AREM-Projets/CdR-2024/README.md

# CdR-2024
Repo contenant l'ensemble des documents liés à la Coupe de France de Robotique (ou CdR pour Coupe de Robotique) 2024.

## Organisation du repo

Le dossier [Generalites](./Generalites) contient l'analyse du règlement ainsi que des ressources diverses. 

Le code, les PCBs et les modélisations 3D sont dans les dossiers PAMIs et Robot, selon leur utilisation.

La documentation associée à chaque partie du projet doit se trouver dans le README du dossier associé.

## Ajout de contenu

N'hésitez pas à ajouter vos tests divers sur ce repo.

Si vous pensez avoir cassé quelque chose, contactez le respo informatique.

## Dates de la CDR : 7 au 11 mai 2024

Merci à tous !!!
