AREM-Projets/CdR-2024/Robot/README.md

# Robot 

## Actionneur

### Informations utiles pour le pôle actionneur

* Hauteur de la bordure de l'aire de jeu: 70 mm

Plantes:
* Hauteur : 100 mm (env)
* Largeur à la base : 40 mm
* Largeur en haut du pot : 50 mm
* Hauteur du pot : 43 mm 

Pot:
* Largeur à la base: 43 mm
* Largeur en haut: 70 mm
* Hauteur: 65 mm
