AREM-Projets/CdR-2024/Generalites/README.md

# Documents et ressources liés à la Coupe de France de Robotique

## Code de l'AREM des anciennes éditions

### [2023](https://github.com/AREM-Projets/robot-CdR-2023)

### [2019-2022](https://gitlab.emse.fr/groups/arem/-/archived)

Vous aurez besoin des droits d'accès au gitlab de l'association pour consulter le code 2019-2022. Demander au respo informatique si besoin.

## Ressources extérieures

### [Maxi-liste de ressources par la team VRAC](https://github.com/VRAC-team/la-maxi-liste-ressources-eurobot)

### [Liste non exhaustive des capteurs présents au local](https://github.com/AREM-Projets/documentation-capteurs)

### [Formations faites en début d'année](https://github.com/AREM-Projets/formations-CdR-2024)

## Logiciels utiles

### Electronique

- [KiCAD](https://www.kicad.org/download/): logiciel de design de PCB, le lien vous amène directement sur la page de téléchargement

### Modélisation 3D

- [Autodesk Inventor](https://www.autodesk.com/education/edu-software/overview?sorting=featured&page=1) : logiciel pour faire de la modélisation 3D (Windows only)
- [FreeCAD](https://www.freecad.org/downloads.php) : logiciel gratuit pour faire de la modélisation 3D
- [Prusaslicer](https://www.prusa3d.com/page/prusaslicer_424/): site pour télécharger le software PrusaSlicer, vous importez un fichier 3D  et vous le transformez en .gcode pour l'imprimer

### Programmation

- [VSCode](https://code.visualstudio.com/Download) : bon éditeur de texte
- [PlatformIO](https://platformio.org/) : extension VSCode permettant d'envoyer du code sur des $\mu$contrôleurs

## Sites web utiles

### Electronique

- [SnapEda](https://www.snapeda.com/) : pour chercher des symboles, empreintes, modèle 3D et modèle de simulation. Marche tout aussi bien avec Proteus que KiCAD 

### Modélisation 3D

- [GrabCAD](https://grabcad.com/library) : pour chercher uniquement des modèles 3D de type .STEP, à utiliser si vous cherchez des modèles 3D de PCB (buck, NUCLEO...)

### Programmation

When in doubt, RTFM.

- [ducumentation PlatformIO](https://docs.platformio.org/en/latest/)
- [documentation STM32duino](https://github.com/stm32duino/Arduino_Core_STM32/wiki)
