AREM-Projets/CdR-2024/Robot/Code/README.md

# Code du robot CdR 2024

Ne pas créer de projet PlatformIO/CubeIDE directement dans ce dossier.

Créer un dossier contenant le projet à la place. Cela permettra d'avoir plusieurs projets pour les tests de différentes cartes/parties du robot.

Inclure dans ce README une description rapide de chaque projet(1-2 lignes), ainsi que la listes des personnes qui l'ont fait.

## RASPI4

Dossier contenant le code python tournant sur la raspi du robot.

## STM32_capteurs_actionneurs

Dossier contenant le projet STM32CubeIDE pour la carte gérant les capteurs et actionneurs.
