AREM-Projets/CdR-2024/Robot/PCBs/README.md

# PCBs - Robot principal

Chaque PCB doit être dans un dossier séparé. Il doit être présent à la fois sous la forme d'un schéma modifiable et au formt `.pdf` pour facilité de lecture.

Dans ce README, une description rapide (1-2 lignes) de son utilité doit être présente, ainsi que le nom des personnes qui l'ont designé.

# Liste des PCBs

### PCB n°1: ALIM 5V

Le PCB prend en entrée une tension 24V DC et la convertie en une tension 5V DC. On a 3A par buck et 4 ports de sortie JST-XH, soit 6A max au total pour 8 ports de sortie. La tension de sortie des bucks est réglable grâce au potentiomètre. Ce PCB peut donc être utilisé pour d'autres tension d'entrées et de sorties. De même, on peut récupérer directement le 24V pour les moteurs grâce à un port XT-60.  

Desiger : Cyril, Eliott

### PCB n°2: carte de mise en série

Permet de mettre en série deux batteries 12V.

Designer : Eliott
