AREM-Projets/CdR-2024/PAMIs/PCBs/README.md

# PCBs - PAMIs

Chaque PCB doit être dans un dossier séparé. Il doit être présent à la fois sous la forme d'un schéma modifiable et au formt `.pdf` pour facilité de lecture.

Dans ce README, une description rapide (1-2 lignes) de son utilité doit être présente, ainsi que le nom des personnes qui l'ont designé.

# Liste des PCBs

### Nom du PCB

Ca sert à quoi ???

Desiger : Quelqu'un, quelqu'un d'autre...

### Nom du PCB n°2

Et lui il sert à quoi ???

Designer : Lui
