AREM-Projets/CdR-2024/Robot/Modelisations-3D/Embase-2023/README.md

# Embase CdR 2023

Une embase faite pour le robot CdR 2023. 

Le robot était muni de 4 roues mécanum contrôlées par des moteurs pas à pas.

## Améliorations possibles 

- Ajouter un trou pour les fils des moteurs
- Ajouter un espace pour des capteurs effet Hall derrière les moteurs
- Changer les ressorts pour les adapter à un robot de 2-3kg
