AREM-Projets/CdR-2024/Generalites/Poster_cdr/explication_lidar.pdf

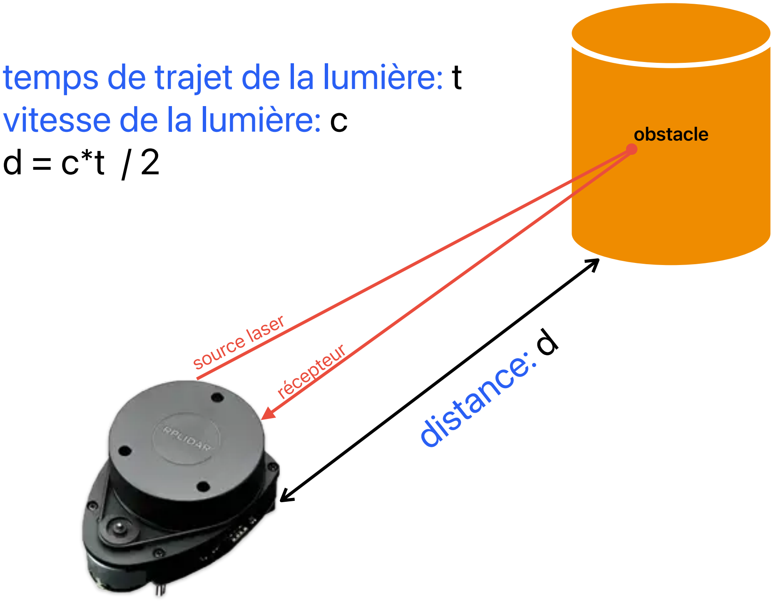
[picture p2: figure]
obstacle; distance: d; temps de trajet de la lumière: t vitesse de la lumière: c d = c*t / 2; source laser récepteur
