AREM-Projets/CdR-2024/Generalites/Poster_cdr/explications_carte_alim.pdf

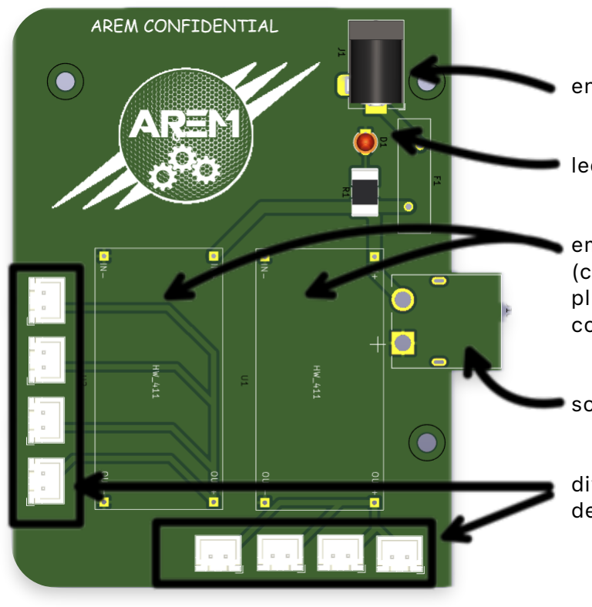
[picture p3: figure]

entrée d'alimentation 24V

led témoin d'alimentation

emplacements BUCs
(conversion 24V en tension plus basse) (tensions
continues)

sortie 24V vers les moteurs

diverses sorties d'alimentation des parties du robot
