AREM-Projets/CdR-2024/Generalites/Poster_cdr/explications_robot_eclate.pdf

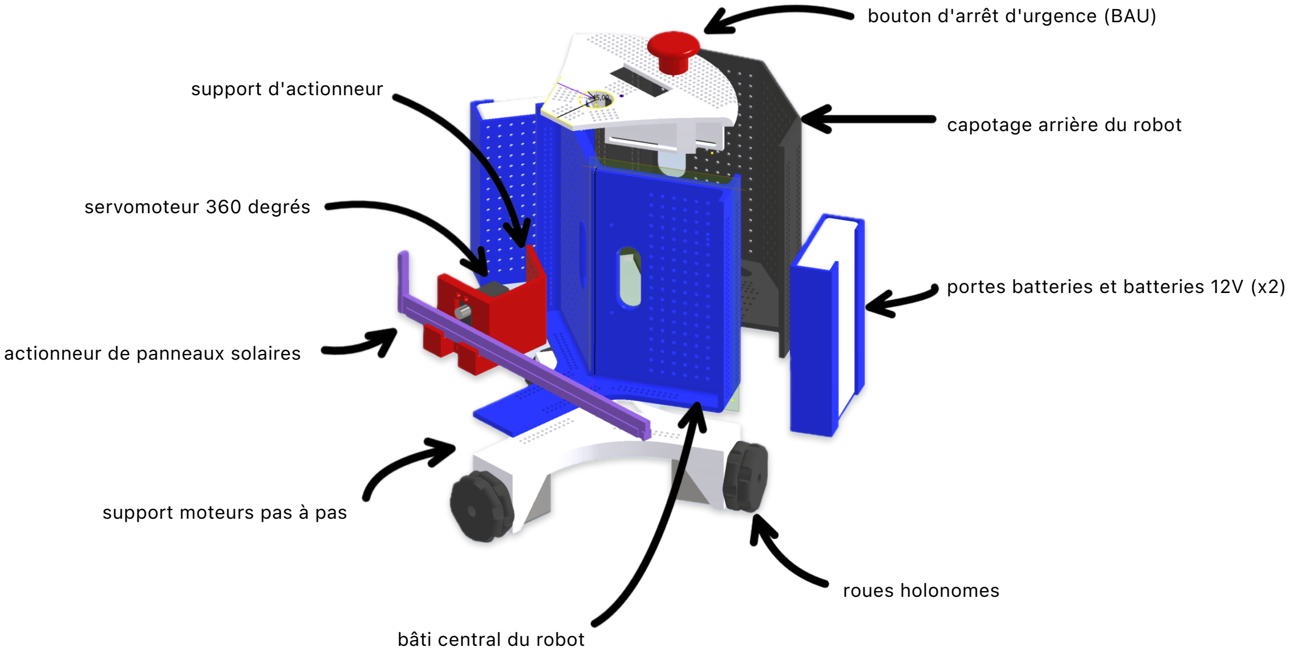
[picture p4: page 1]

bouton d'arrêt d'urgence (BAU)

portes batteries et batteries 12V (x2)

roues holonomes

actionneur de panneaux solaires

support moteurs pas à pas

support d'actionneur

servomoteur 360 degrés

capotage arrière du robot

bâti central du robot
