AREM-Projets/CdR-2024/PAMIs/Conception/Contraintes PAMIs.pdf

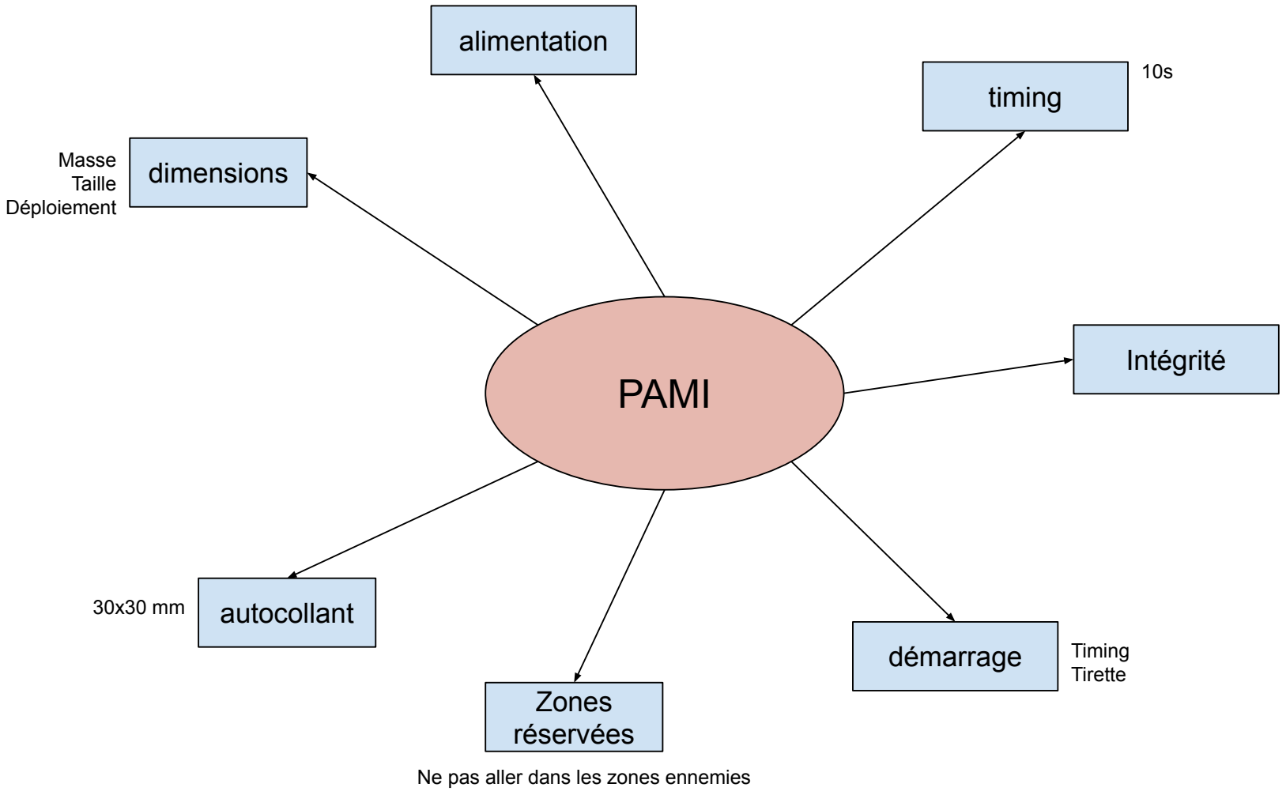
[picture p5: figure]
PAMI; dimensions; alimentation; démarrage; Timing; Tirette; Masse Taille Déploiement; autocollant ³⁰x30 mm; Zones réservées; Ne pas aller dans les zones ennemies; Intégrité; timing
