AREM-Projets/CdR-2024/Robot/Conception/Contraintes robot.pdf

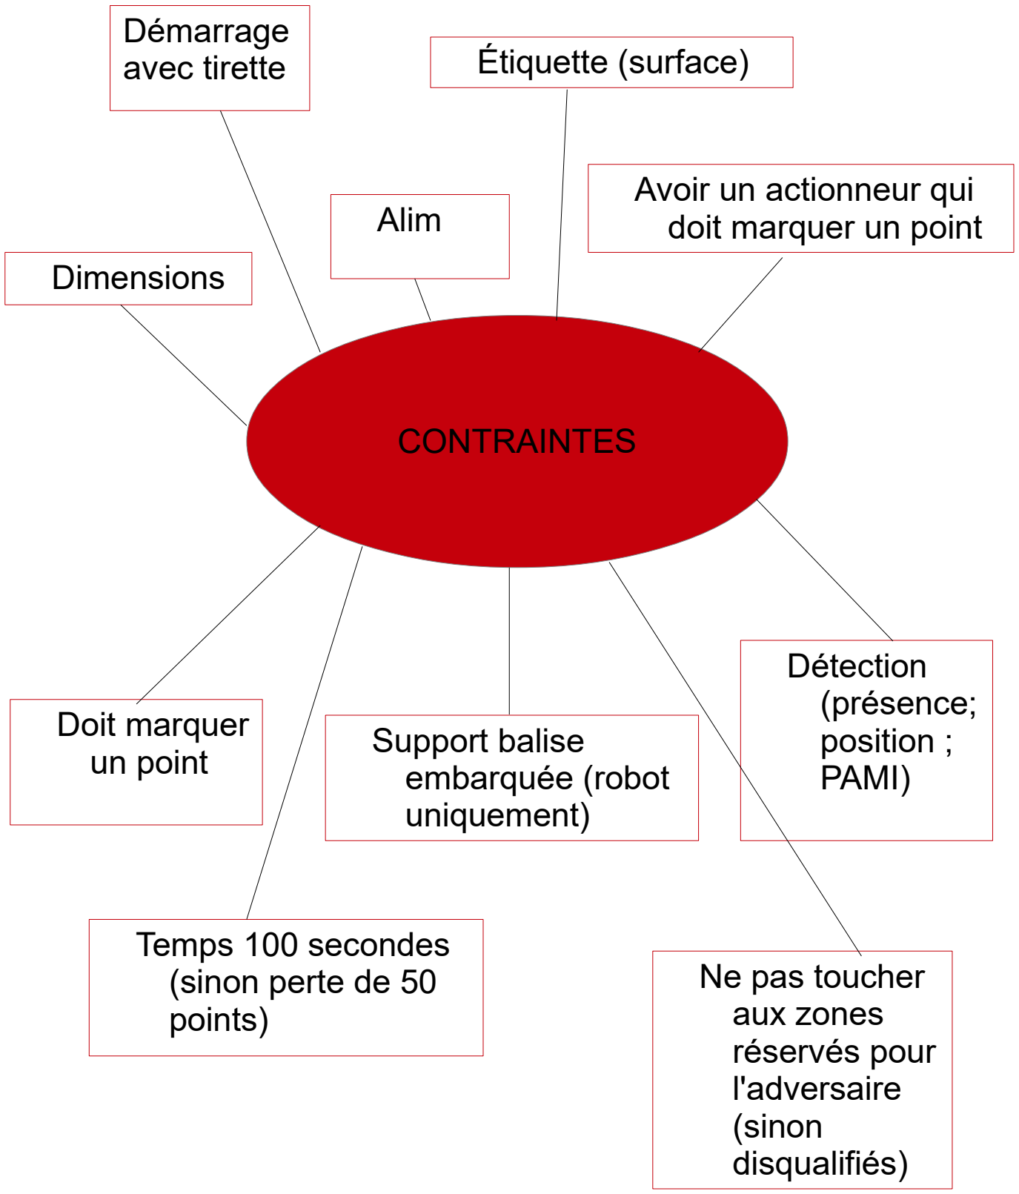
[picture p6: figure]
CONTRAINTES; Dimensions; Alim; Avoir un actionneur qui doit marquer un point; Doit marquer un point; Détection (présence; position ; PAMI); Étiquette (surface); Support balise embarquée (robot uniquement); Démarrage avec tirette; Ne pas toucher aux zones réservés pour l'adversaire (sinon disqualifiés); Temps 100 secondes (sinon perte de 50 points)
