AREM-Projets/CdR-2024/Robot/Code/stm32_to_ros/doc/MotorProfiling.pdf

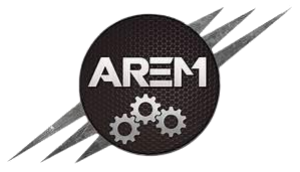
[picture p7: figure]

# [Component Test] Stepper Motor

Date : 08/01/22

Author : Adrien Komaroff-Kourloff

Purpose of the task:

- Principle: Operate the stepper motor that will be used on both robots. Write a brief report on its operation (including the written functions). Find the optimal operating parameters for the motor.
- Objectives: Familiarize yourself with the operation of stepper motors, prepare for their integration into the code.

## Ressources :

To understand the principle of a stepper motor: Stepper Motor Principle (http://ressources.univ-lemans.fr/AccesLibre/UM/Pedago/physique/02/electri/pasapas.html)

For information on micro-stepping: Microstepping Basics (https://www.linearmotiontips.com/microstepping-basics/)

The hardware connections to be made are detailed in the motor shield component test.

## Parameter Optimization

To achieve the best performance with the motors, it is necessary to have a good understanding of the parameters in the BlocMoteurs.h file :

Modify that struct : init for each motor

De L6470_init_t initShield[L6470DAISYCHAINSIZE]

For this purpose, I have adapted the content of this technical document, which is recommended reading: STMicroelectronics Voltage Mode Control Operation and Parameter Optimization. (https://www.st.com/resource/en/application_note/an4144-voltage-mode-control-operation-and-parameter-optimization-stmicroelectronics.pdf)

Please be aware that the library already performs some calculations after filling in L6470_init_t, and the units and quantities in this technical note may not be exactly the same as what needs to be filled in. You should adapt them based on a study of this library and its various functions.

To find the motor parameters, you need to have various parameters available in the motor datasheet and obtain them through measurement.

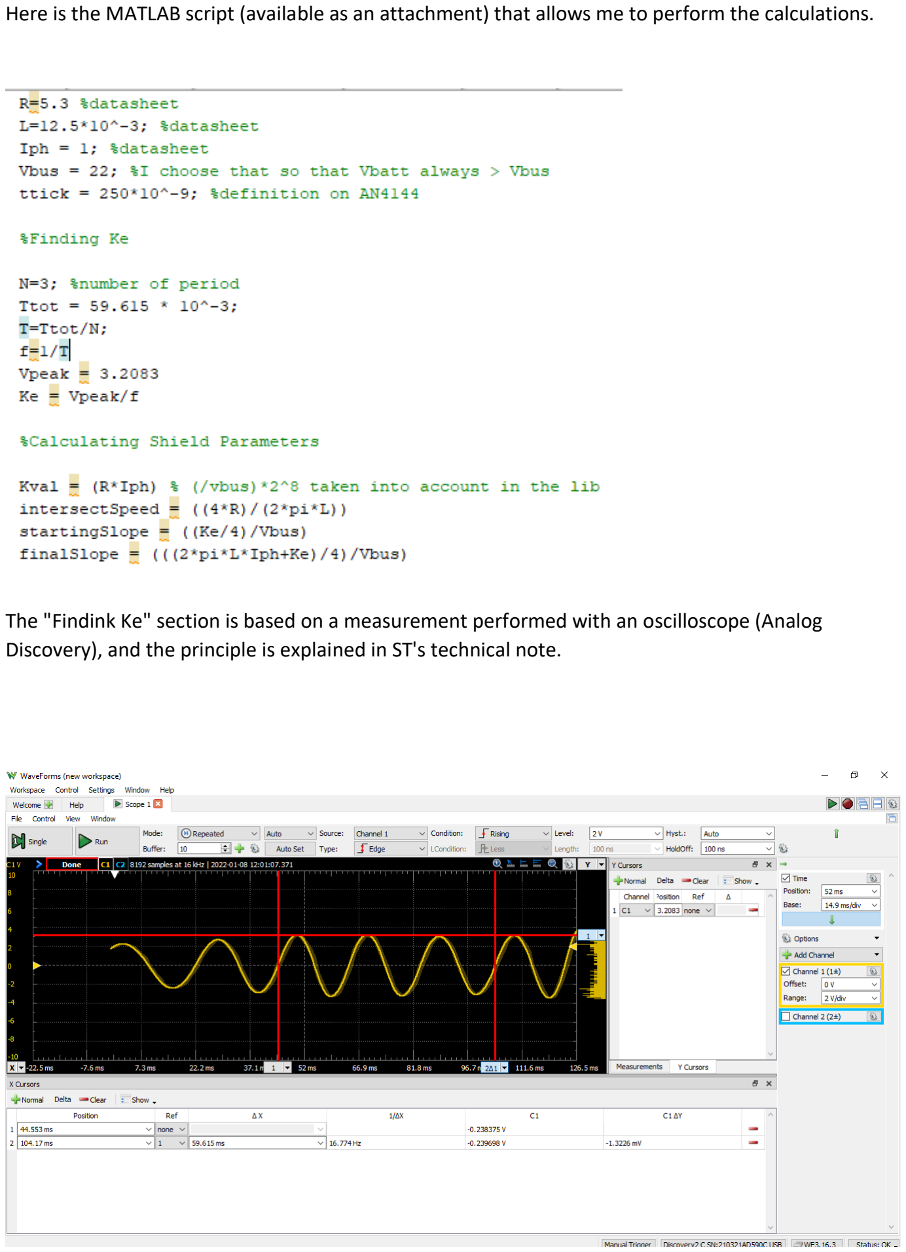
[picture p8: page 2]

Here is the MATLAB script (available as an attachment) that allows me to perform the calculations.

The "Findink Ke" section is based on a measurement performed with an oscilloscope (Analog Discovery), and the principle is explained in ST's technical note.
