AREM-Projets/CdR-2024/PAMIs/Conception/composants.csv

Composant | Taille (en mm) | Contrainte
Batterie | 140 x 67 x 14
Moteurs (x2) | 42 x 42 x 20 | Roues
Nucleo L432KC | 50 x 18 x ?
Drivers A4988 (x2) | 15 x 20 x ?
BAU | 40 x 37 x 73 | Visible du dessus du robot
Roues | ? | Sur le côté, contact au sol
Buck boost | ?
