AREM-Projets/CdR-2024/Robot/Conception/README.md

# Analyse du règlement - Robot pricipal

## Contenu du dossier

- [liste des contraintes](./Contraintes%20robot.pdf)
- [liste des points possibles](./Points%20robot.pdf) ([version éditable](https://docs.google.com/drawings/d/1gmhsv4koyAbkvBtSPPOWJWfmH320co0LOdO_VuSkVMw/edit?usp=sharing))
- [schema elec](https://docs.google.com/drawings/d/1Jy_s9hPUk9P9QnIU7u4mGAbhMcR-9HYQO15R_nWwgCQ/edit?usp=sharing)
