AREM-Projets/CdR-2024/Robot/Modelisations-3D/README.md

# Modèles 3D - Robot CdR 2024

Chaque modèle 3D doit être mis dans un dossier séparé. Les fichiers modifiables ainsi que le `.stl` doivent y être.

Pour chaque modèle, ajouter dans ce README une description(1-2 lignes), ainsi que la listes des personnes qui l'ont fait.

# Liste des modèles 3D

### [Embase-2023](./Embase-2023/)

Embase du robot CdR 2023. Les améliorations possibles sont dans [le README associé](./Embase-2023/README.md).

Créateur : Gauthier Pineda

### [Embase-3-roues-Gauthier](./Embase-3-roues-Gauthier/)

Embase 3 roues créée par Gauthier pour tester les roues Holonum. Vient avec un magnifique [rapport sur la résistance des matériaux](./Embase-3-roues-Gauthier/rapport_rdm.pdf).

Créateur : Gauthier Pineda

### [Support-batterie](./Support-batterie)

Support pour une batterie, qui est fixé par des vis. Agrémenté de son exceptionnel [README](./Support-batterie/README)

Créatrice : Pauline Béranger
