AREM-Projets/CdR-2024/Generalites/Analyse-reglement/README.md

# Analyse du règlement

Le règlement de la CdR 2024 peut se trouver :
- [sur le site officiel](https://www.coupederobotique.fr/edition-2024/le-concours/reglement-2024/)
- [dans ce dossier](./Eurobot2024_Rules_CUP_FR_FINAL.pdf)

L'objectif de ce dossier est d'avoir des ressources qui résument ou schématisent le règlement pour faciliter la conception des robots.

Les ressources spécifiques au robot ou aux PAMIs se trouvent dans leur dossier respectif.

## Liste des ressources

- analyse fonctionnelle du robot à construire
- schéma des contraintes et objectifs pour le robot (voir [Robot](../../Robot/Conception/README.md))
- schéma des contraintes et objectifs pour les PAMIs (voir [PAMIs](../../PAMIs/Conception/README.md))
- [calculatrice de score](https://cdr-score.netlify.app/#/2024), par l'équipe ARIG
- [cahier des charges](https://docs.google.com/spreadsheets/d/1i9yqzbxxjoHJ5d2Z0rLyOdNfti14u90X9DAD5YJj5Ws/edit#gid=0) (éditable, si vous voyez une erreur corrigez la)
