AREM-Projets/CdR-2024/PAMIs/Modelisations-3D/README.md

# Modèles 3D - PAMIs CdR 2024

Chaque modèle 3D doit être mis dans un dossier séparé. Les fichiers modifiables ainsi que le `.stl` doivent y être.

Pour chaque modèle, ajouter dans ce README une description(1-2 lignes), ainsi que la listes des personnes qui l'ont fait.

# Liste des modèles 3D

### Exemple

Coffre-fort de l'escape game de l'intégration.  
**Supprimer quand on a autre chose pour le remplacer.**

Créateur : Eliott Perret

### Nom du modèle

Description...

Créateur : Quelqu'un
