AREM-Projets/CdR-2024/Robot/Modelisations-3D/Support-batterie/README.txt

Support batterie

Support réalisé pour la CdR 2024.

Dans le but de maintenir verticalement une batterie grâce à des vis.
