AREM-Projets/CdR-2024/Docs-et-ressources/Analyse-reglement/PAMIs/README.md

# Analyse du règlement - PAMIs

## Contenu du dossier

- [liste des contraintes](./Contraintes%20PAMIs.pdf) ([version éditable](https://docs.google.com/drawings/d/1aNA5bNJc2DdUMf7WPIdK8QOshezXf-j2Hv97i4UfBy4/edit?usp=sharing))
- liste des points possibles (pas fini)
- [spreadsheet des idées](https://docs.google.com/spreadsheets/d/1GuigQY19NkE2jPr05z4DLiZ8AFi4P-pAyoT_fMEKkbg/edit?usp=sharing)

**Merci de rajouter toute idée liée aux PAMIs sur le spreadsheet associé**.

Vous pouvez aussi envoyer vos idées sur [le salon PAMI du discord](https://discord.gg/RnYkBRJE7z).
