AREM-Projets/CdR-2024/Generalites/Poster_cdr/explications_embase.pdf

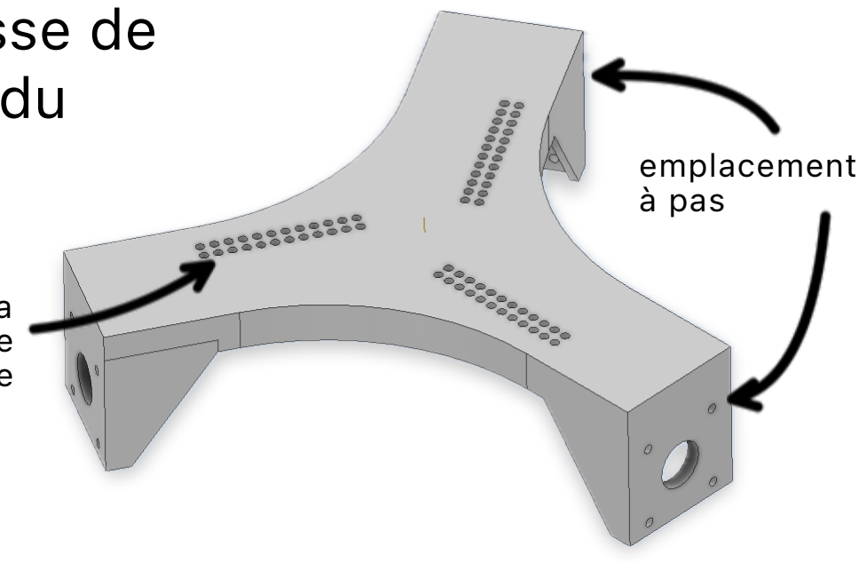
[picture p14: figure]
à pas

emplacements moteurs pas

fixations de la
partie supérieure
de l'embase

# Partie basse de l'embase du robot
