AREM-Projets/CdR-2024/Robot/Conception/Points robot.pdf

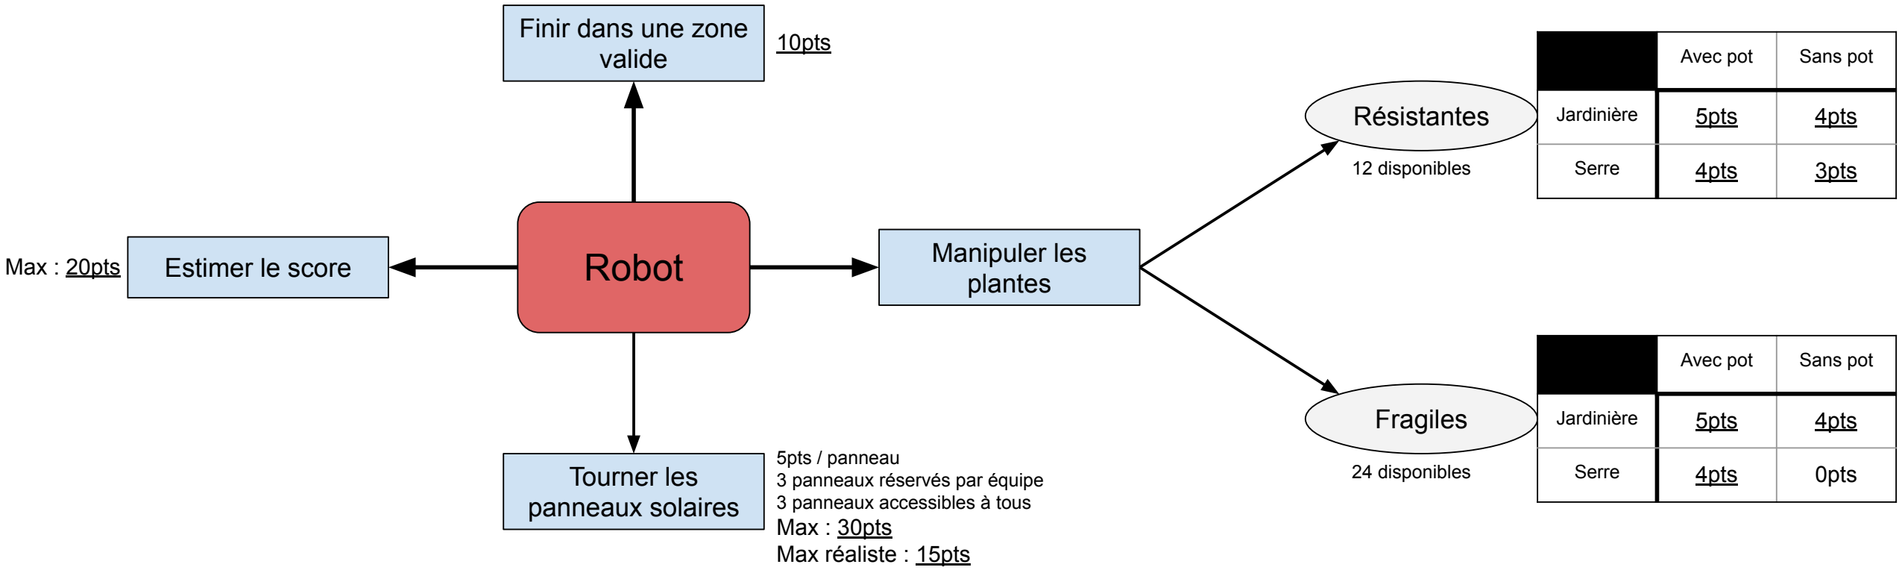
[picture p15: figure]
Estimer le score; Robot; Finir dans une zone valide; Tourner les panneaux solaires; Manipuler les plantes; Fragiles; Résistantes; 10pts; Max : 20pts; 5pts / panneau 3 panneaux réservés par équipe 3 panneaux accessibles à tous Max : 30pts Max réaliste : 15pts; Avec pot; Sans pot; Jardinière; 5pts; 4pts; Serre; 3pts; 24 disponibles; 0pts; 12 disponibles
