AREM-Projets/CdR-2024/Generalites/Poster_cdr/cdr_poster_vue_eclatee_robot2.png

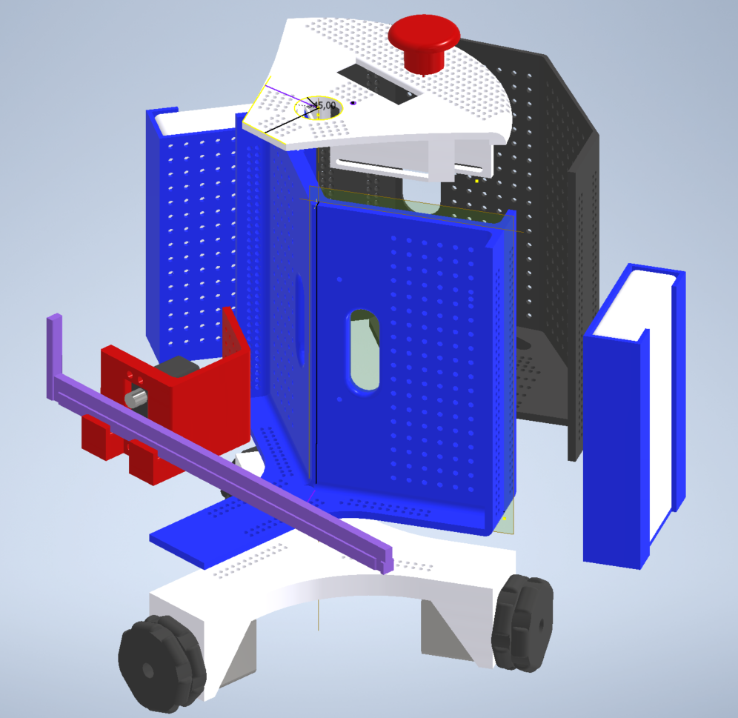
Generalites/Poster_cdr/cdr_poster_vue_eclatee_robot2.png
