AREM-Projets/CdR-2024/Generalites/Poster_cdr/cdr_poster_vue_eclatee_robot.png

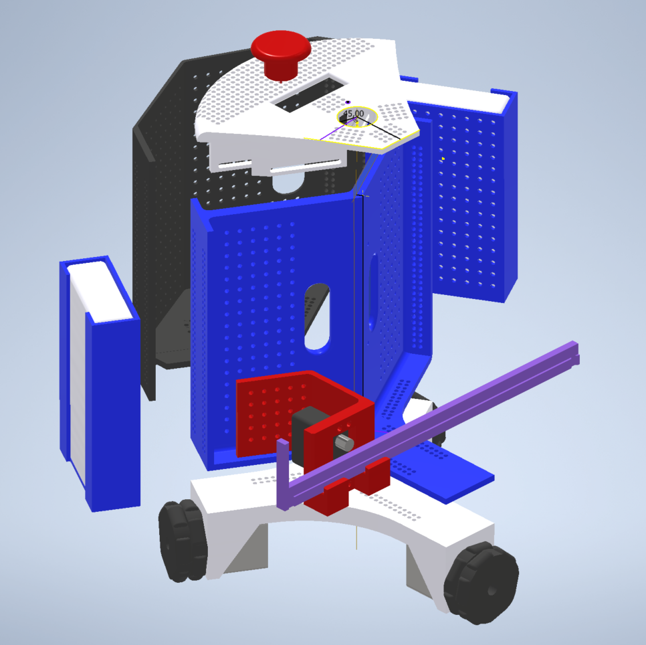
Generalites/Poster_cdr/cdr_poster_vue_eclatee_robot.png
