AREM-Projets/CdR-2024/Generalites/Poster_cdr/explications_carte_alim.png

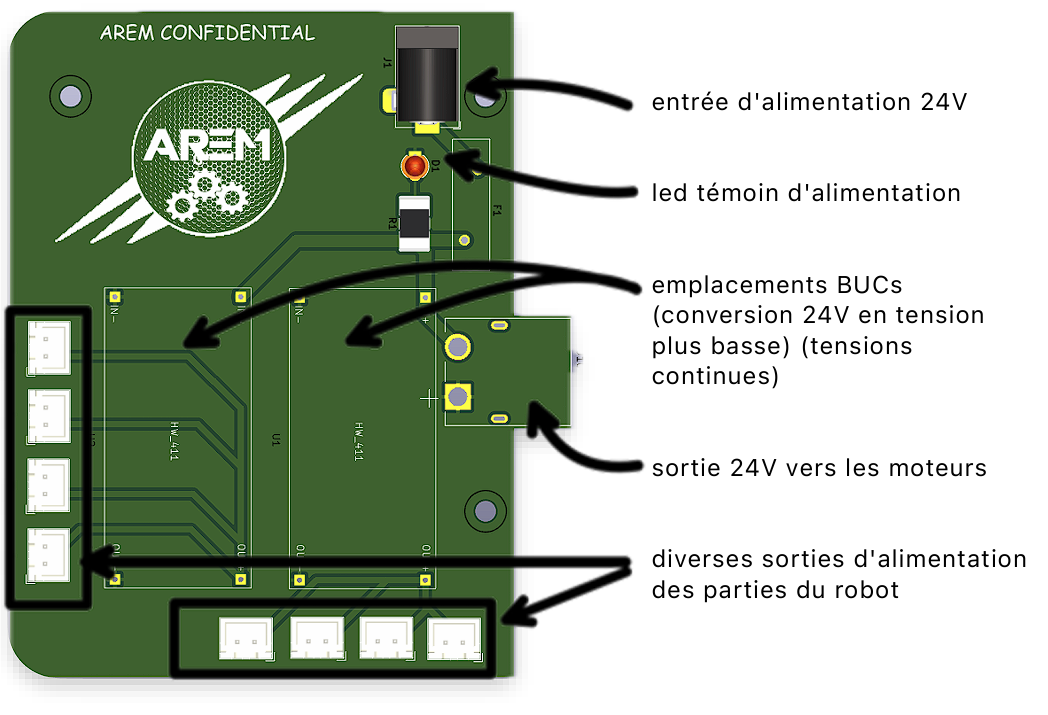
Generalites/Poster_cdr/explications_carte_alim.png
