AREM-Projets/CdR-2024/Generalites/Poster_cdr/explications_embase.png

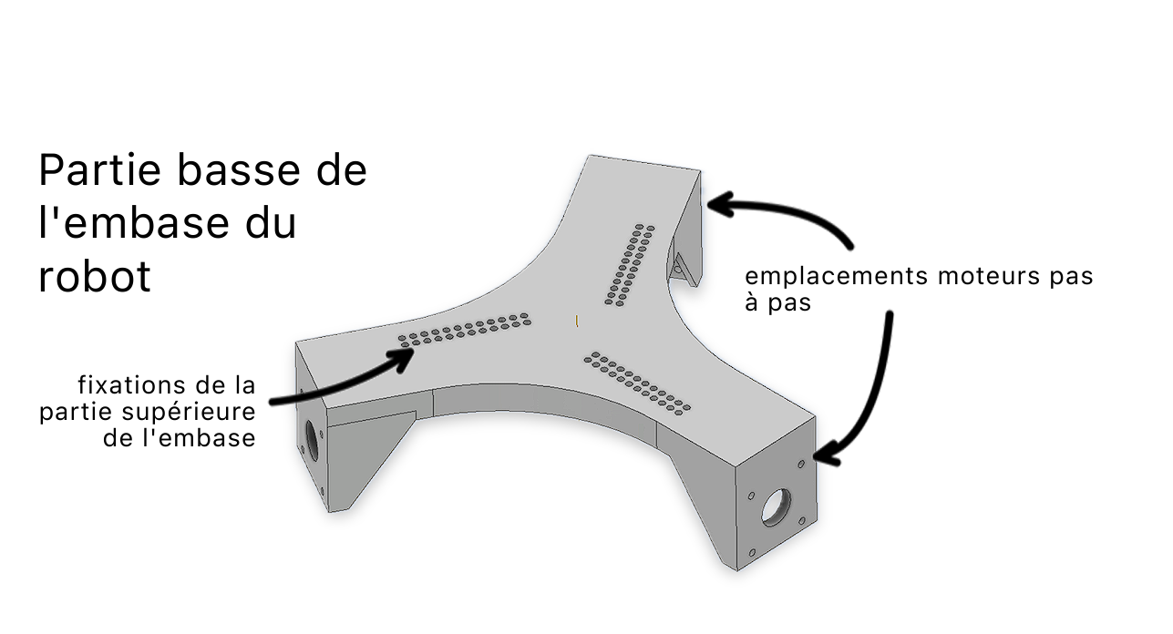
Generalites/Poster_cdr/explications_embase.png
