AREM-Projets/CdR-2024/Generalites/Poster_cdr/explications_lidar.png

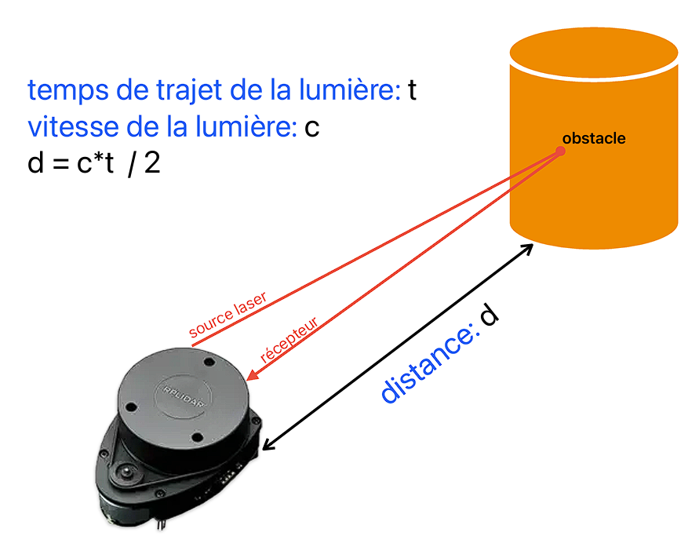
Generalites/Poster_cdr/explications_lidar.png
