AREM-Projets/CdR-2024/Generalites/Poster_cdr/explications_robot_eclate.png

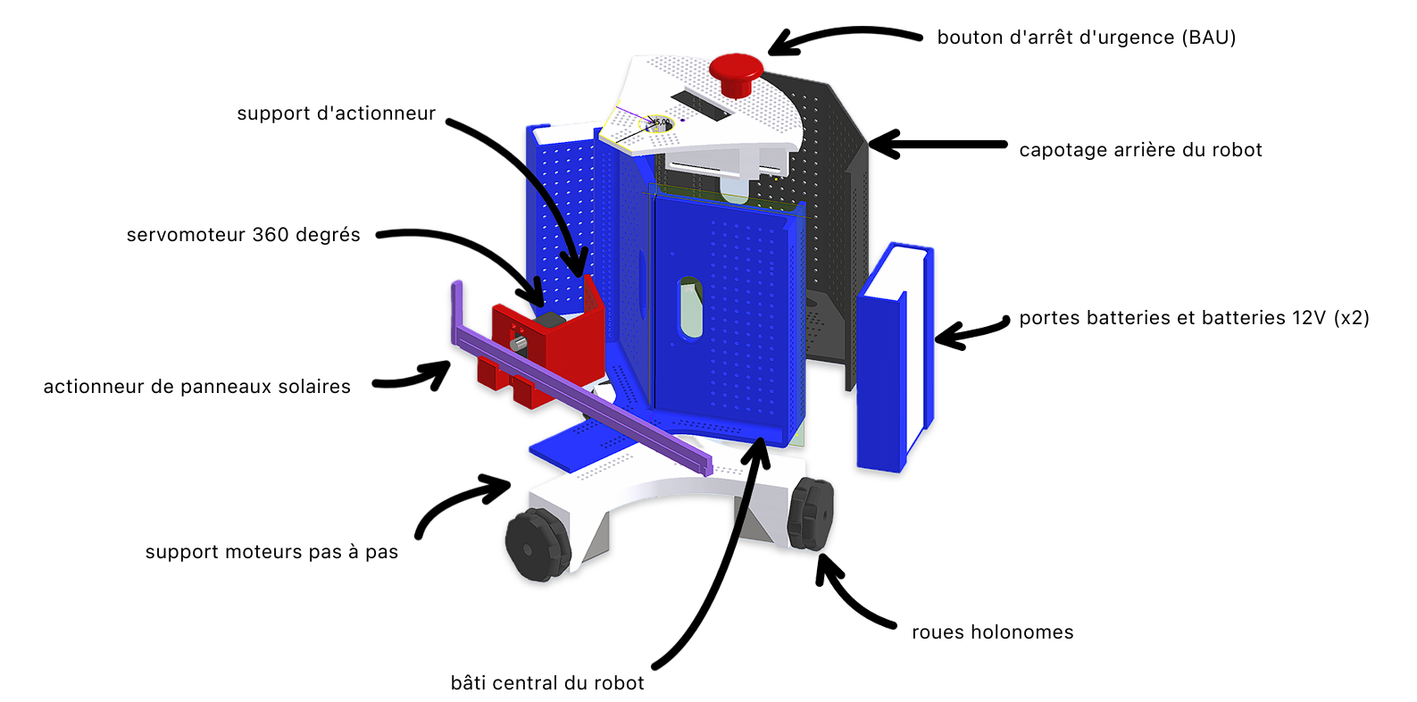
Generalites/Poster_cdr/explications_robot_eclate.png
