AREM-Projets/CdR-2024/Generalites/Poster_cdr/robot.png

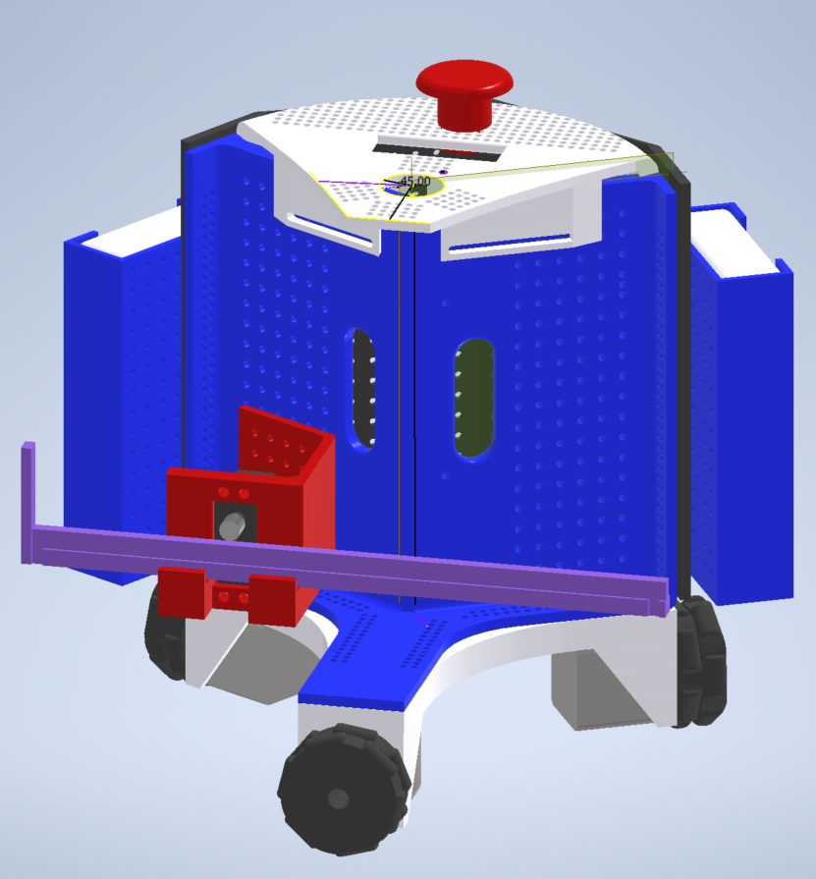
Generalites/Poster_cdr/robot.png
