AREM-Projets/CdR-2024/Generalites/Poster_cdr/robot_eclate_detoure.png

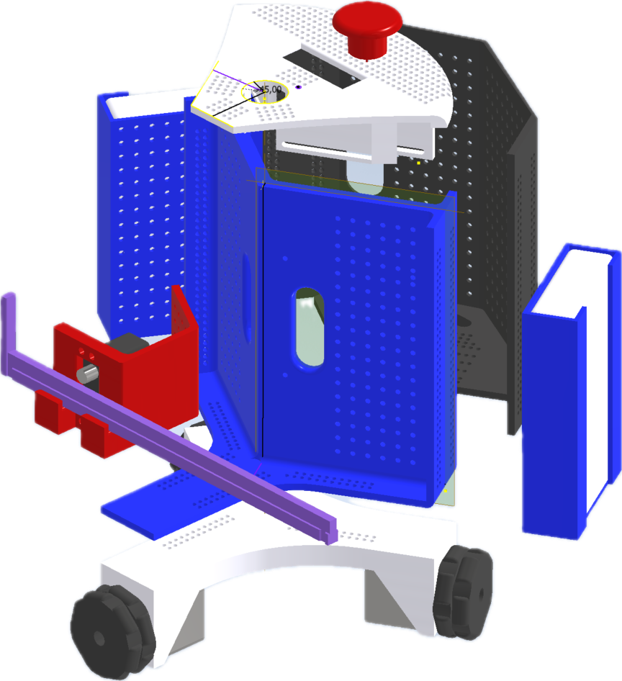
Generalites/Poster_cdr/robot_eclate_detoure.png
