AREM-Projets/CdR-2024/Generalites/Poster_cdr/vue eclatee robot/vue globale robot (sans toit).png

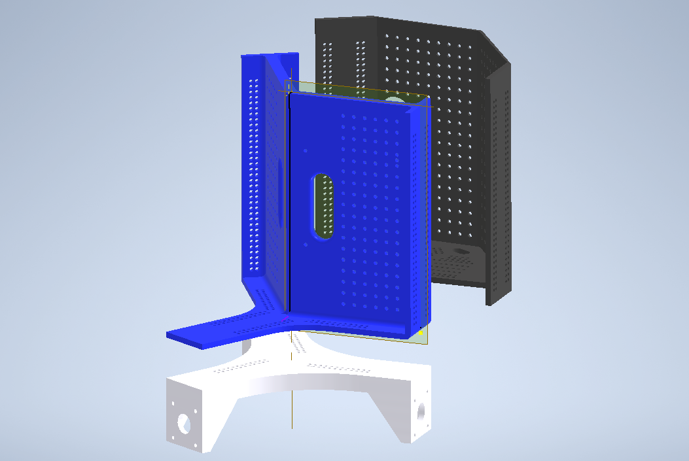
Generalites/Poster_cdr/vue eclatee robot/vue globale robot (sans toit).png
