AREM-Projets/CdR-2024/PAMIs/Modelisations-3D/2_Roues/Roue_pami_V4.stl

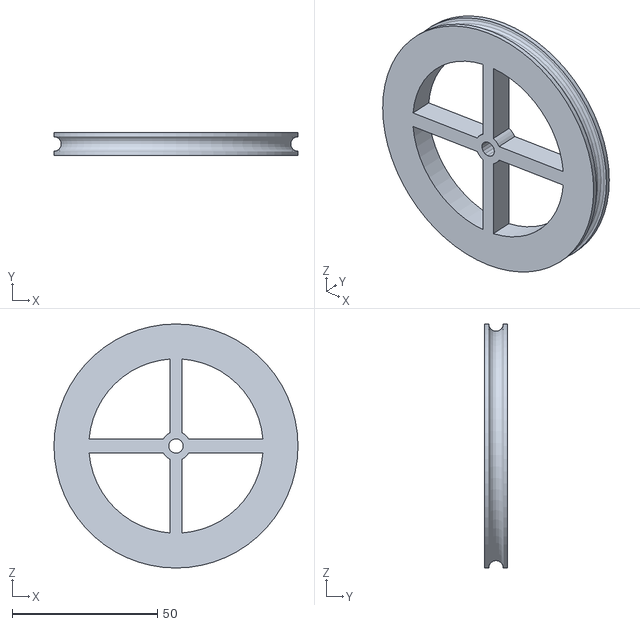
[picture p26: CAD file, 2024-02-10]
PAMIs/Modelisations-3D/2_Roues/Roue_pami_V4.stl
84.0 x 8.00 x 84.0
