AREM-Projets/CdR-2024/PAMIs/Modelisations-3D/3_Exemple/Exemple.stl

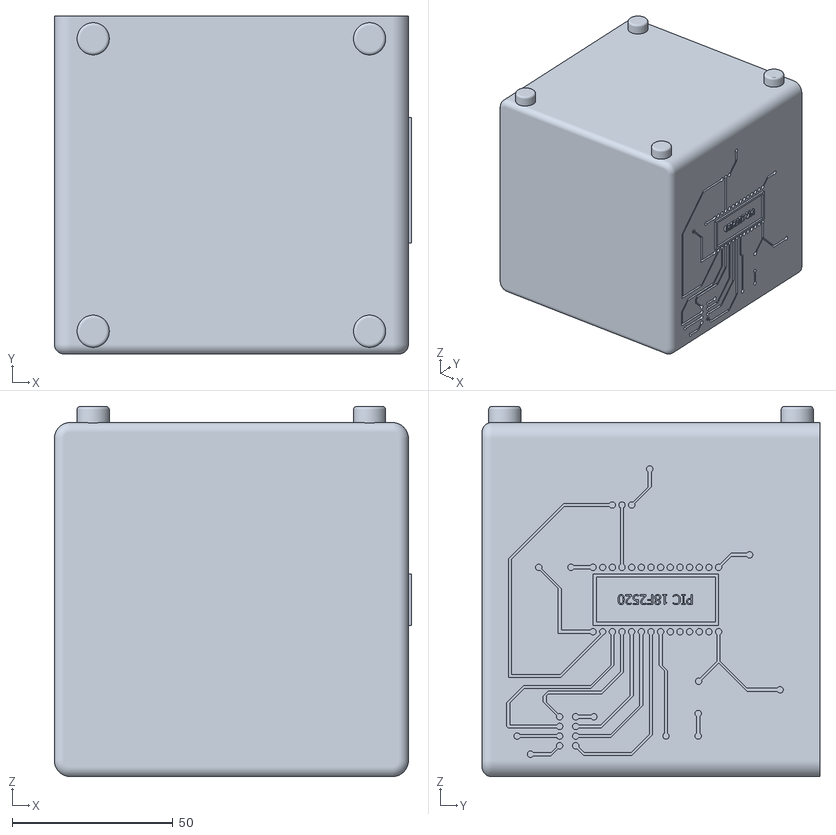
[picture p27: CAD file, 2023-11-17]
PAMIs/Modelisations-3D/3_Exemple/Exemple.stl
111.0 x 105.0 x 115.0
