AREM-Projets/CdR-2024/Robot/Modelisations-3D/Modèles3D_Actionneur_robot_cdr/Pince_motorisee/pince/brazo_2.stl

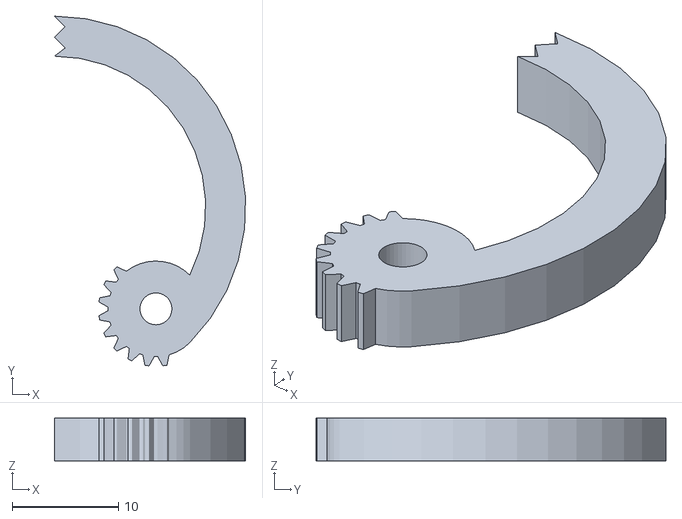
[picture p28: CAD file, 2024-04-22]
Robot/Modelisations-3D/Modèles3D_Actionneur_robot_cdr/Pince_motorisee/pince/brazo_2.stl
18.0 x 32.9 x 4.00
