AREM-Projets/CdR-2024/Robot/Modelisations-3D/Modèles3D_Actionneur_robot_cdr/Pince_motorisee/tete.stl

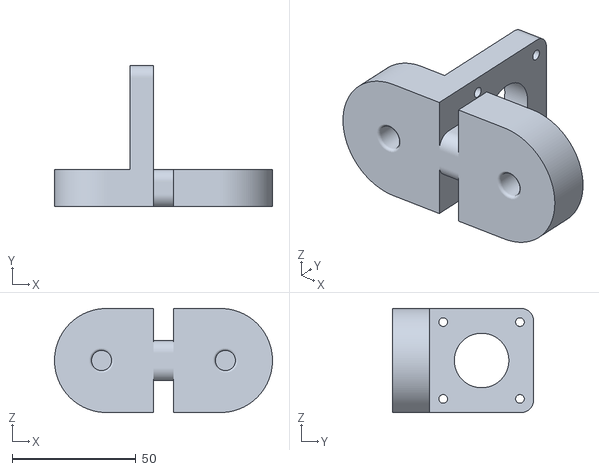
[picture p29: CAD file, 2024-04-22]
Robot/Modelisations-3D/Modèles3D_Actionneur_robot_cdr/Pince_motorisee/tete.stl
88.0 x 57.0 x 42.0
