AREM-Projets/CdR-2024/Robot/Modelisations-3D/Modèles3D_Actionneur_robot_cdr/Tourneur_de_panneaux_solaires/Support2.stl

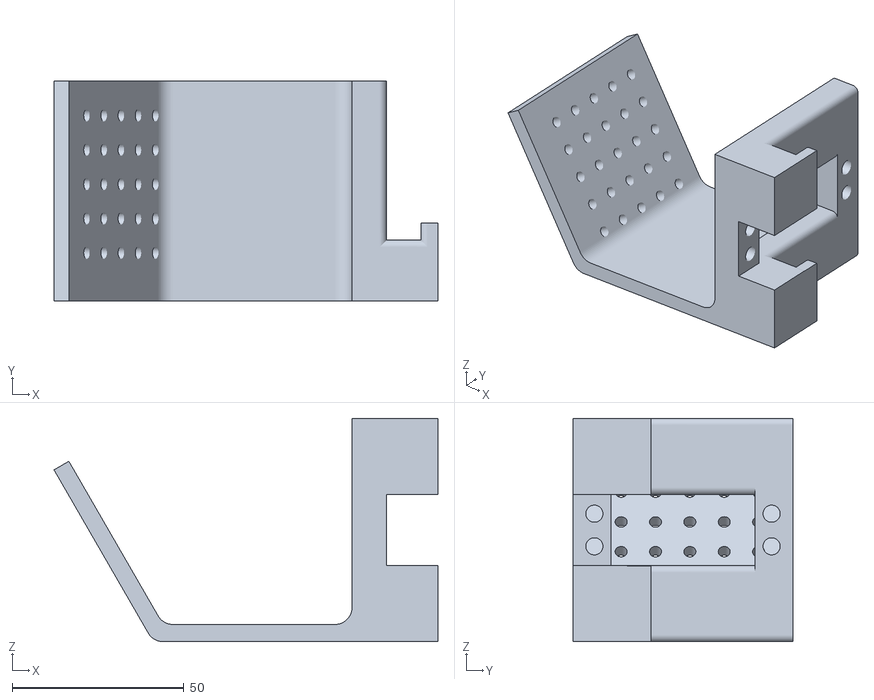
[picture p30: CAD file, 2024-04-22]
Robot/Modelisations-3D/Modèles3D_Actionneur_robot_cdr/Tourneur_de_panneaux_solaires/Support2.stl
111.8 x 64.0 x 65.0
