AREM-Projets/CdR-2024/Robot/Modelisations-3D/Support TOF/support_tof_actionneur_panneaux_solaires.stl

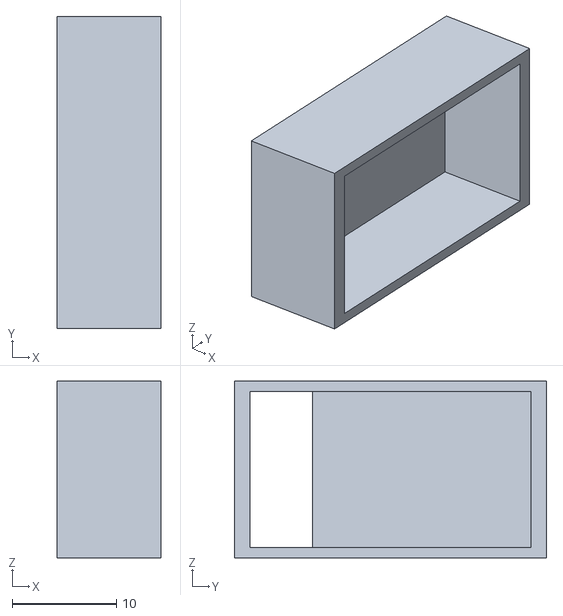
[picture p31: CAD file, 2024-04-22]
Robot/Modelisations-3D/Support TOF/support_tof_actionneur_panneaux_solaires.stl
10.0 x 30.0 x 17.0
