AREM-Projets/CdR-2024/Robot/Modelisations-3D/Tirette/Pièce1.stl

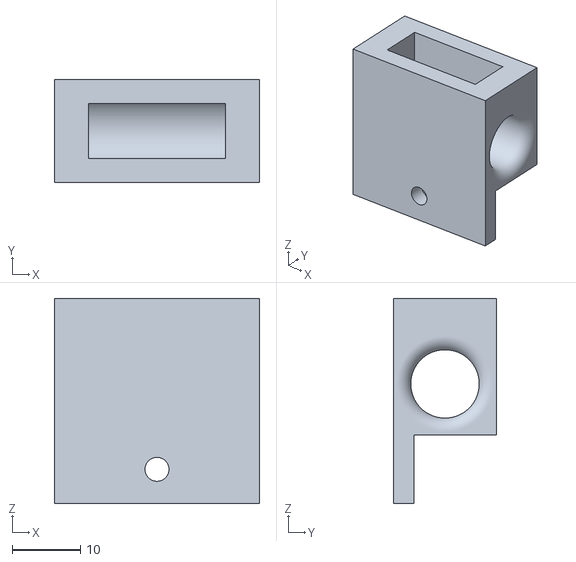
[picture p32: CAD file, 2024-05-06]
Robot/Modelisations-3D/Tirette/Pièce1.stl
30.0 x 15.0 x 30.0
