AREM-Projets/CdR-2024/Robot/Modelisations-3D/Modèles3D_Actionneur_robot_cdr/Pince_motorisee/pince/servo_girado.stl

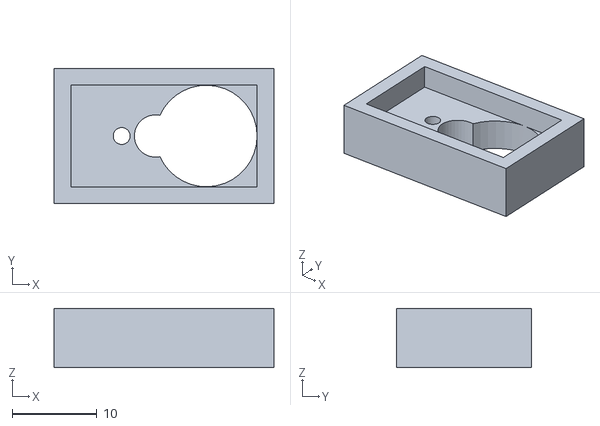
[picture p33: CAD file, 2024-04-22]
Robot/Modelisations-3D/Modèles3D_Actionneur_robot_cdr/Pince_motorisee/pince/servo_girado.stl
26.0 x 16.0 x 7.00
