AREM-Projets/CdR-2024/Robot/Modelisations-3D/Modèles3D_Actionneur_robot_cdr/Tourneur_de_panneaux_solaires/Part11.stl

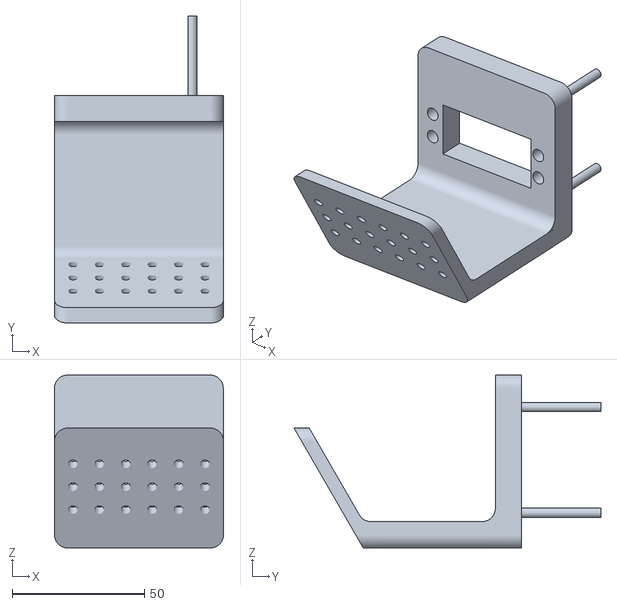
[picture p34: CAD file, 2024-04-22]
Robot/Modelisations-3D/Modèles3D_Actionneur_robot_cdr/Tourneur_de_panneaux_solaires/Part11.stl
64.0 x 116.2 x 65.5
