AREM-Projets/CdR-2024/Robot/Modelisations-3D/Modèles3D_Actionneur_robot_cdr/Pince_motorisee/pince/brazo_1.stl

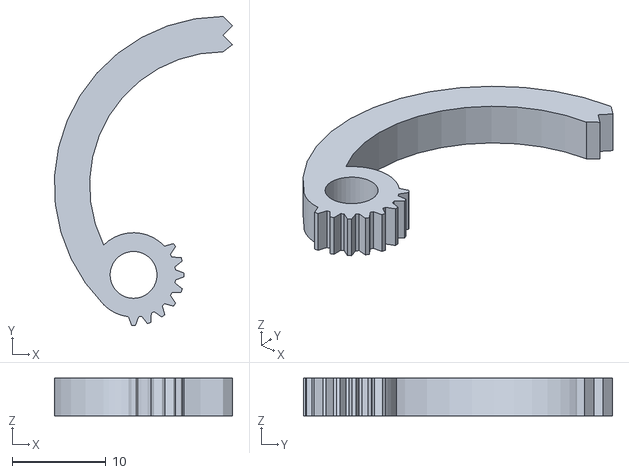
[picture p35: CAD file, 2024-04-22]
Robot/Modelisations-3D/Modèles3D_Actionneur_robot_cdr/Pince_motorisee/pince/brazo_1.stl
19.0 x 32.9 x 4.00
