AREM-Projets/CdR-2024/Robot/Modelisations-3D/Modèles3D_Actionneur_robot_cdr/Tourneur_de_panneaux_solaires/roue.stl

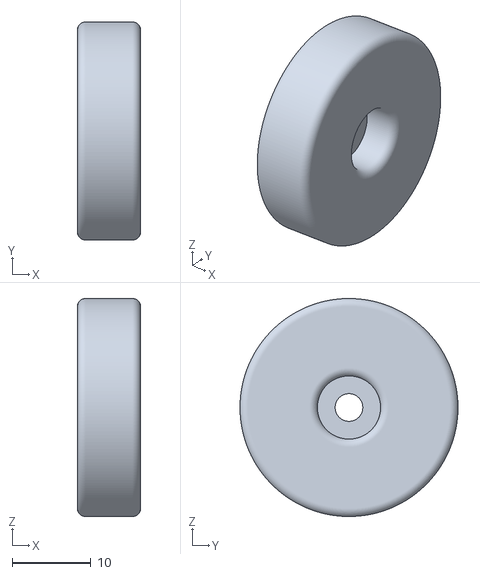
[picture p36: CAD file, 2024-04-22]
Robot/Modelisations-3D/Modèles3D_Actionneur_robot_cdr/Tourneur_de_panneaux_solaires/roue.stl
8.00 x 27.6 x 27.6
