AREM-Projets/CdR-2024/(list of files, cad)

Other CAD files:
Generalites/Poster_cdr/vue eclatee robot/BAU.ipt
Generalites/Poster_cdr/vue eclatee robot/Ensemble1.iam
Generalites/Poster_cdr/vue eclatee robot/OldVersions/Ensemble1.0012.iam
Generalites/Poster_cdr/vue eclatee robot/OldVersions/servomoteur.0001.ipt
Generalites/Poster_cdr/vue eclatee robot/actionneur_Support2.ipt
Generalites/Poster_cdr/vue eclatee robot/actionneur_doigt.ipt
Generalites/Poster_cdr/vue eclatee robot/arbre_d_attache (1).ipt
Generalites/Poster_cdr/vue eclatee robot/batt.ipt
Generalites/Poster_cdr/vue eclatee robot/couvercle_3roues2.ipt
Generalites/Poster_cdr/vue eclatee robot/embase_tricorps_1.0.ipt
Generalites/Poster_cdr/vue eclatee robot/moteur_pasApas.ipt
Generalites/Poster_cdr/vue eclatee robot/mur_extension_2.ipt
Generalites/Poster_cdr/vue eclatee robot/roue.ipt
Generalites/Poster_cdr/vue eclatee robot/roue_actionneur.ipt
Generalites/Poster_cdr/vue eclatee robot/servomoteur.ipt
Generalites/Poster_cdr/vue eclatee robot/support batterie.ipt
PAMIs/Modelisations-3D/1_Base/POUPLY_P1_moteur.ipt
PAMIs/Modelisations-3D/1_Base/POUPLY_P2_base_V2.ipt
PAMIs/Modelisations-3D/1_Base/POUPLY_P3_batterie_support_V2.ipt
PAMIs/Modelisations-3D/1_Base/POUPLY_P4_V3.ipt
PAMIs/Modelisations-3D/1_Base/POUPLY_P5_V2.ipt
PAMIs/Modelisations-3D/1_Base/POUPLY_P6.ipt
PAMIs/Modelisations-3D/1_Base/POUPLY_ROUE.ipt
PAMIs/Modelisations-3D/2_Roues/Roue_pami_V4.ipt
PAMIs/Modelisations-3D/3_Exemple/Exemple.ipt
Robot/Modelisations-3D/Embase-2023/Attache_moteur_3.0_renforcee.ipt
Robot/Modelisations-3D/Embase-2023/Bielette.ipt
Robot/Modelisations-3D/Embase-2023/cache-suspensions.ipt
Robot/Modelisations-3D/Embase-2023/embase_monobloc_renforcee_allegee_e10_1.2.ipt
Robot/Modelisations-3D/Embase-3-roues-Gauthier/embase_tricorps_1.0.ipt
Robot/Modelisations-3D/Modèles3D_Actionneur_robot_cdr/Pince_motorisee/Ensemble1.iam
Robot/Modelisations-3D/Modèles3D_Actionneur_robot_cdr/Pince_motorisee/OldVersions/Ensemble1.0001.iam
Robot/Modelisations-3D/Modèles3D_Actionneur_robot_cdr/Pince_motorisee/OldVersions/bas.0001.ipt
Robot/Modelisations-3D/Modèles3D_Actionneur_robot_cdr/Pince_motorisee/OldVersions/tete.0003.ipt
Robot/Modelisations-3D/Modèles3D_Actionneur_robot_cdr/Pince_motorisee/OldVersions/tete_v2.0001.ipt
Robot/Modelisations-3D/Modèles3D_Actionneur_robot_cdr/Pince_motorisee/Pièce2.ipt
Robot/Modelisations-3D/Modèles3D_Actionneur_robot_cdr/Pince_motorisee/Tige_rail.ipt
Robot/Modelisations-3D/Modèles3D_Actionneur_robot_cdr/Pince_motorisee/bas.ipt
Robot/Modelisations-3D/Modèles3D_Actionneur_robot_cdr/Pince_motorisee/bras_pince_gauche.ipt
Robot/Modelisations-3D/Modèles3D_Actionneur_robot_cdr/Pince_motorisee/servomoteur.ipt
Robot/Modelisations-3D/Modèles3D_Actionneur_robot_cdr/Pince_motorisee/tete.ipt
Robot/Modelisations-3D/Modèles3D_Actionneur_robot_cdr/Pince_motorisee/tete_v2.ipt
Robot/Modelisations-3D/Modèles3D_Actionneur_robot_cdr/Tourneur_de_panneaux_solaires/OldVersions/Part11.0008.ipt
Robot/Modelisations-3D/Modèles3D_Actionneur_robot_cdr/Tourneur_de_panneaux_solaires/OldVersions/Support2.0001.ipt
Robot/Modelisations-3D/Modèles3D_Actionneur_robot_cdr/Tourneur_de_panneaux_solaires/OldVersions/doigt.0010.ipt
Robot/Modelisations-3D/Modèles3D_Actionneur_robot_cdr/Tourneur_de_panneaux_solaires/OldVersions/roue.0007.ipt
Robot/Modelisations-3D/Modèles3D_Actionneur_robot_cdr/Tourneur_de_panneaux_solaires/Part11.ipt
Robot/Modelisations-3D/Modèles3D_Actionneur_robot_cdr/Tourneur_de_panneaux_solaires/Support2.ipt
Robot/Modelisations-3D/Modèles3D_Actionneur_robot_cdr/Tourneur_de_panneaux_solaires/doigt.ipt
Robot/Modelisations-3D/Modèles3D_Actionneur_robot_cdr/Tourneur_de_panneaux_solaires/roue.ipt
Robot/Modelisations-3D/Support TOF/support_tof_actionneur_panneaux_solaires.ipt
Robot/Modelisations-3D/Support-batterie/support batterie.ipt
Robot/Modelisations-3D/Tirette/OldVersions/Pièce1.0002.ipt
Robot/Modelisations-3D/Tirette/Pièce1.ipt
