AREM-Projets/CdR-2024/TODO_CDR2025.md

# TODO list des modifications à apporter au robot et aux PAMIs de la Cdr 2024

## Robot

* Système d'odométrie (codeurs sur les moteur pas à pas de l'embase (+ système de triangulation par balise (à faire) avec le LIDAR))
* Carte d'alim à refaire:
    - une partie coupée par le BAU et une autre non
    - fusionner mise en série et carte d'alim
    - mettre ports pour BAU directement dessus
    - ports d'alim en usb
* Support LIDAR et mat de balise à refaire en noir
* Toît à refaire sur le robot
* Bouton sélecteur équipe
* Code de l'embase propre

- racheter un chargeur de batt et deux autres batt
- encodeurs pour moteurs pas à pas

## PAMIs

* Revoir l'ordre de conception
    * définir strat
    * conceptualiser le pami
    * acheter les composants

* moteurs cc
* capteurs TOF (cf code actionneur robot cdr2024)
