AREM-Projets/CdR-2024/Robot/Modelisations-3D/Embase-3-roues-Gauthier/rapport_rdm.pdf

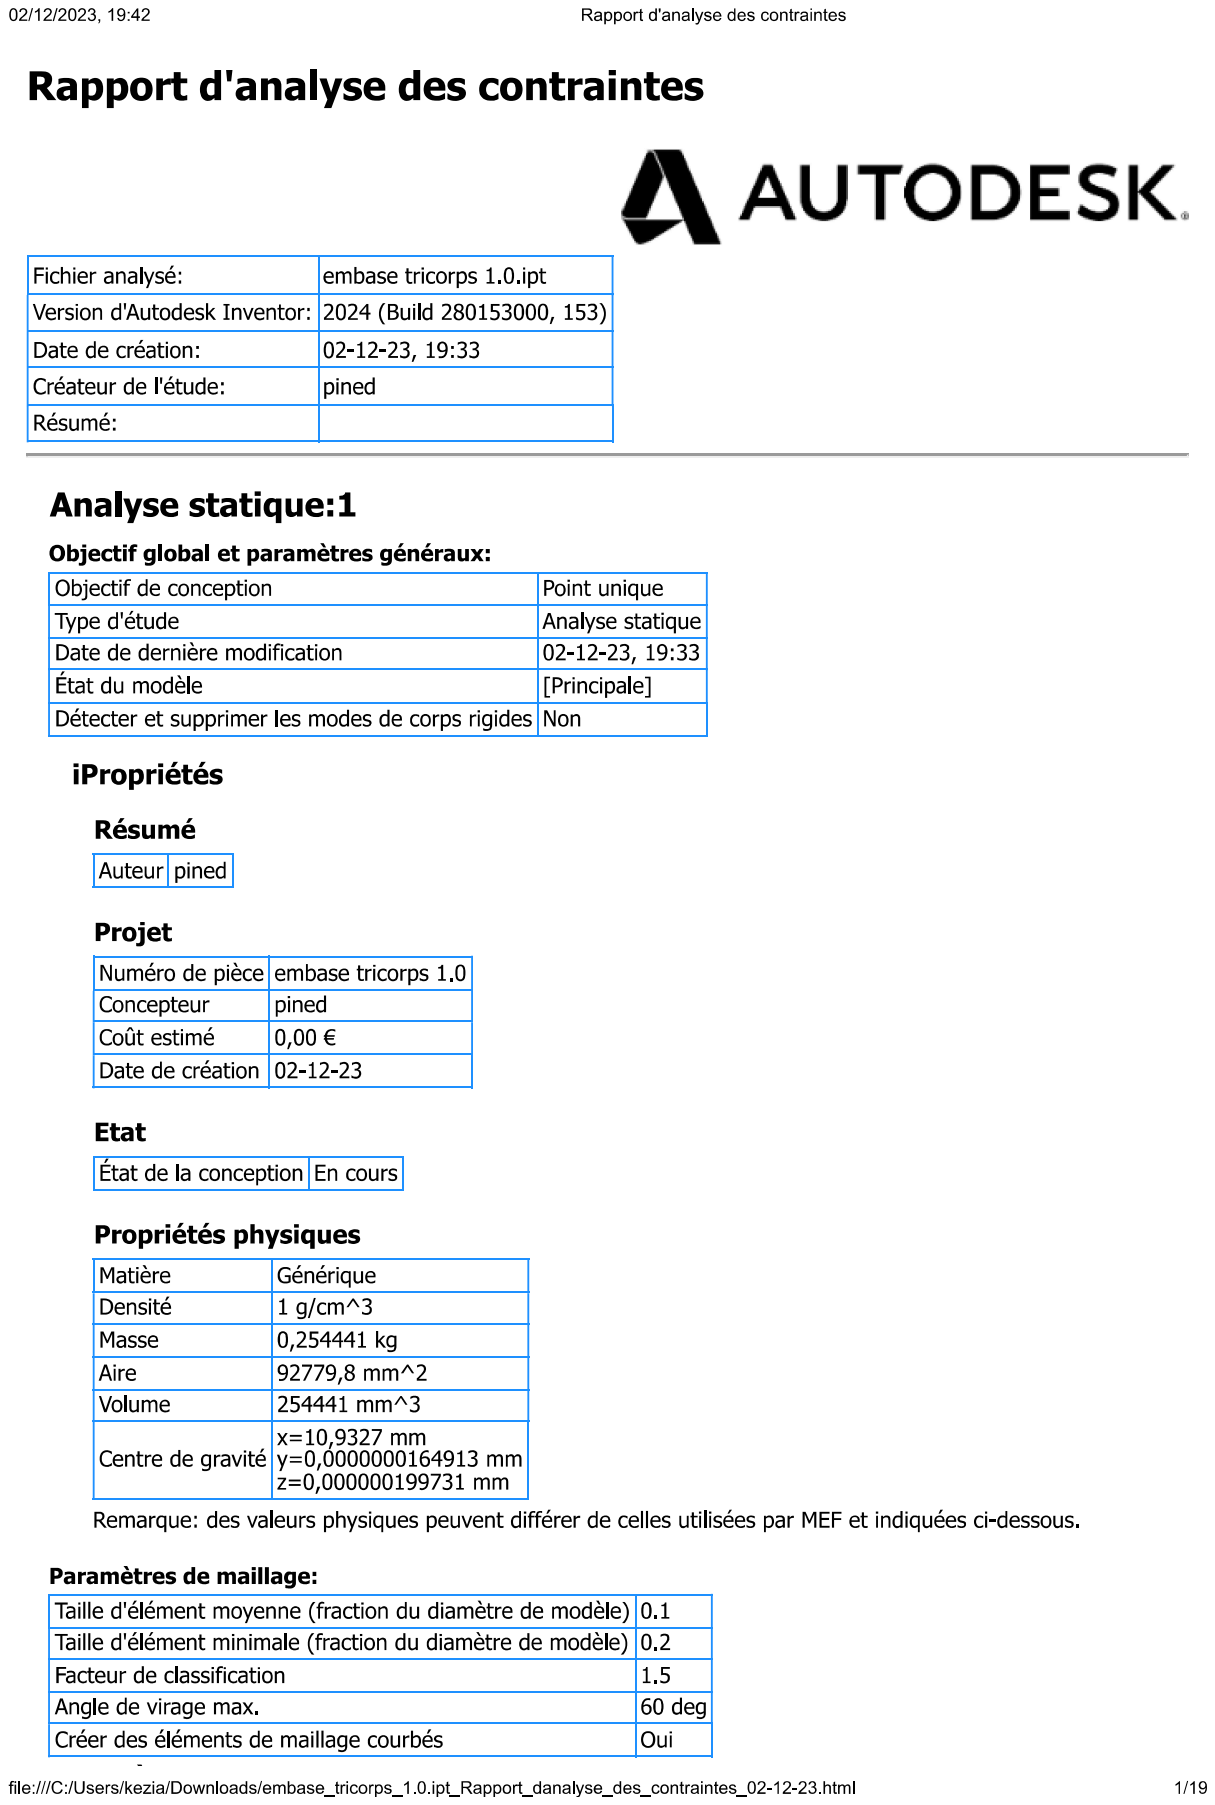
[picture p37: page 1]

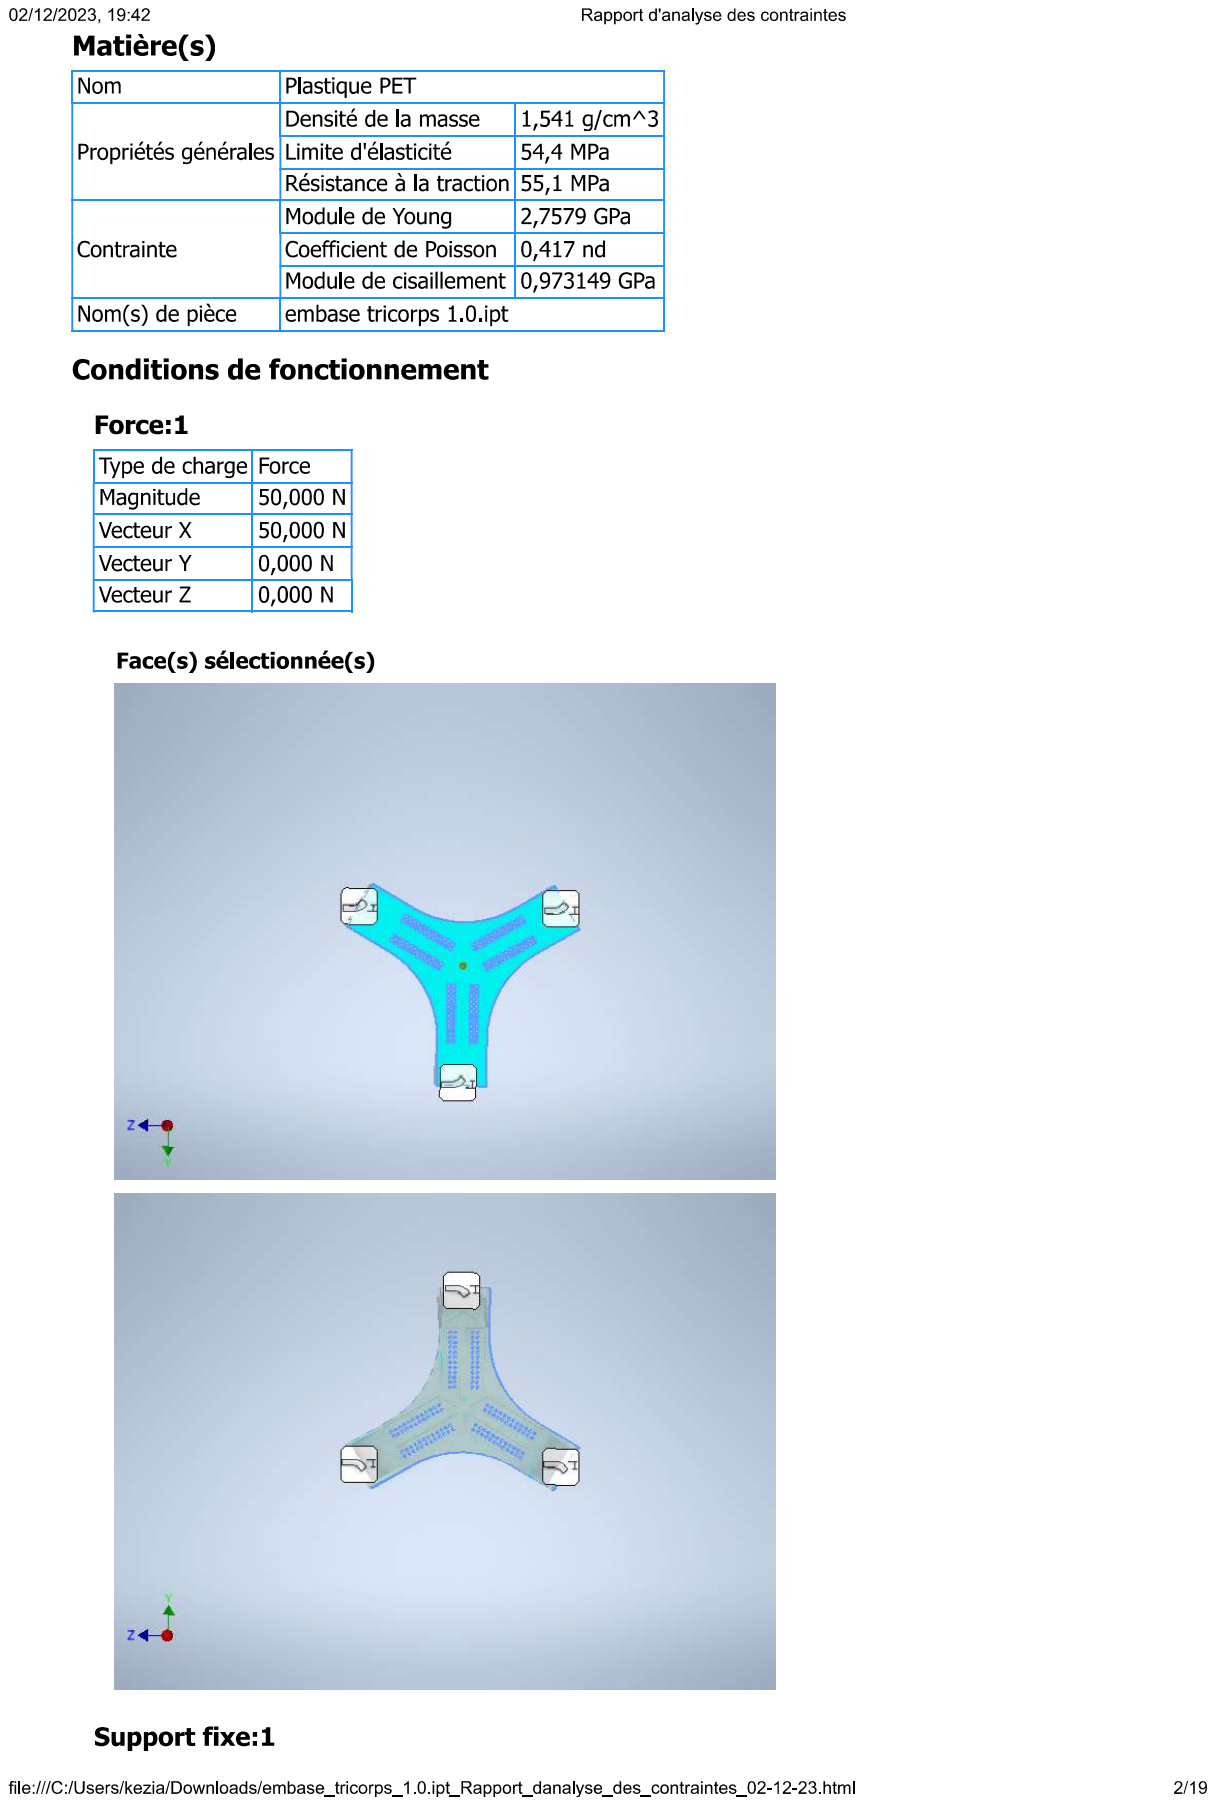
[picture p38: page 2]

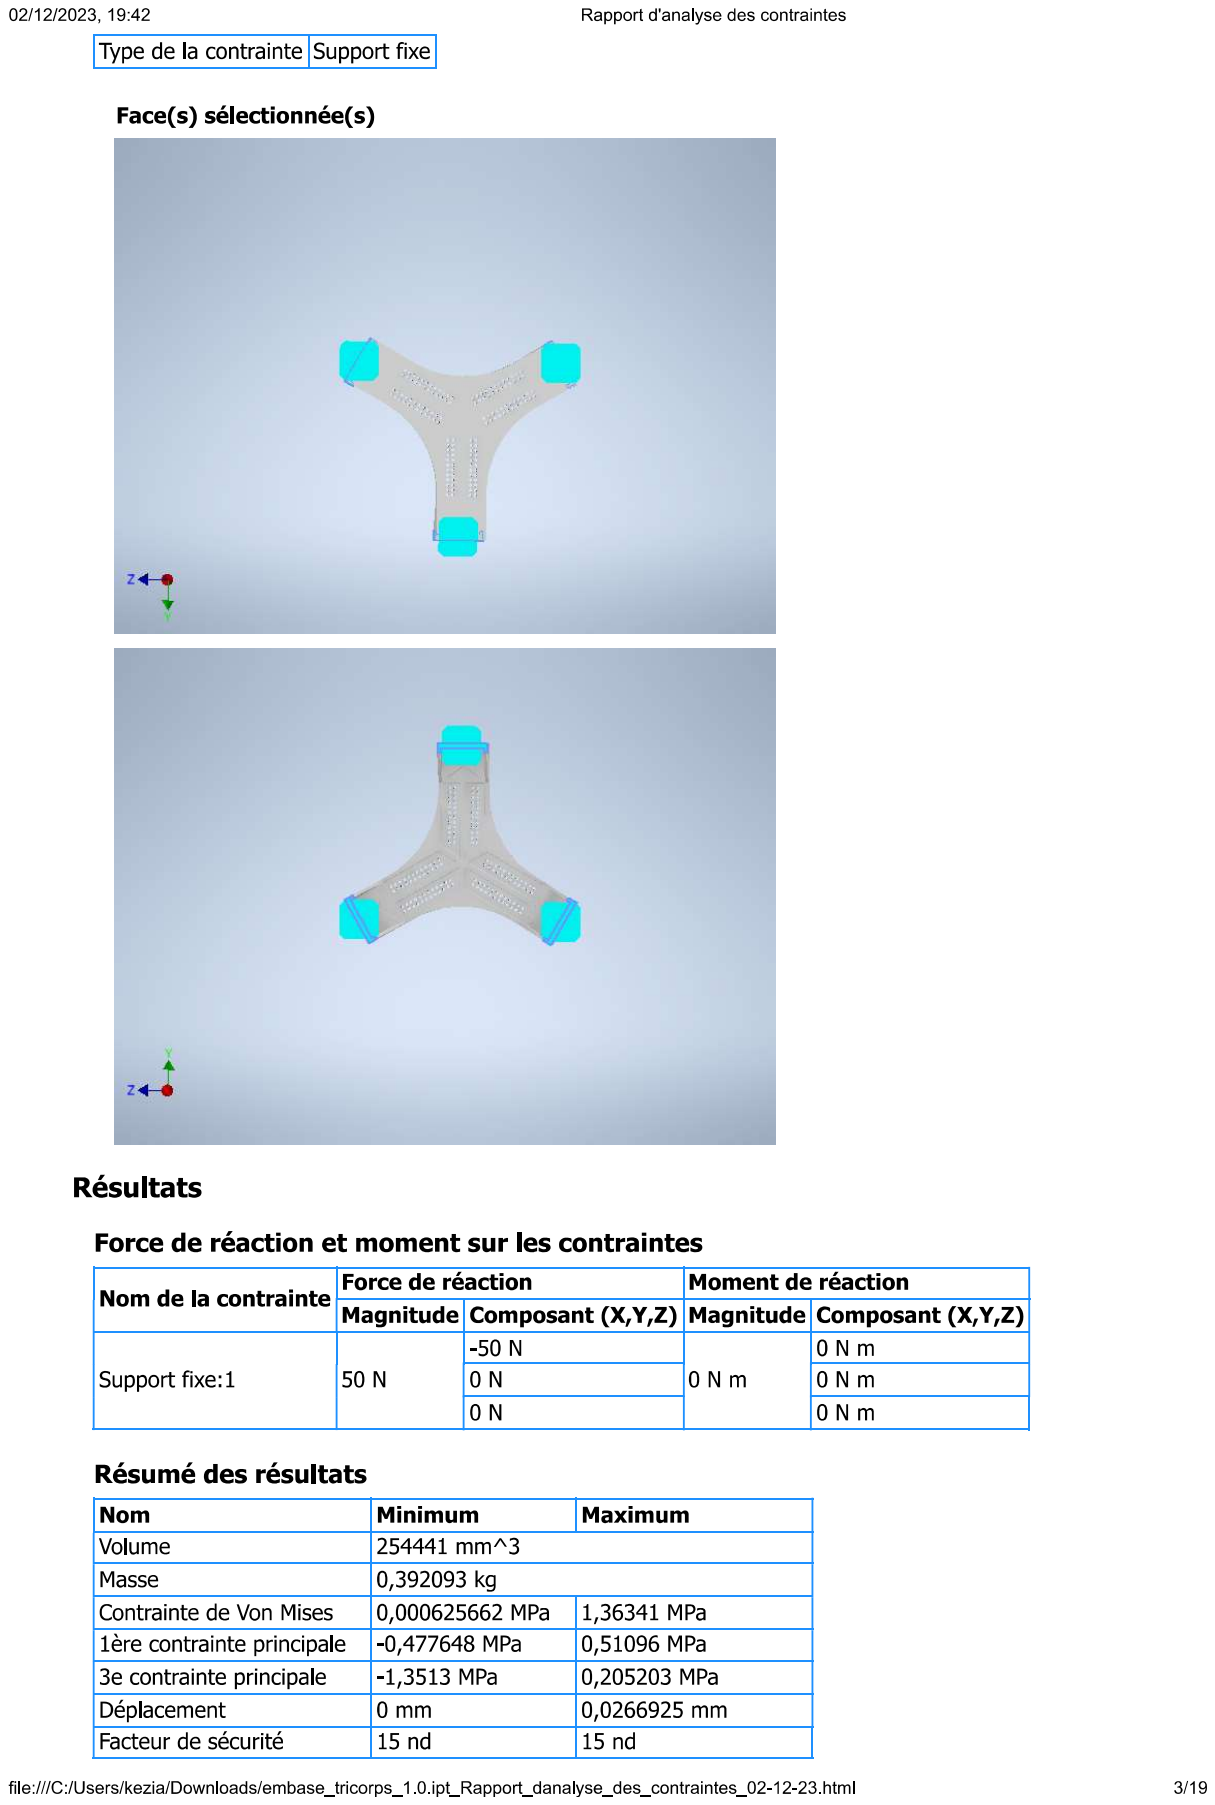
[picture p39: page 3]

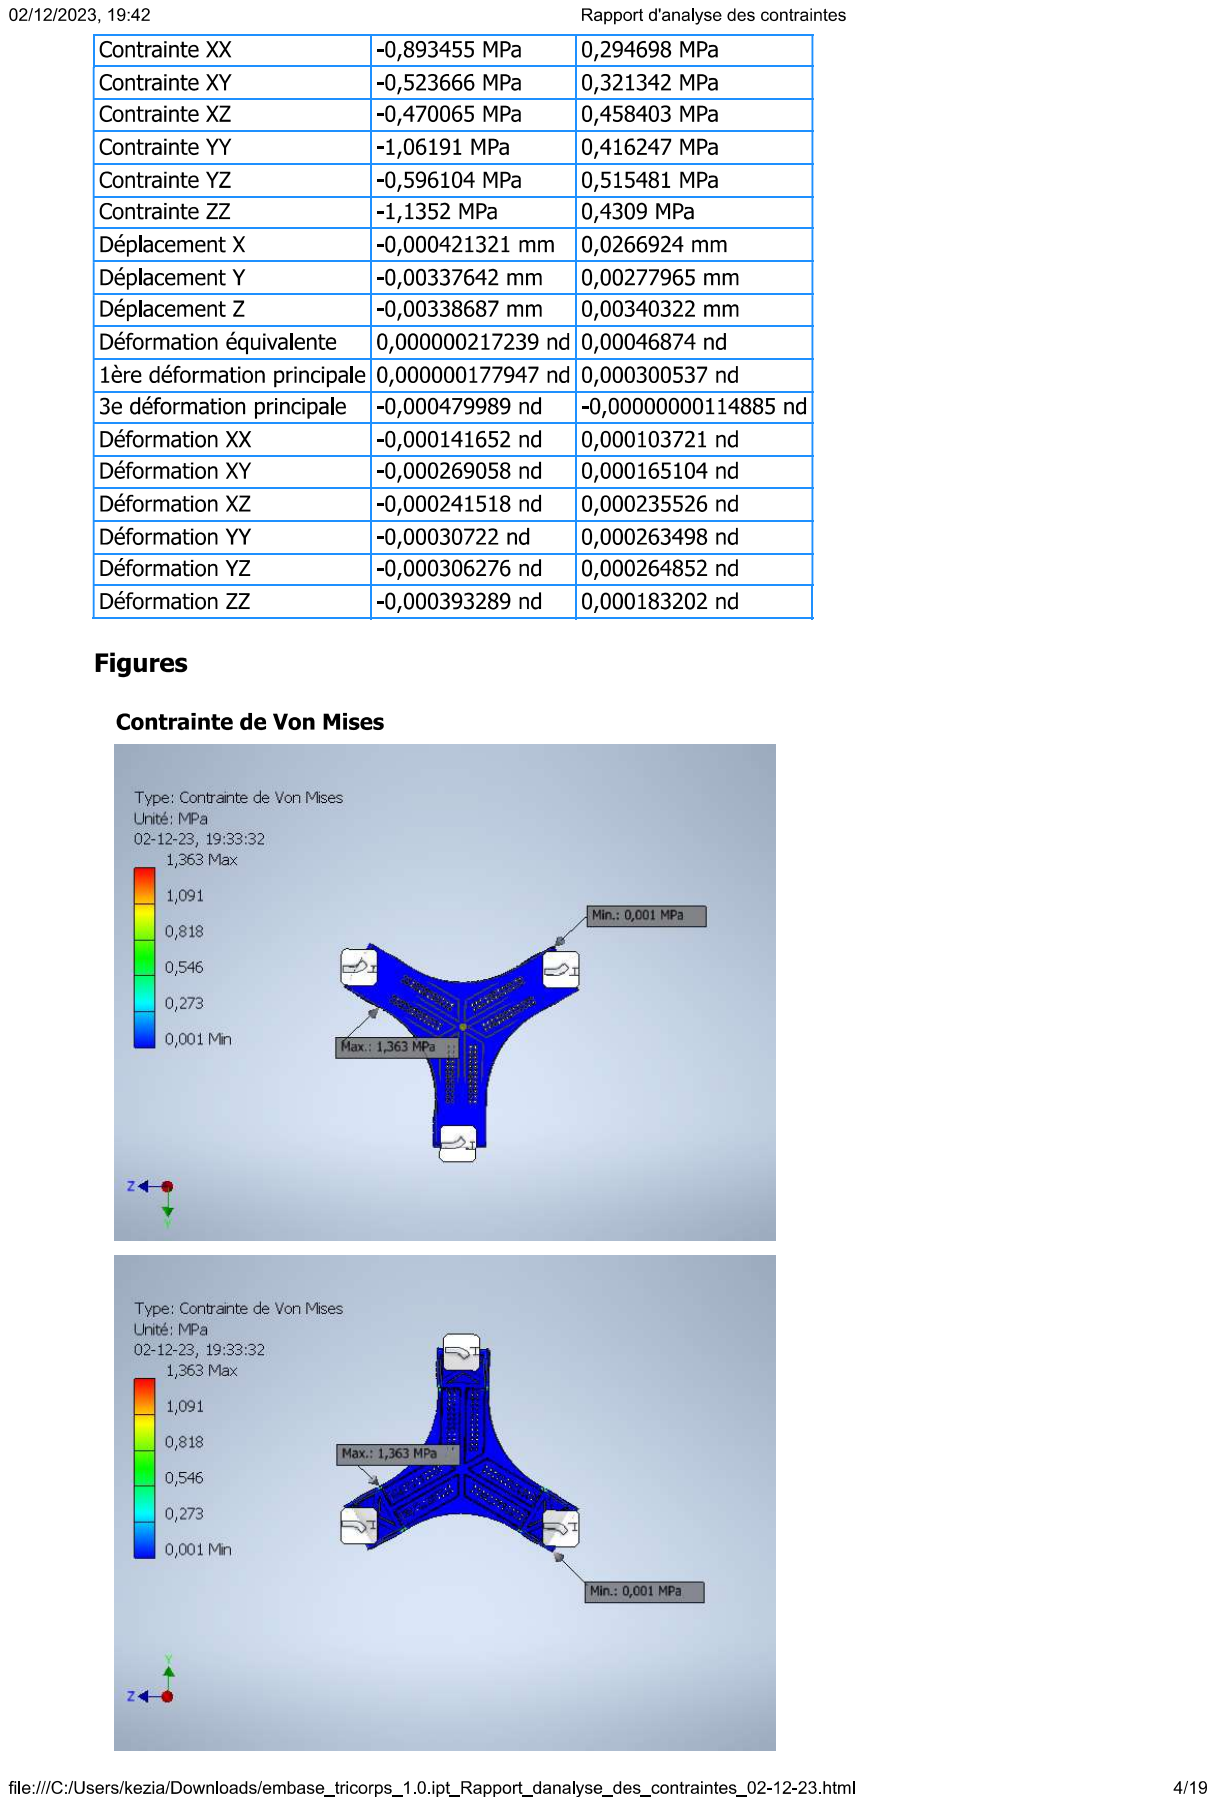
[picture p40: page 4]

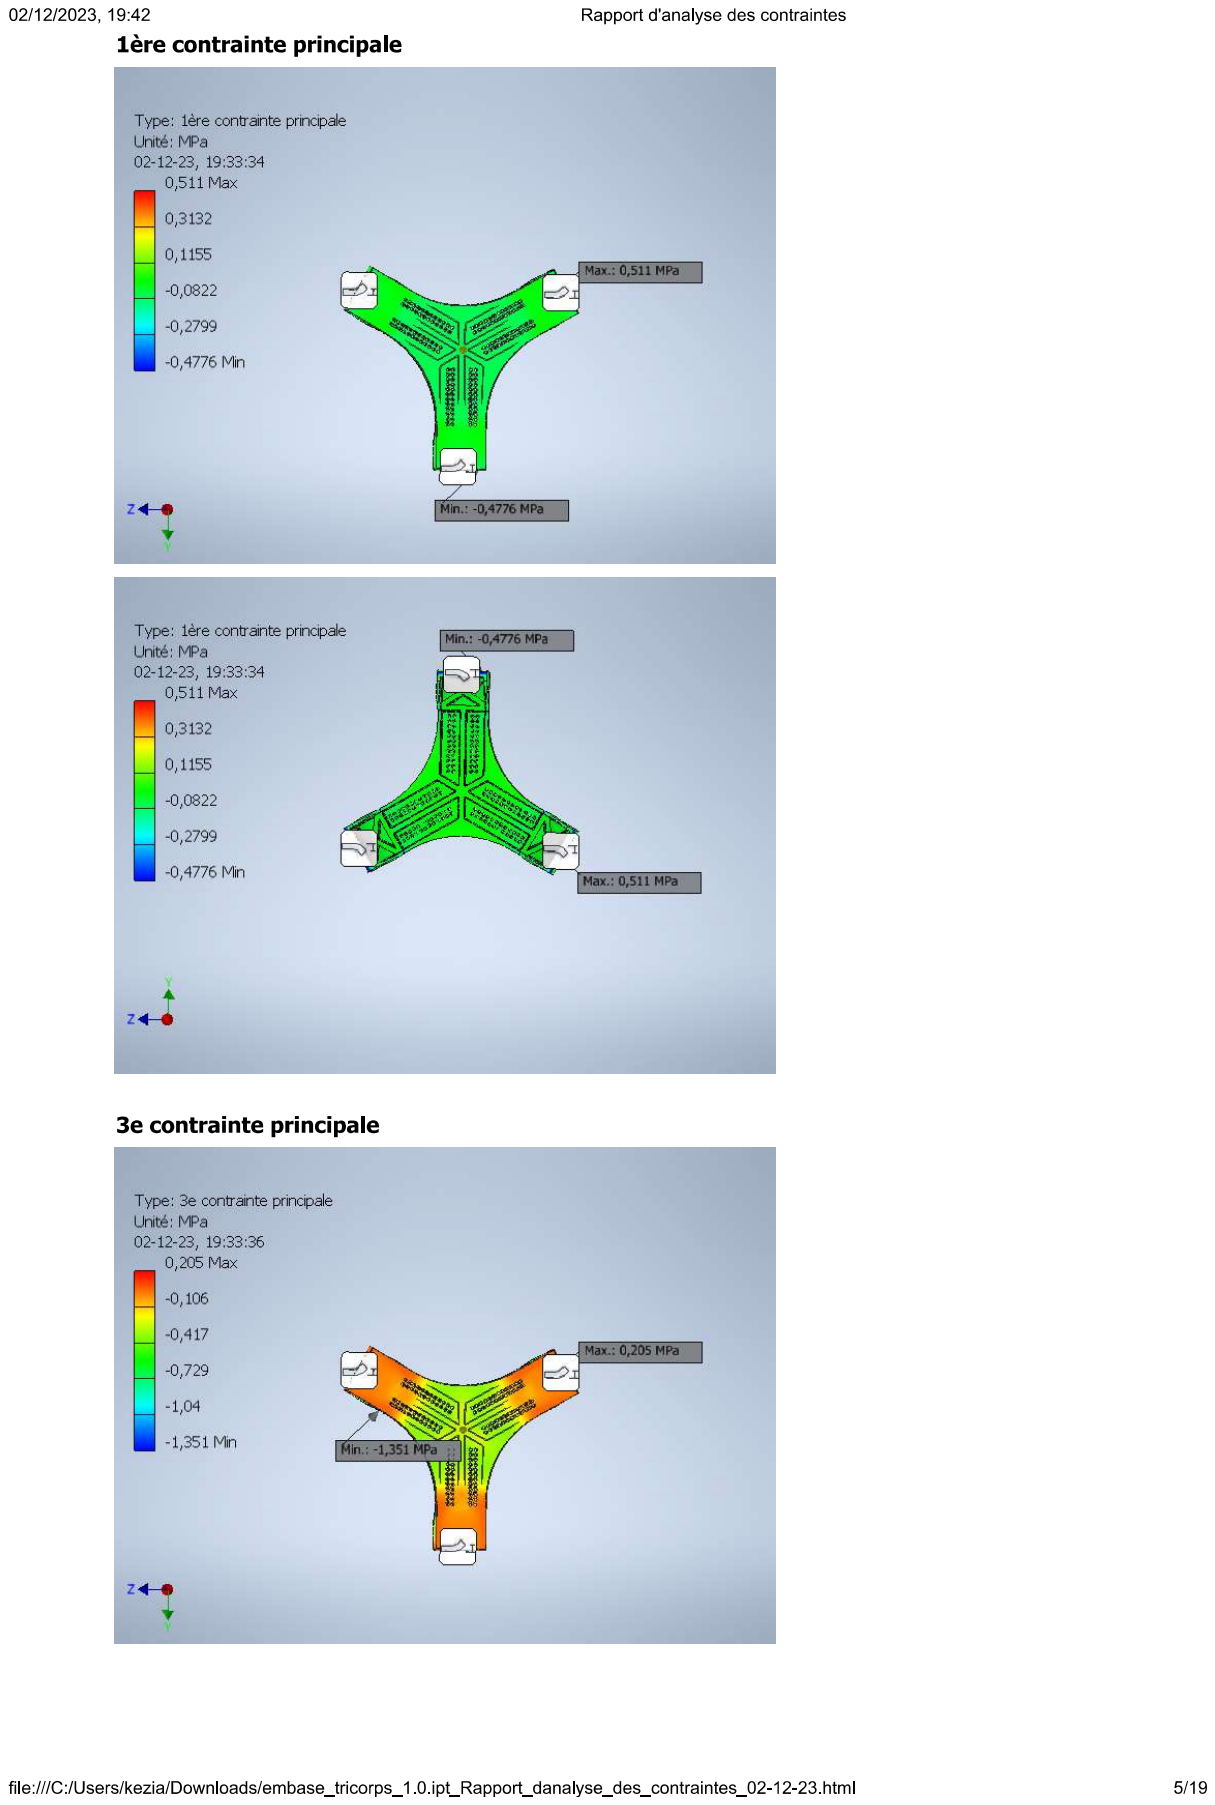
[picture p41: page 5]

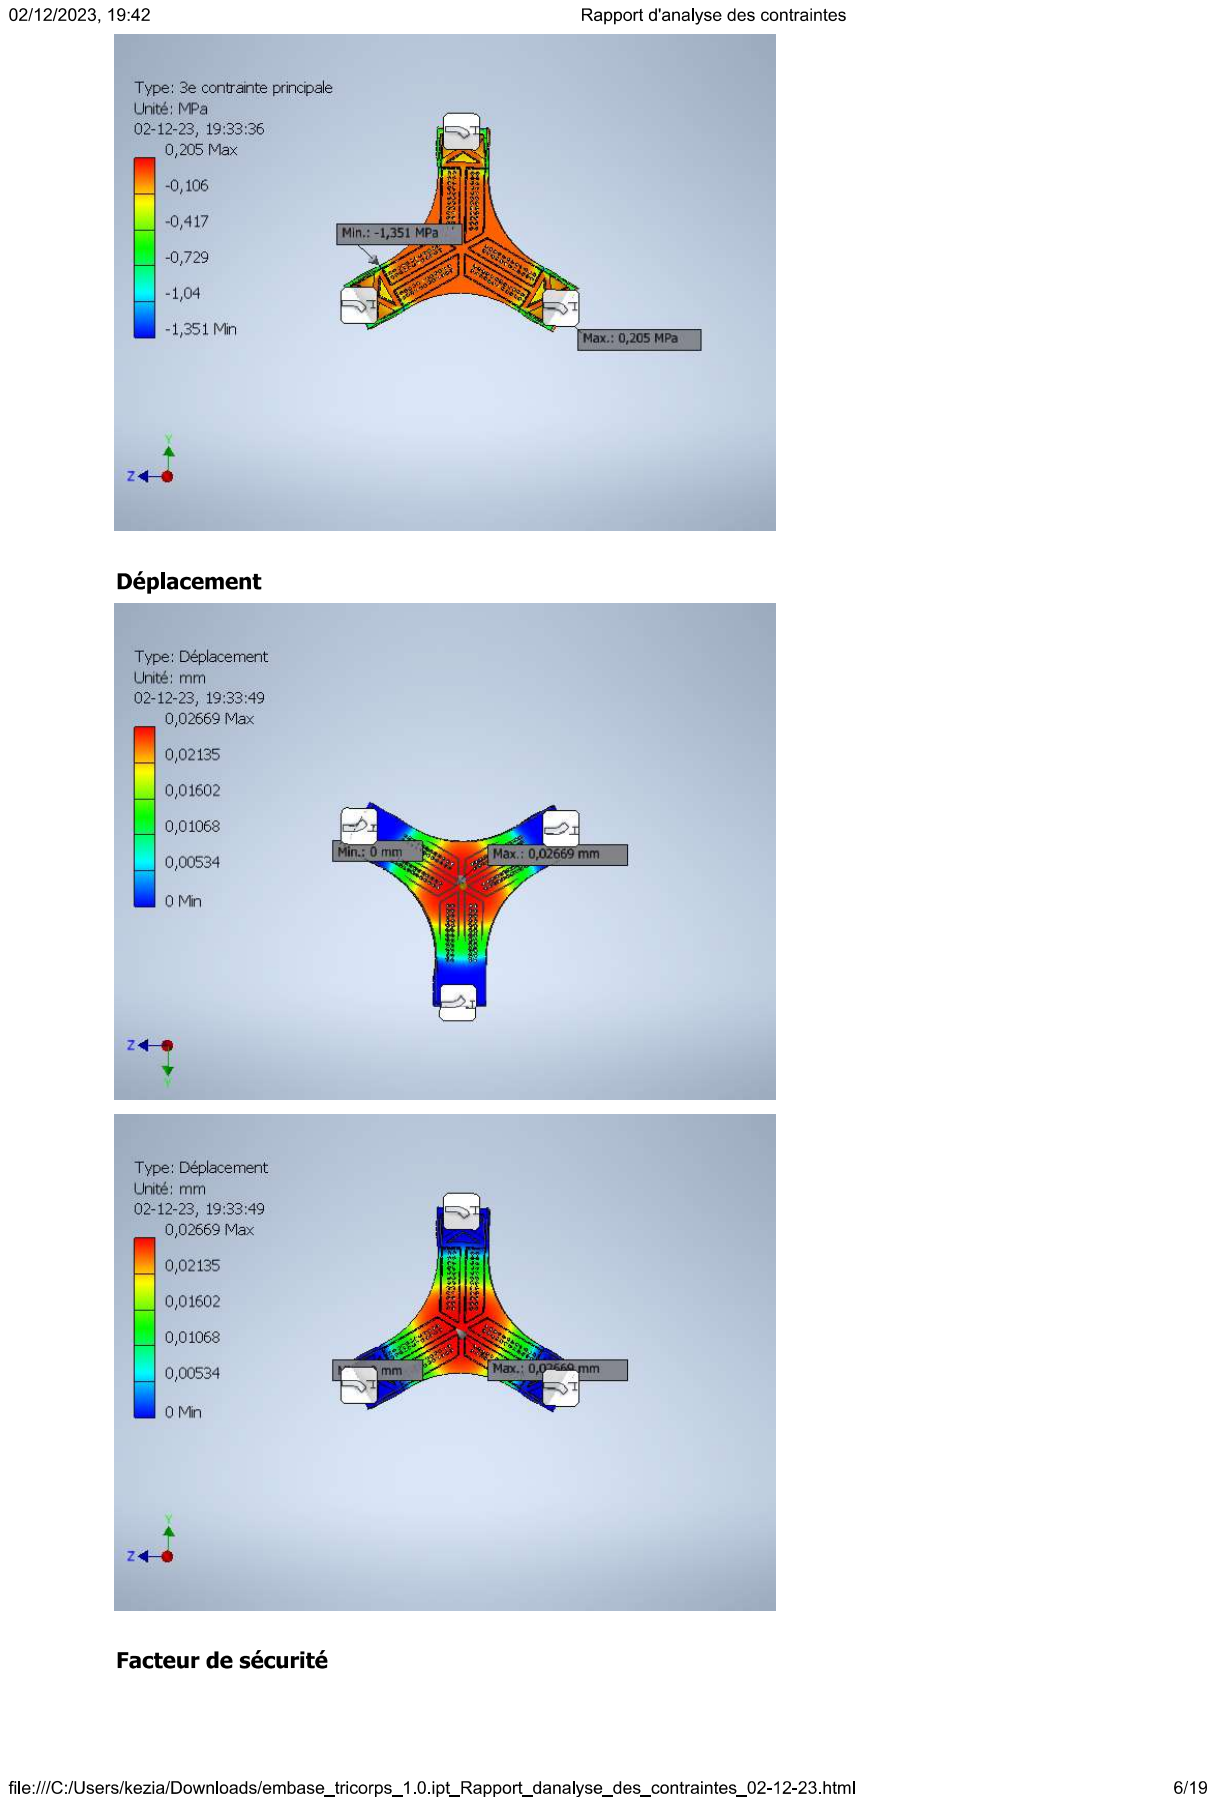
[picture p42: page 6]

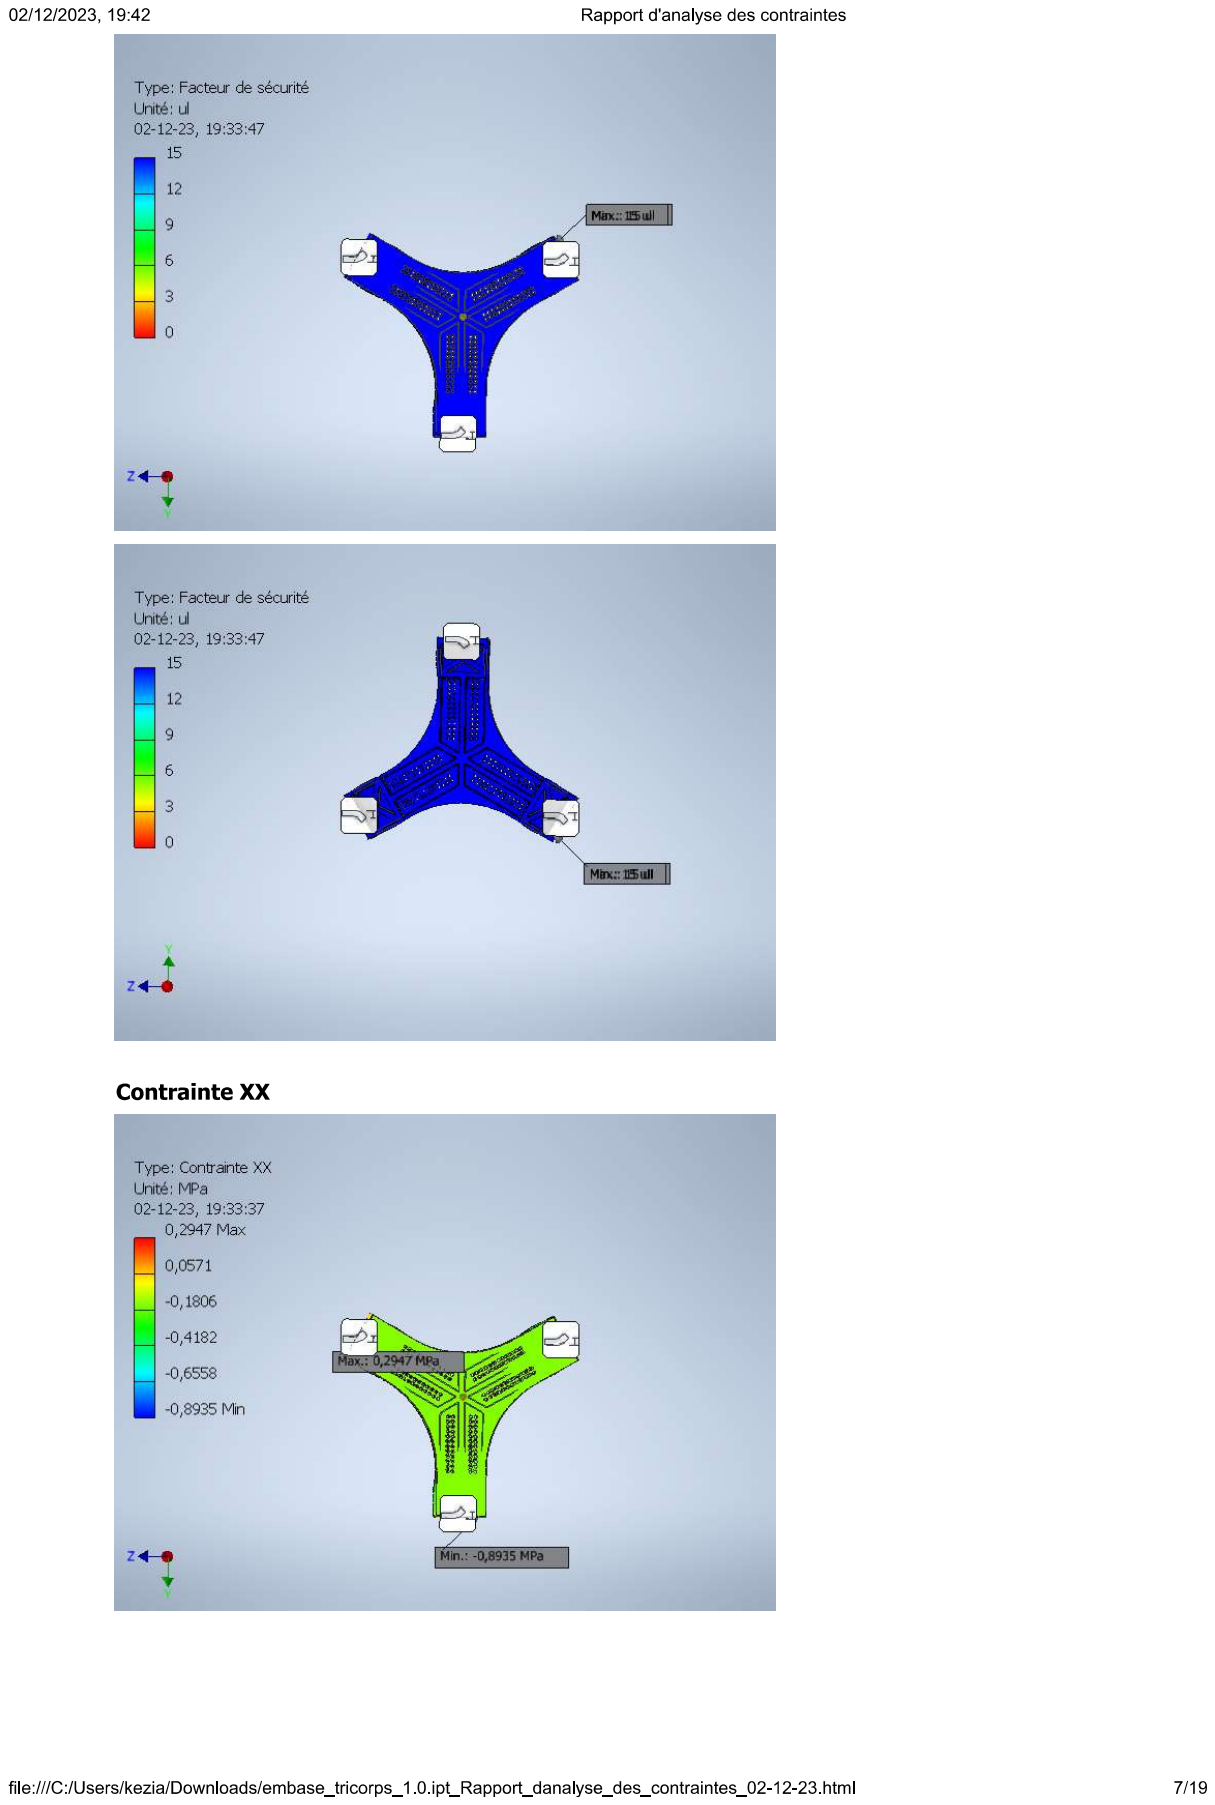
[picture p43: page 7]

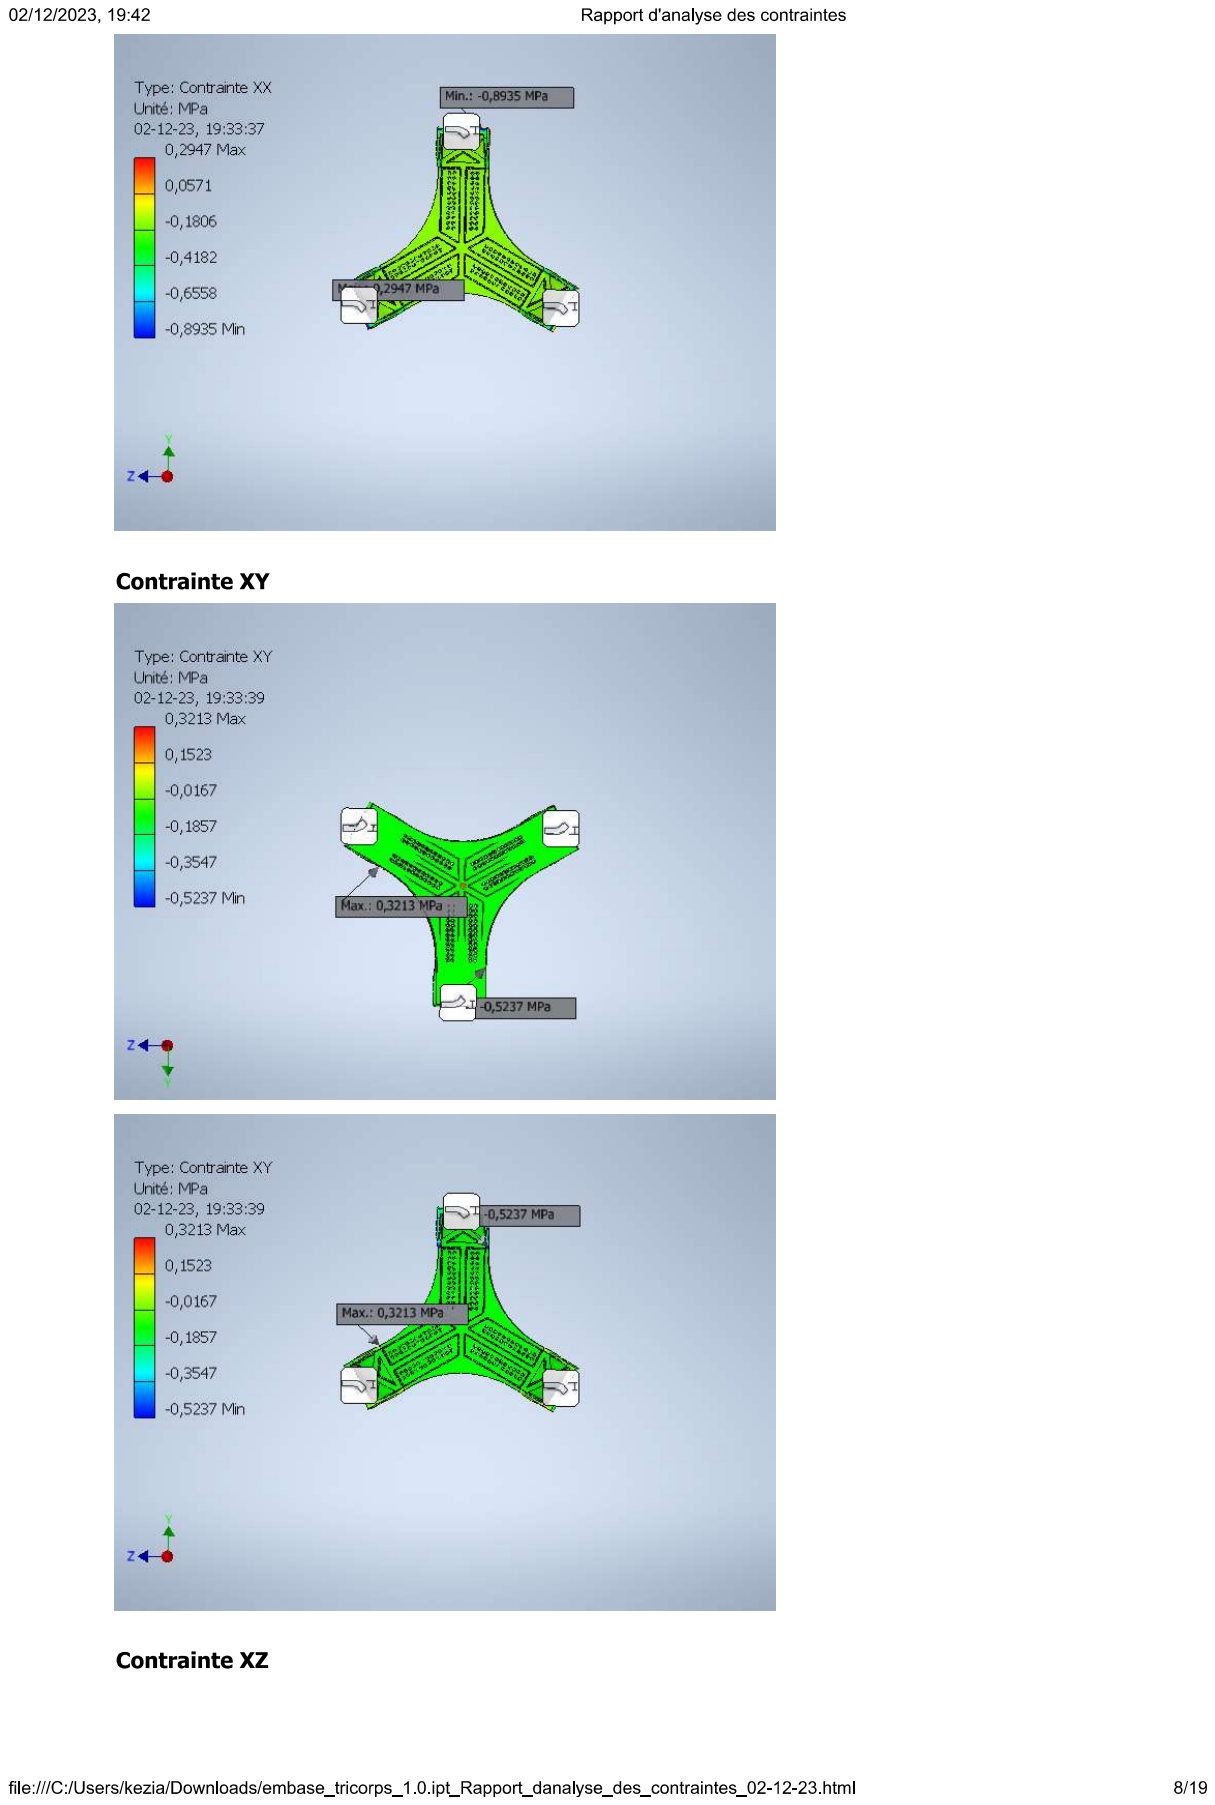
[picture p44: page 8]

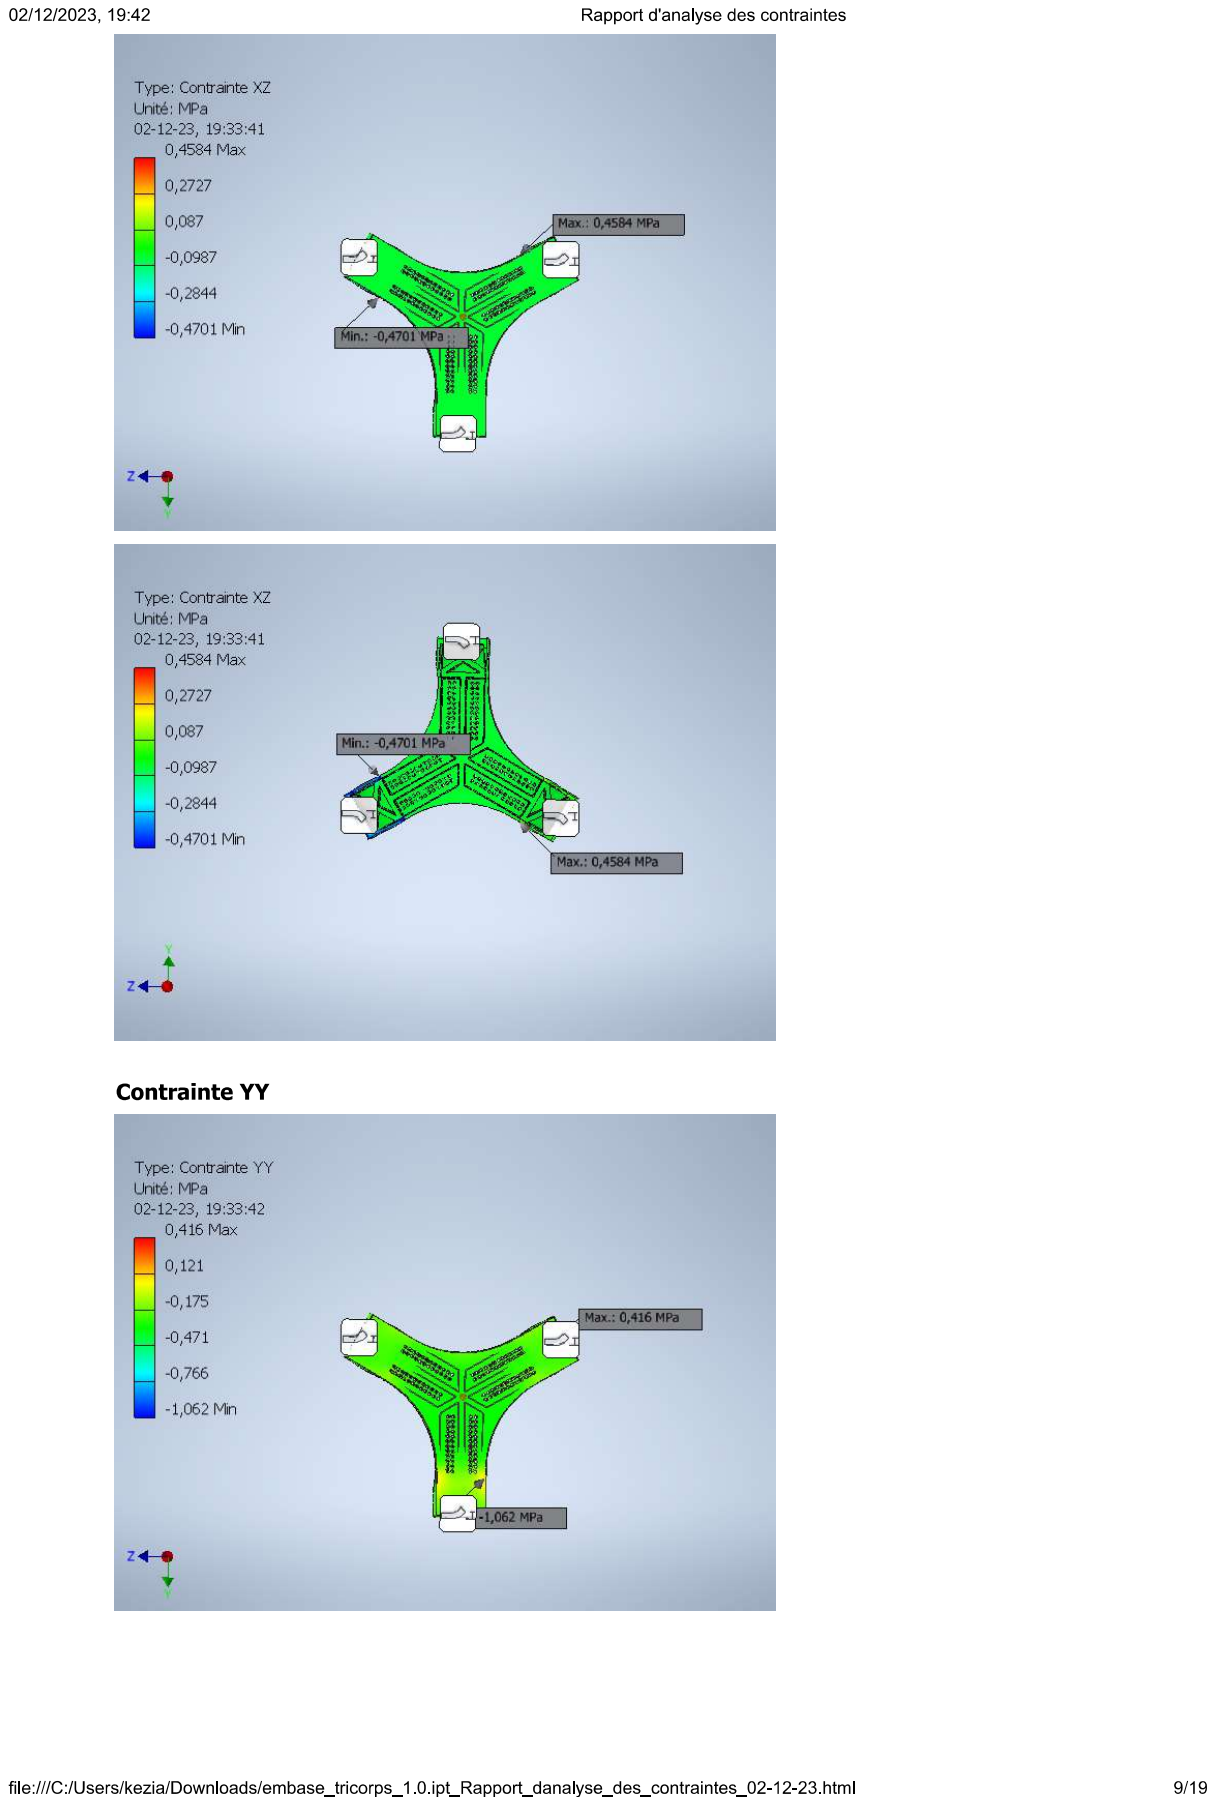
[picture p45: page 9]

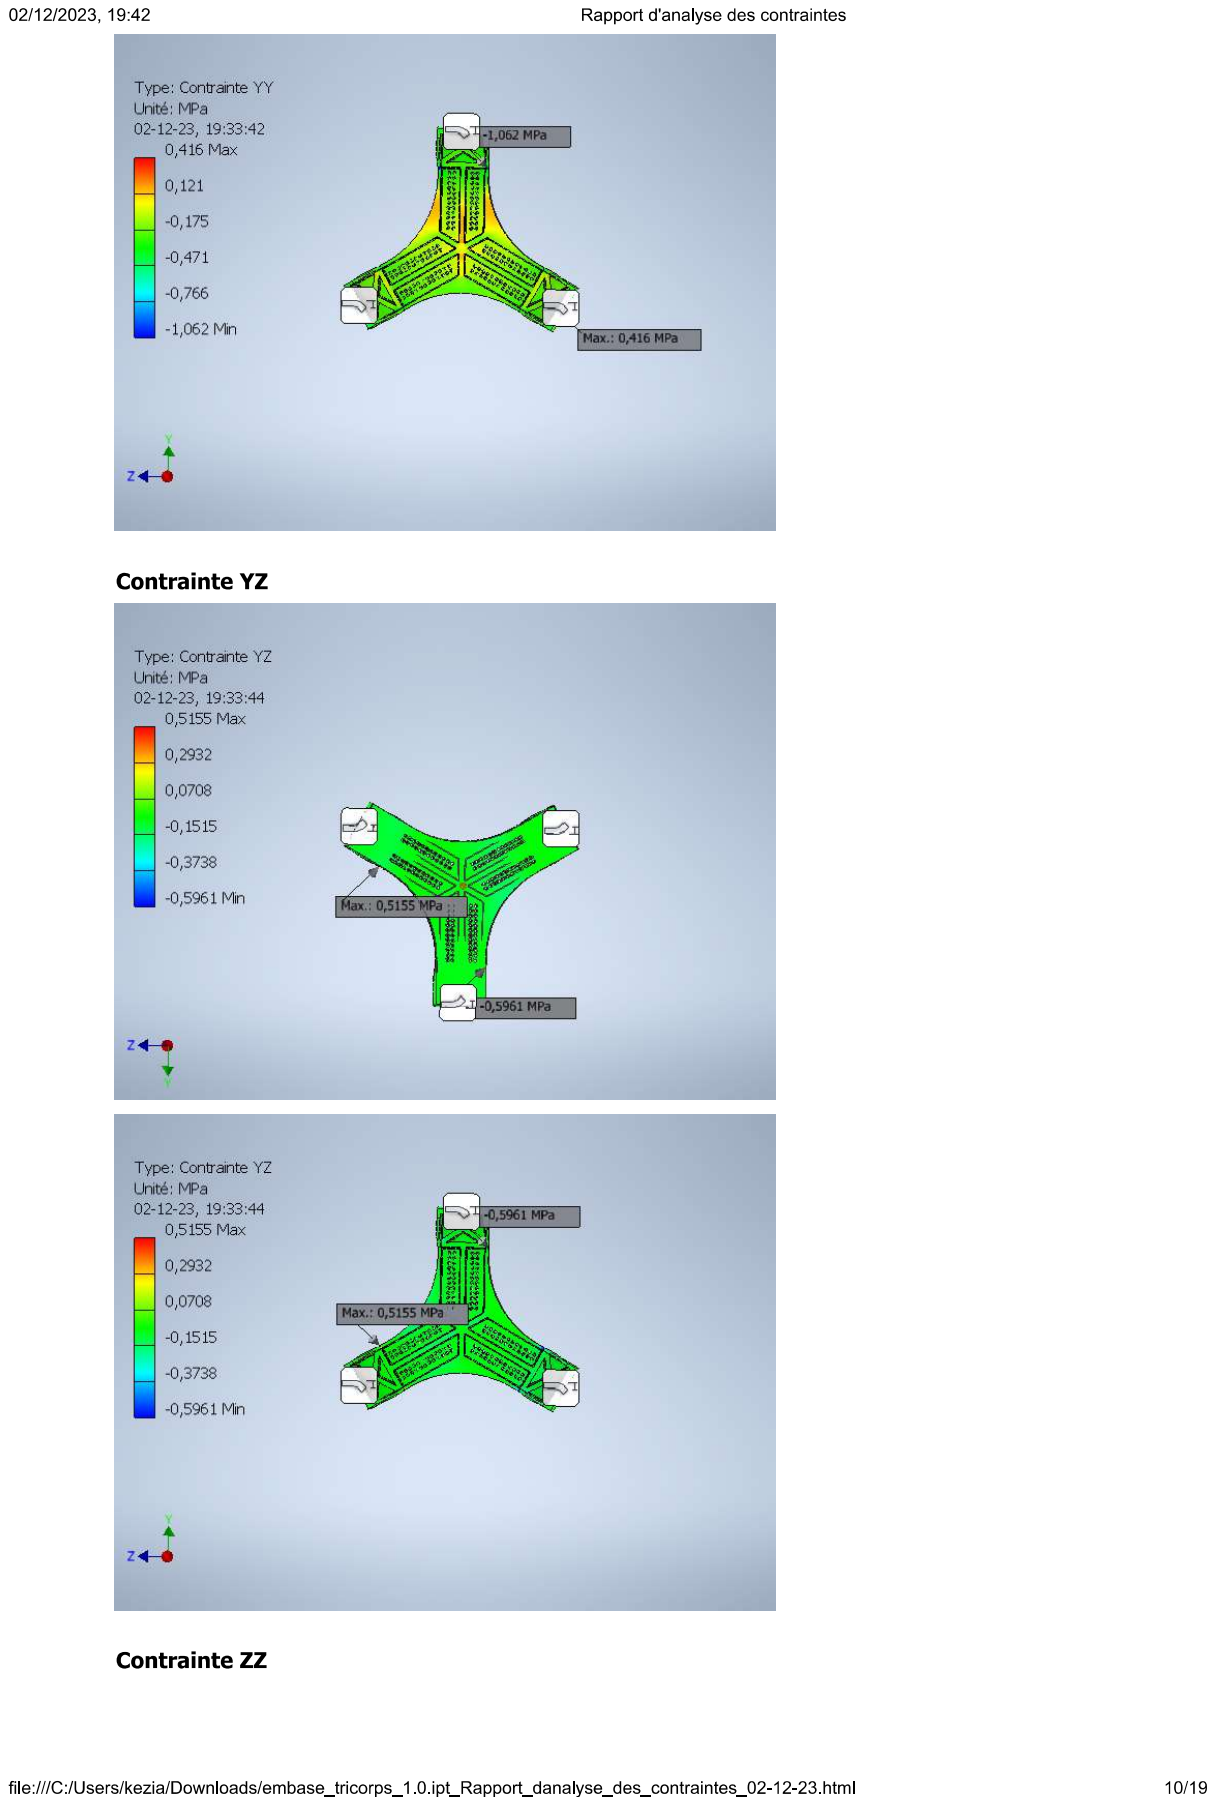
[picture p46: page 10]

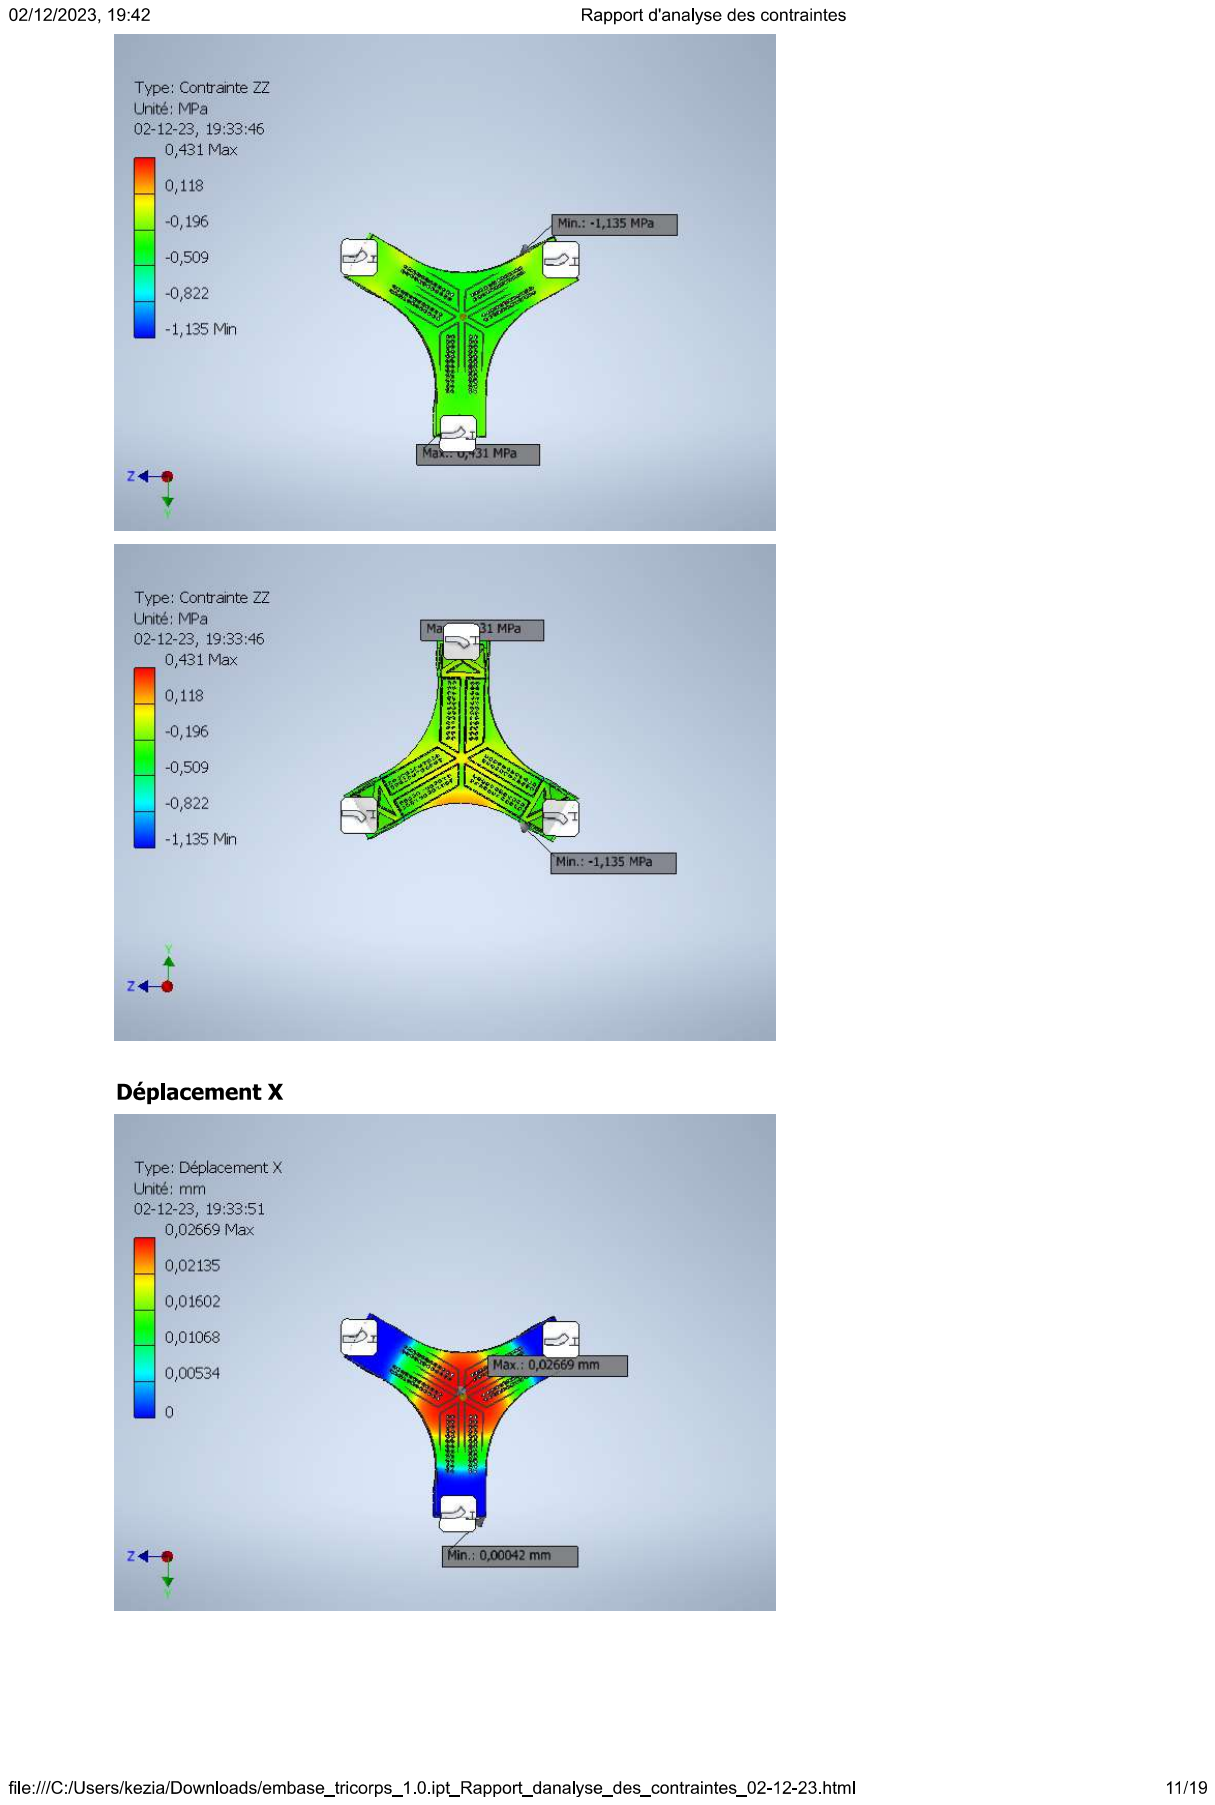
[picture p47: page 11]

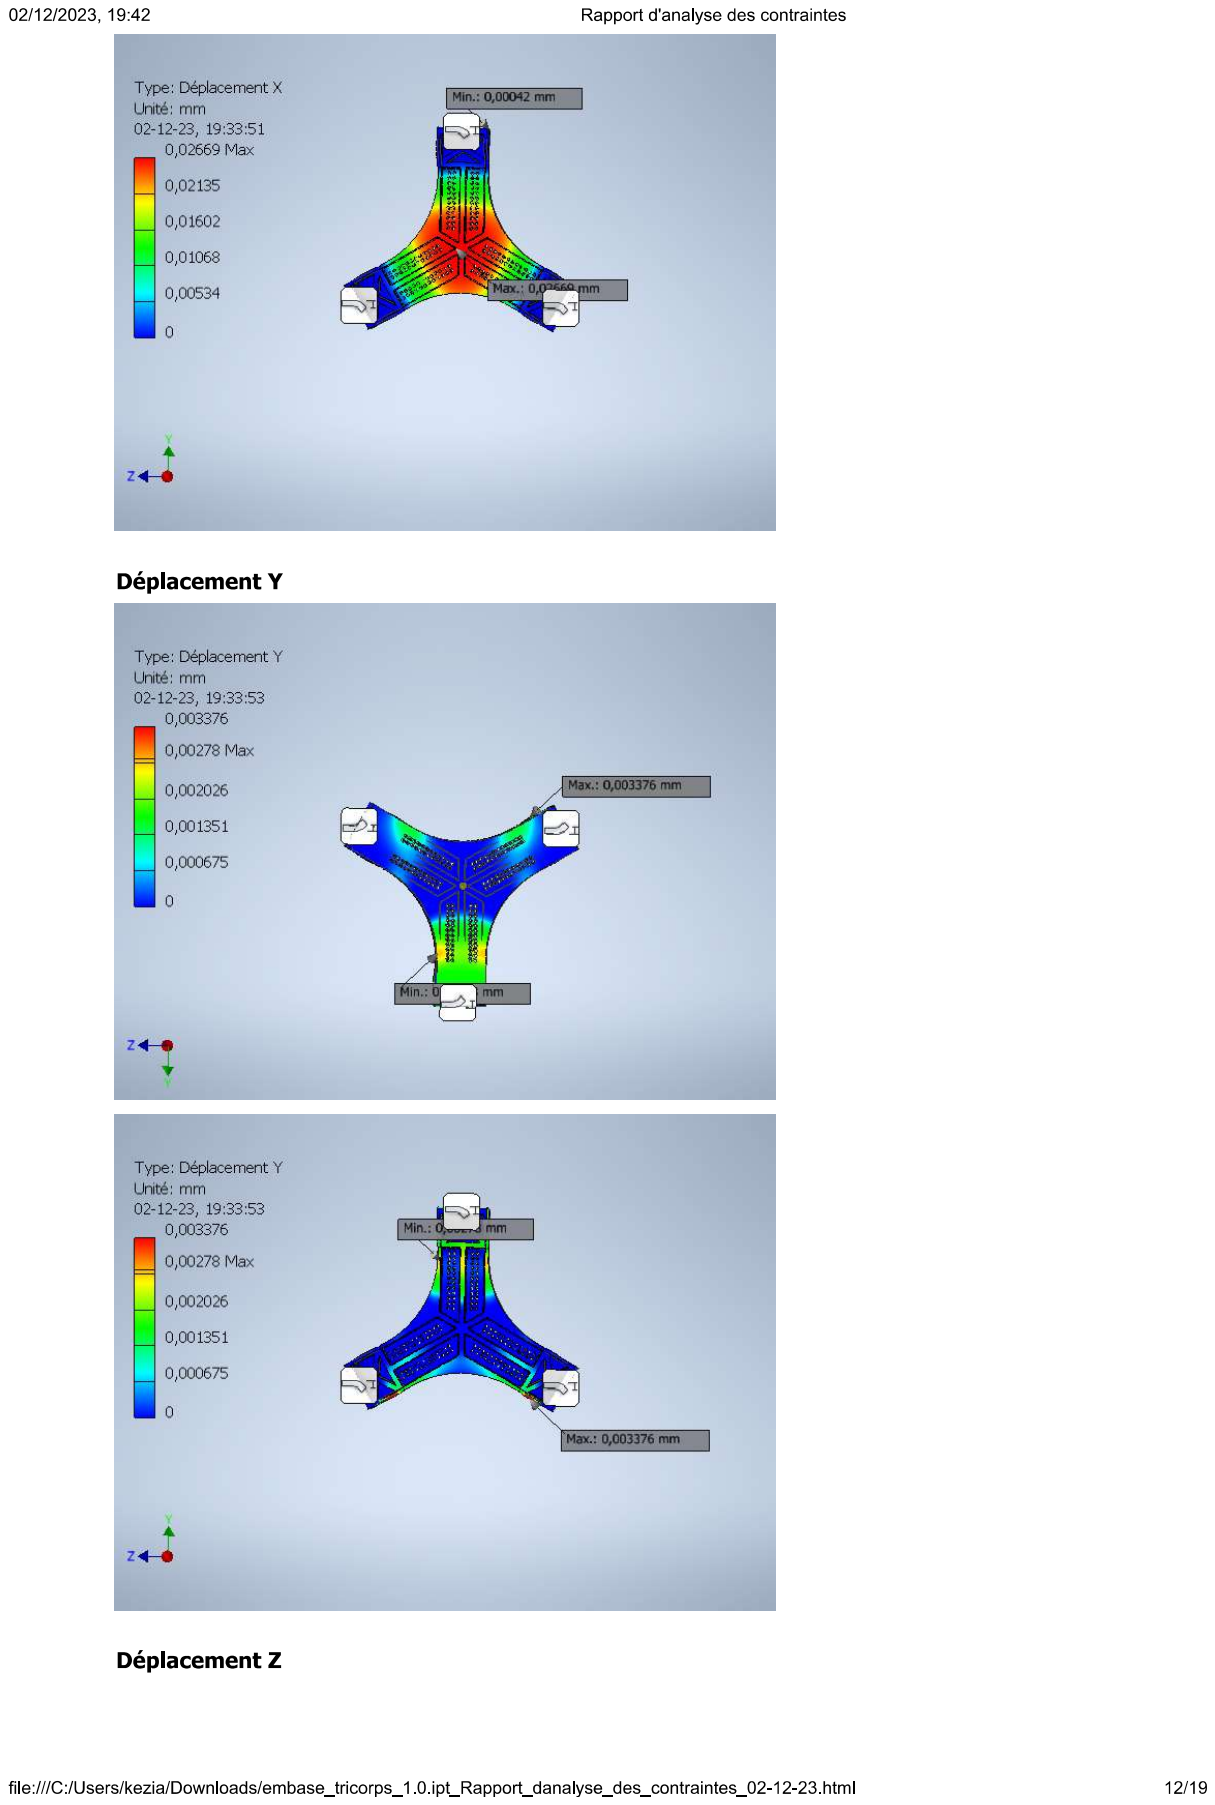
[picture p48: page 12]

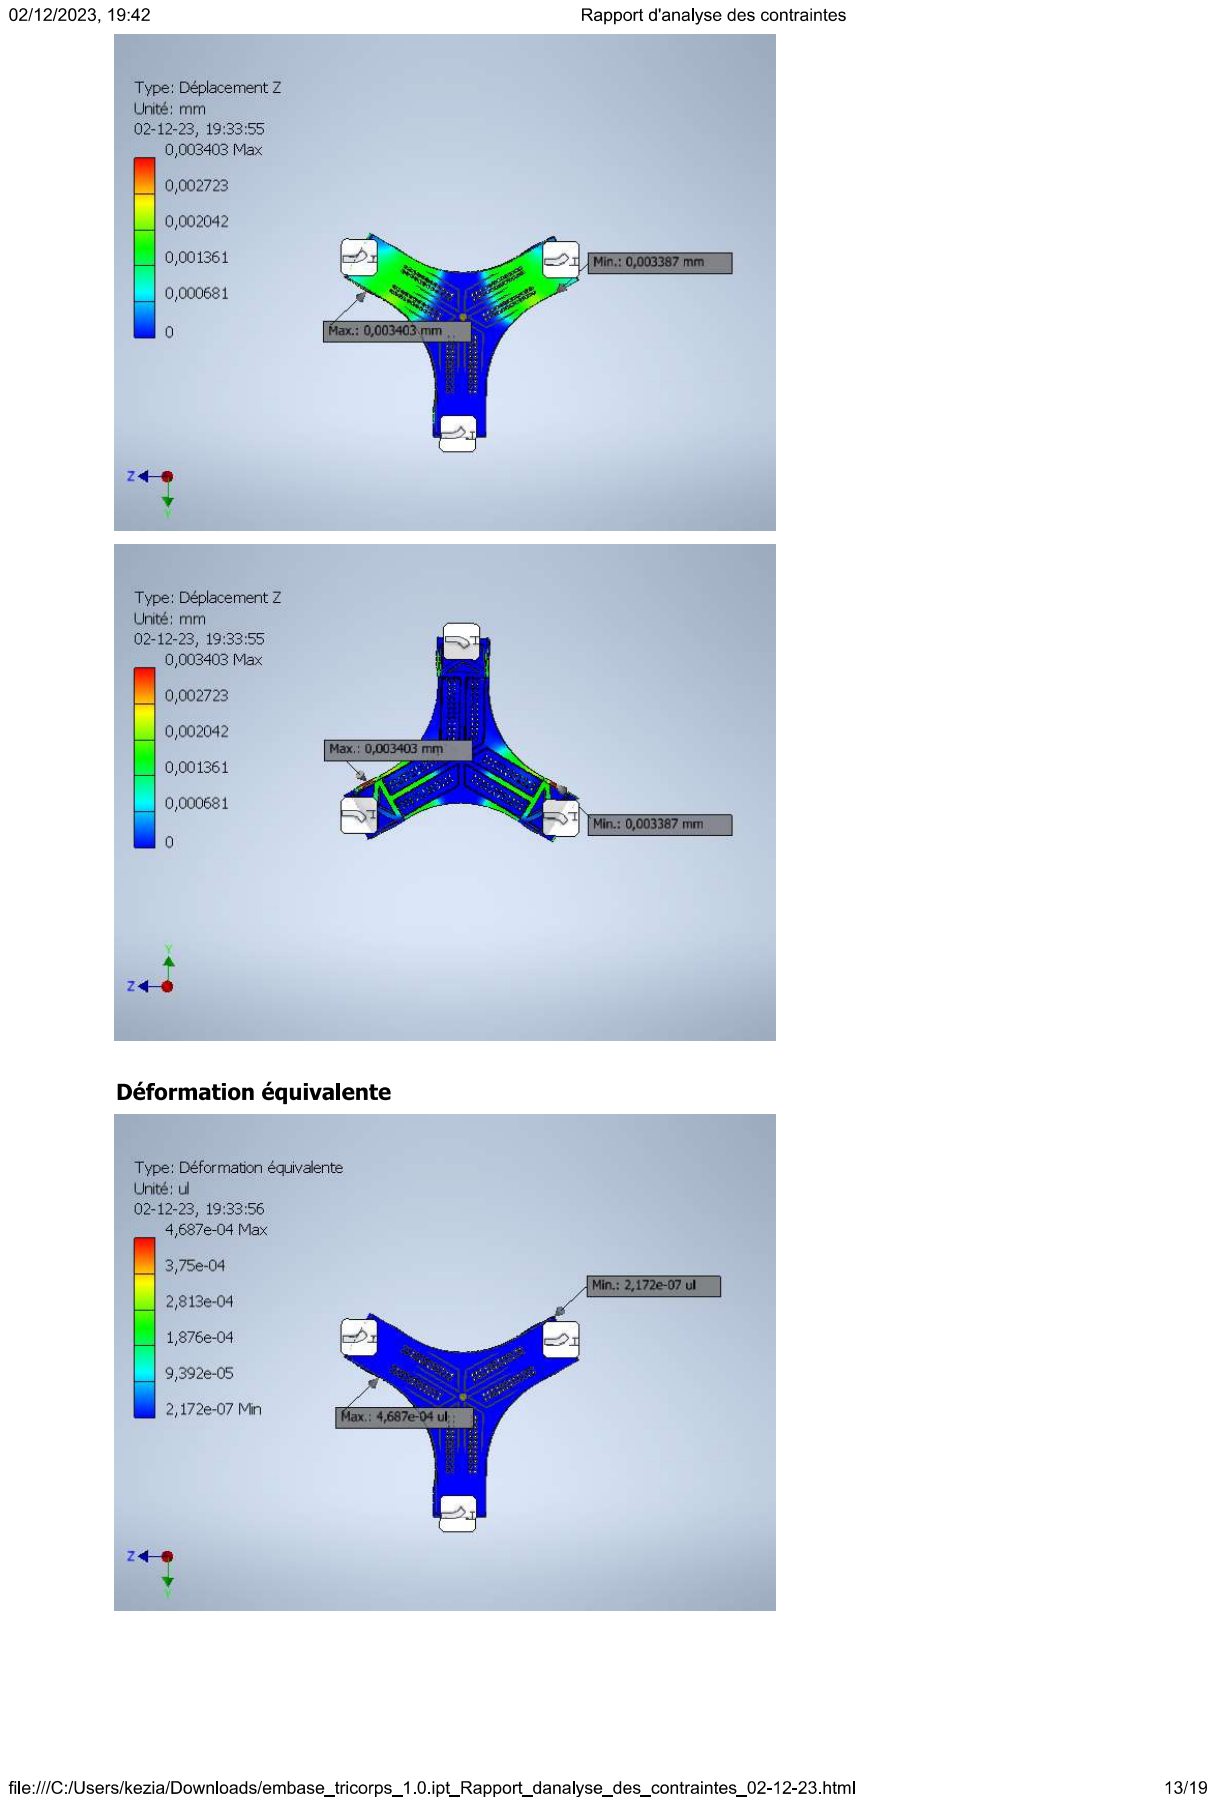
[picture p49: page 13]

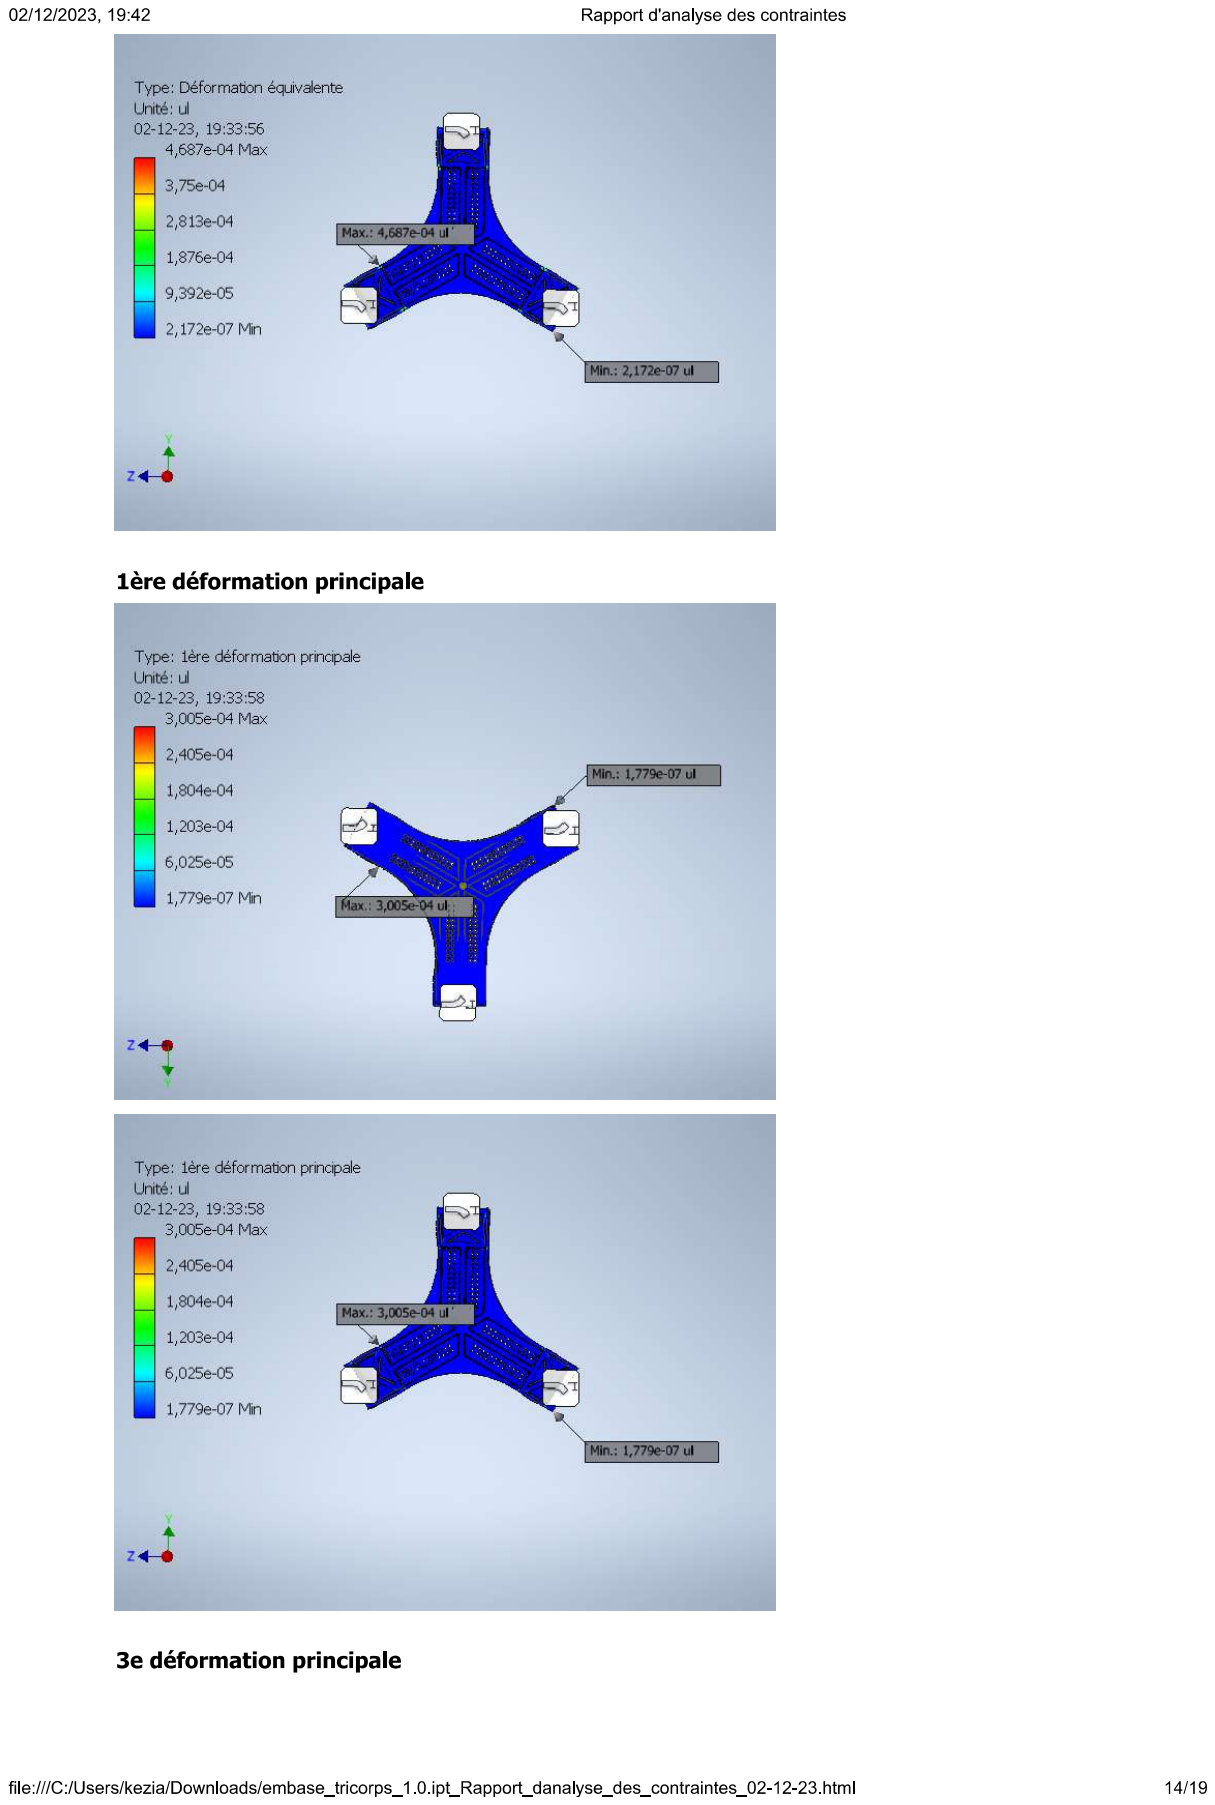
[picture p50: page 14]

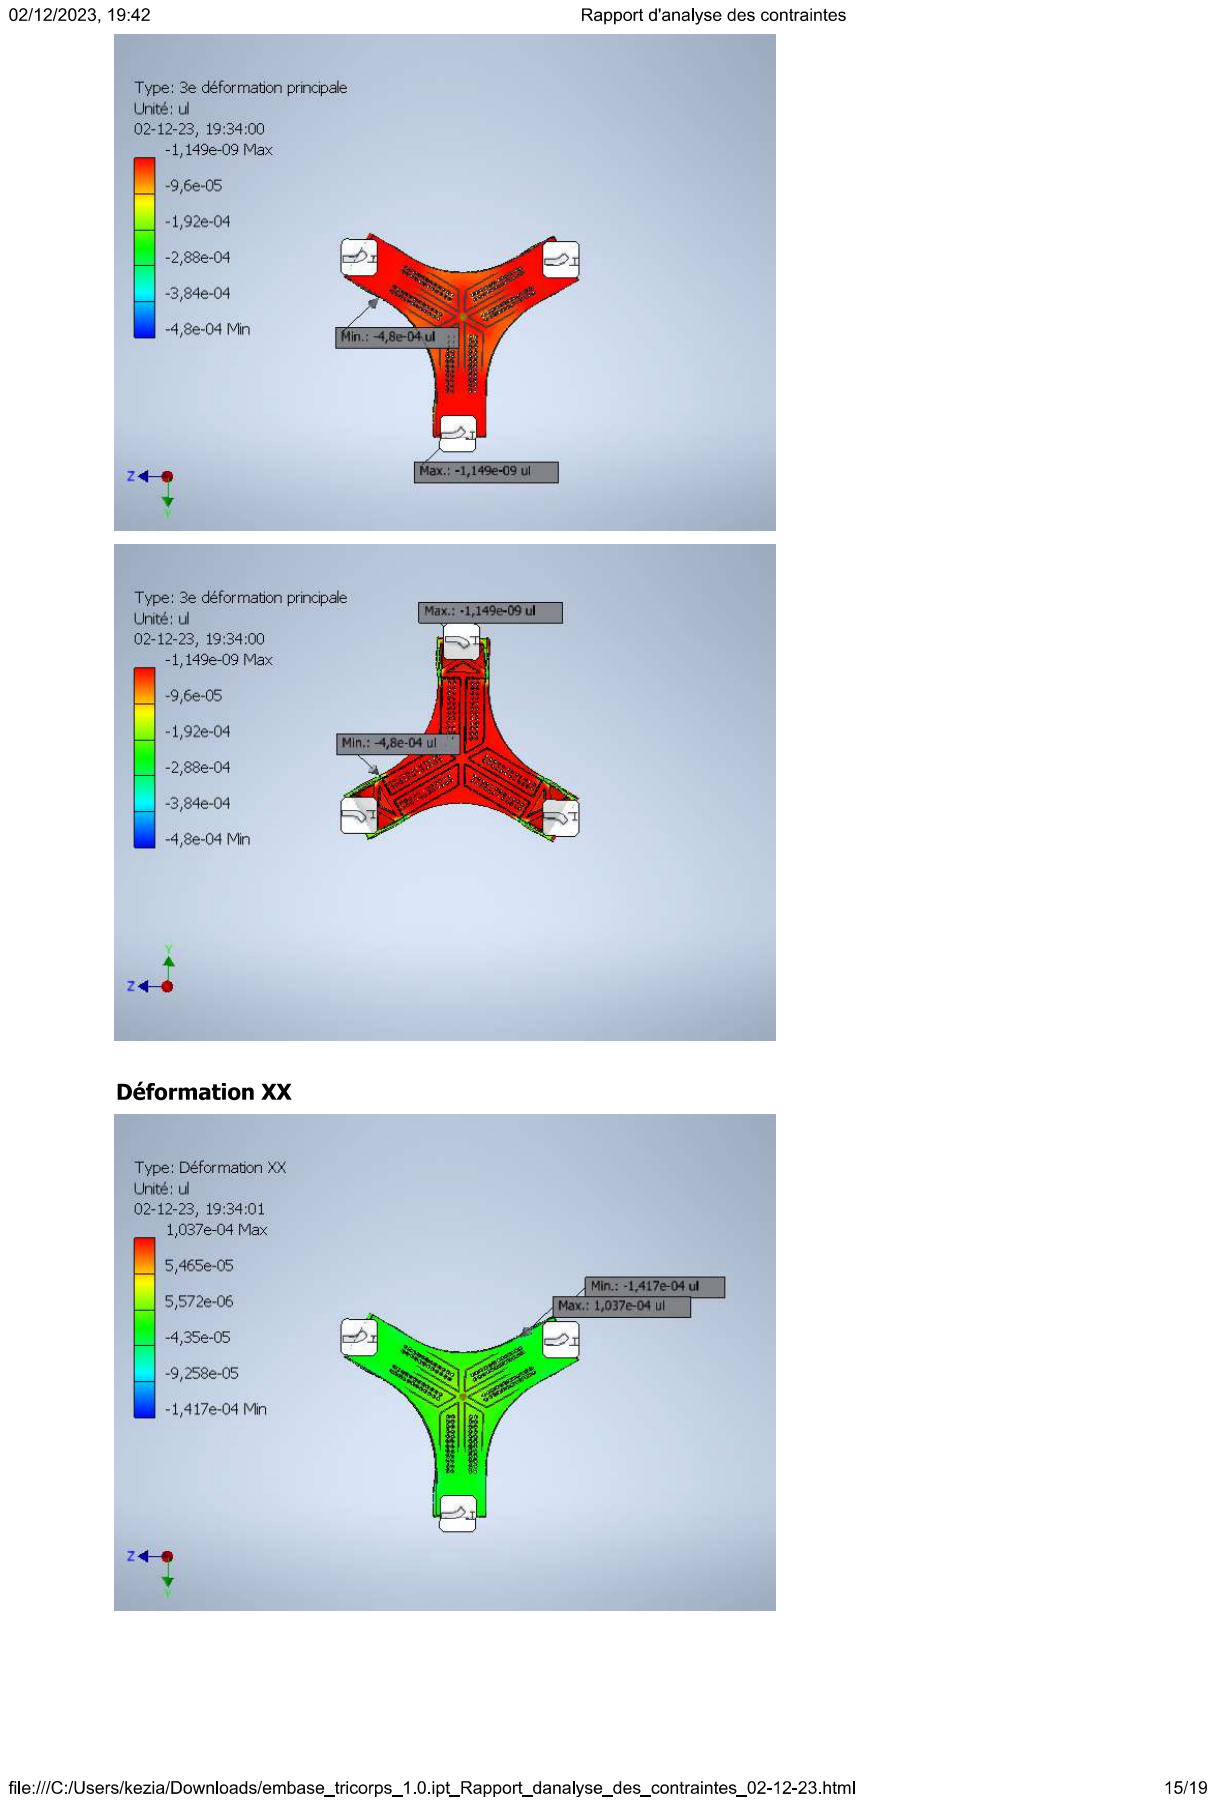
[picture p51: page 15]

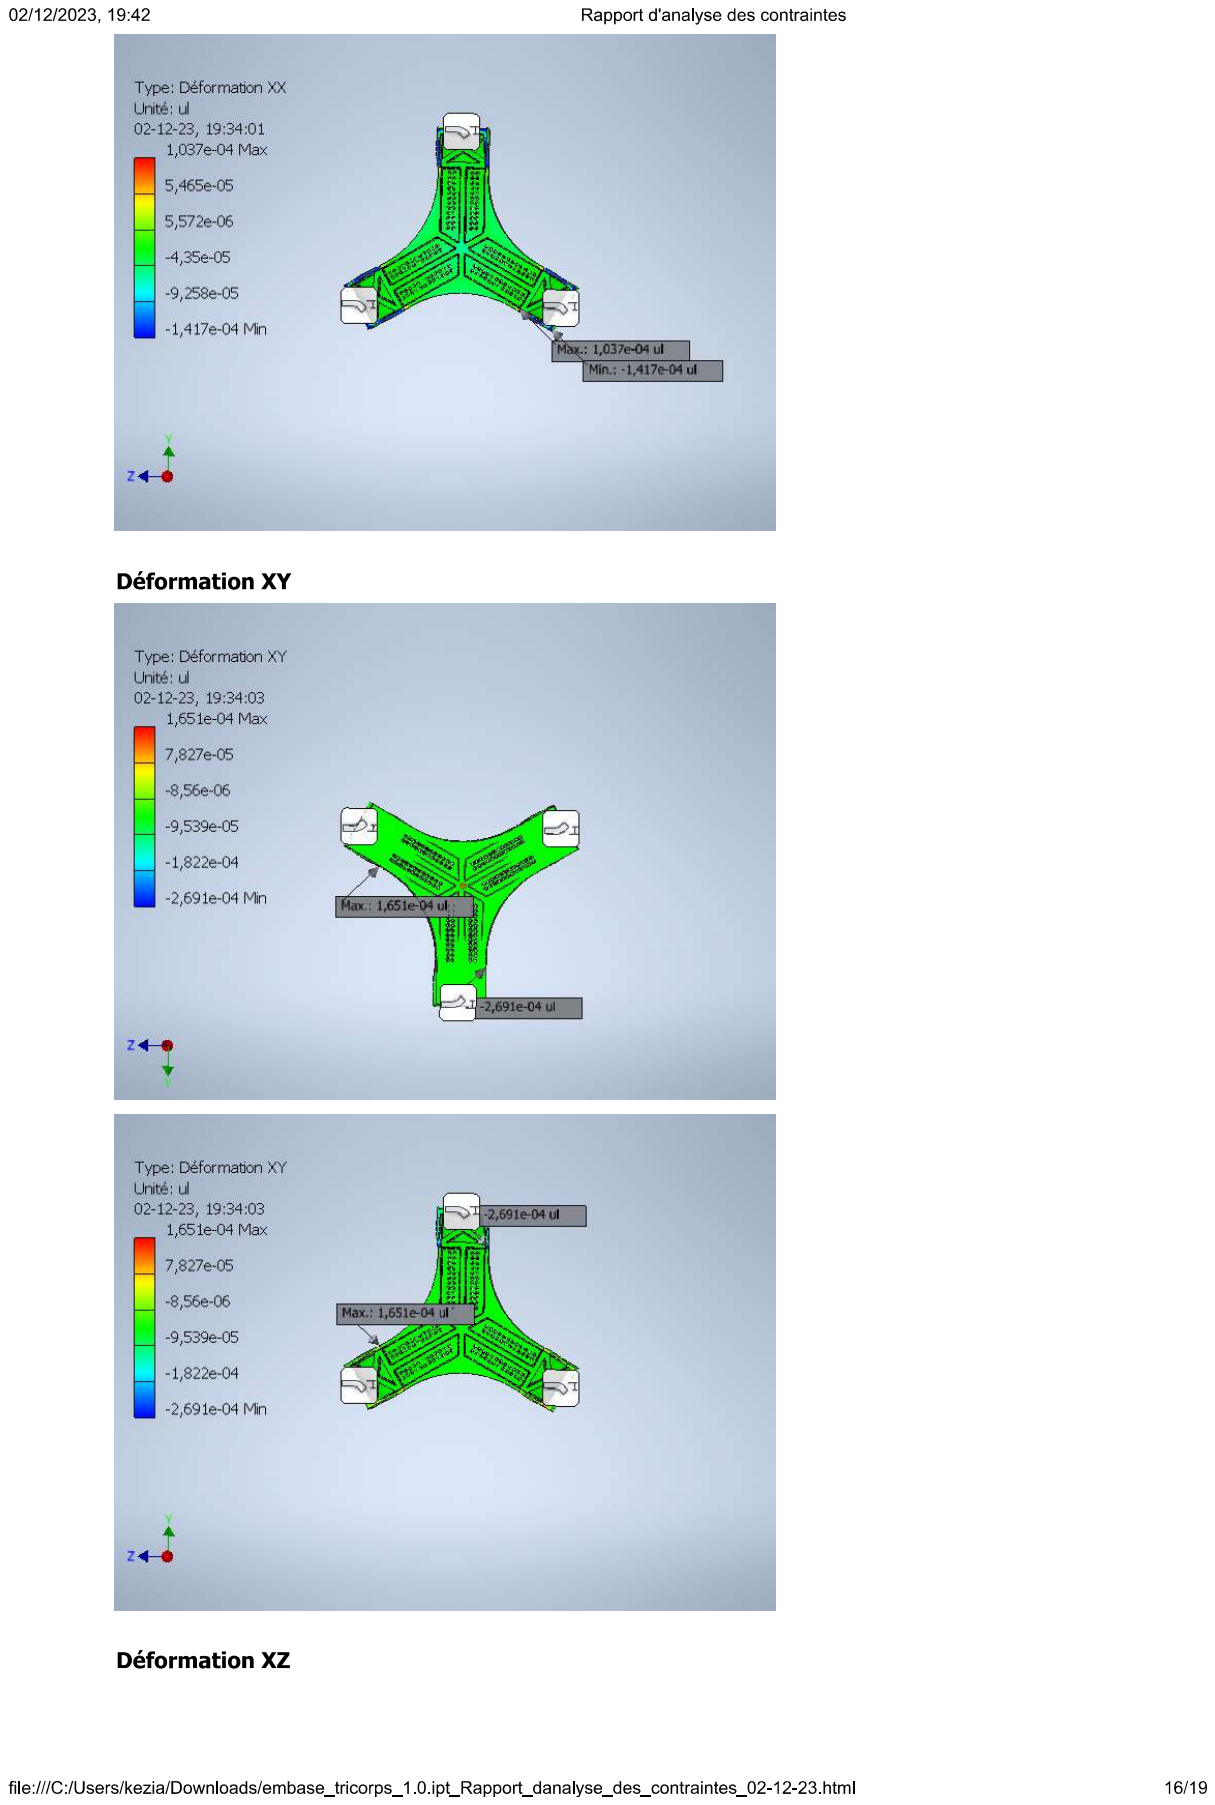
[picture p52: page 16]

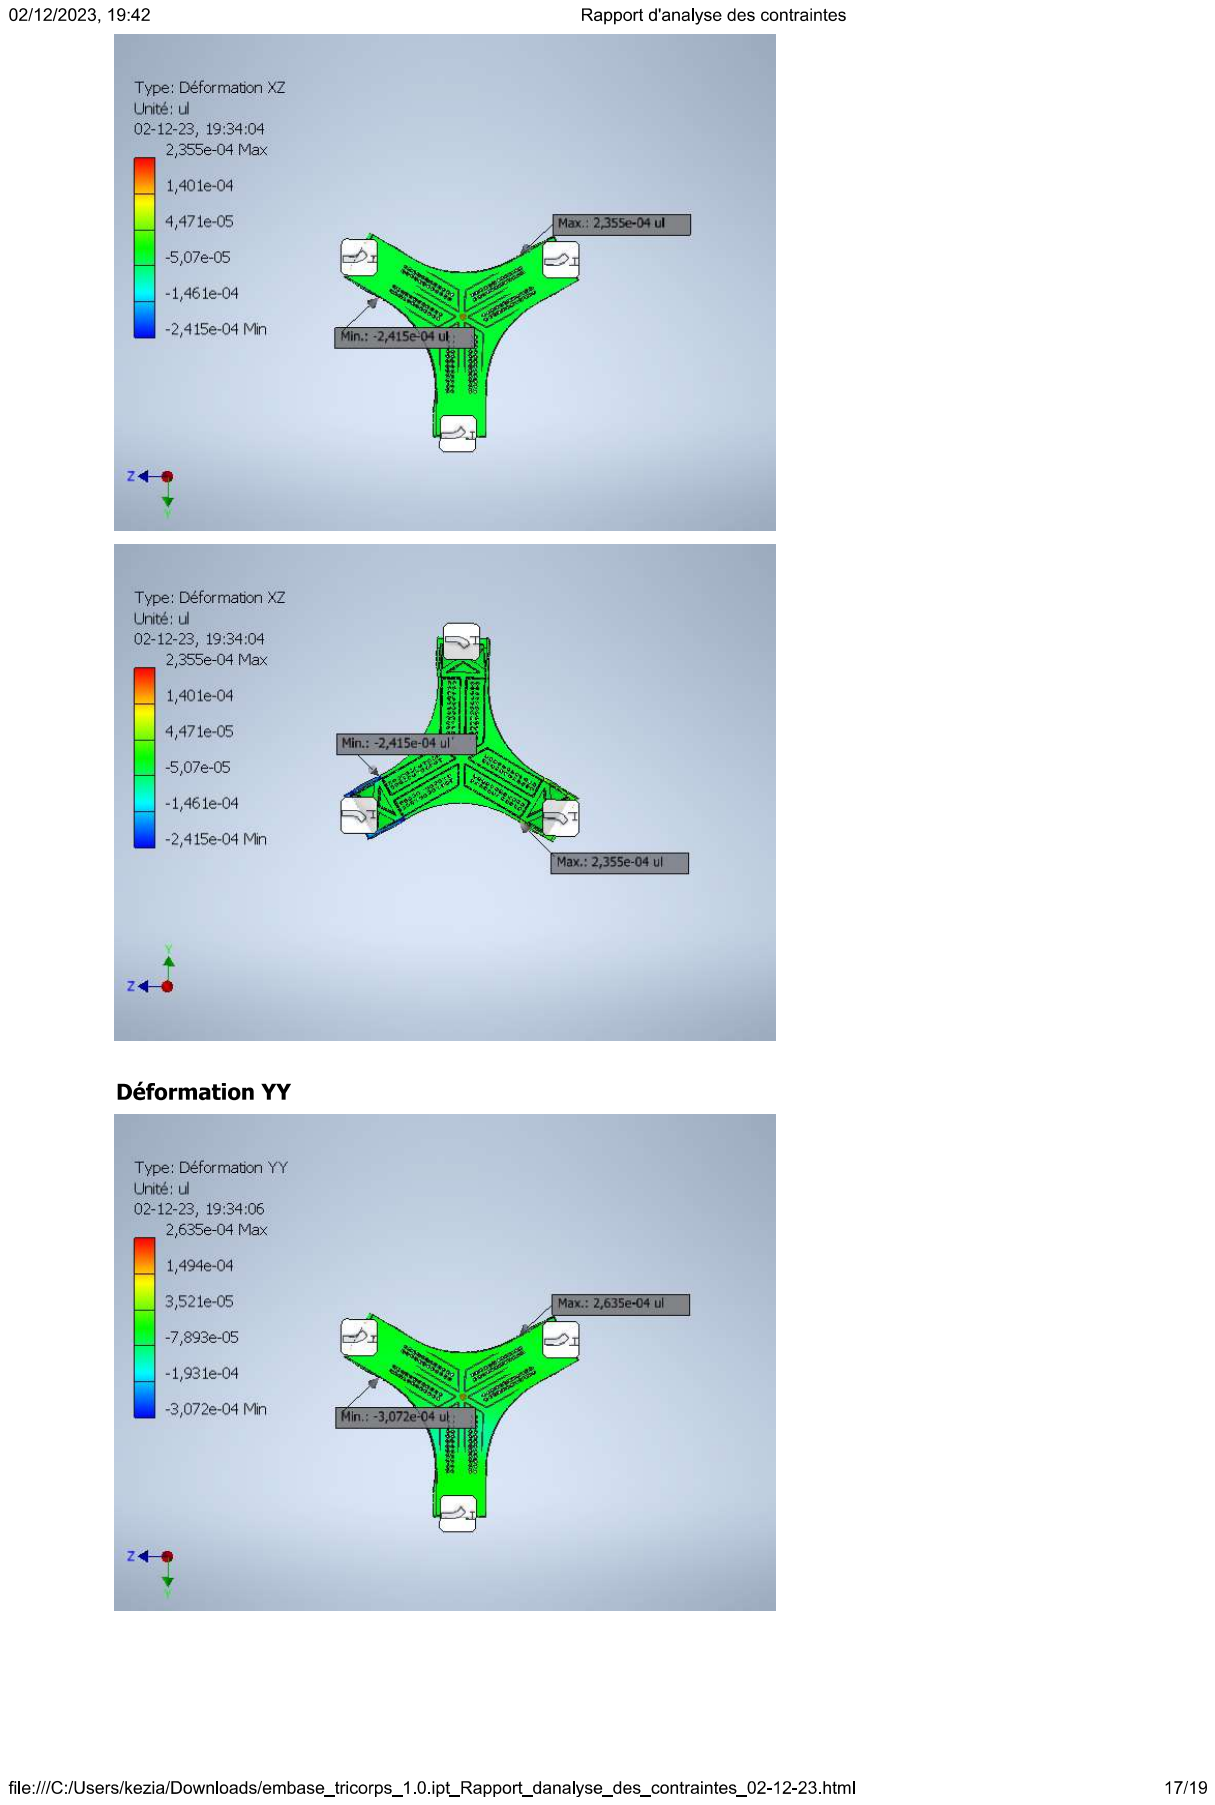
[picture p53: page 17]

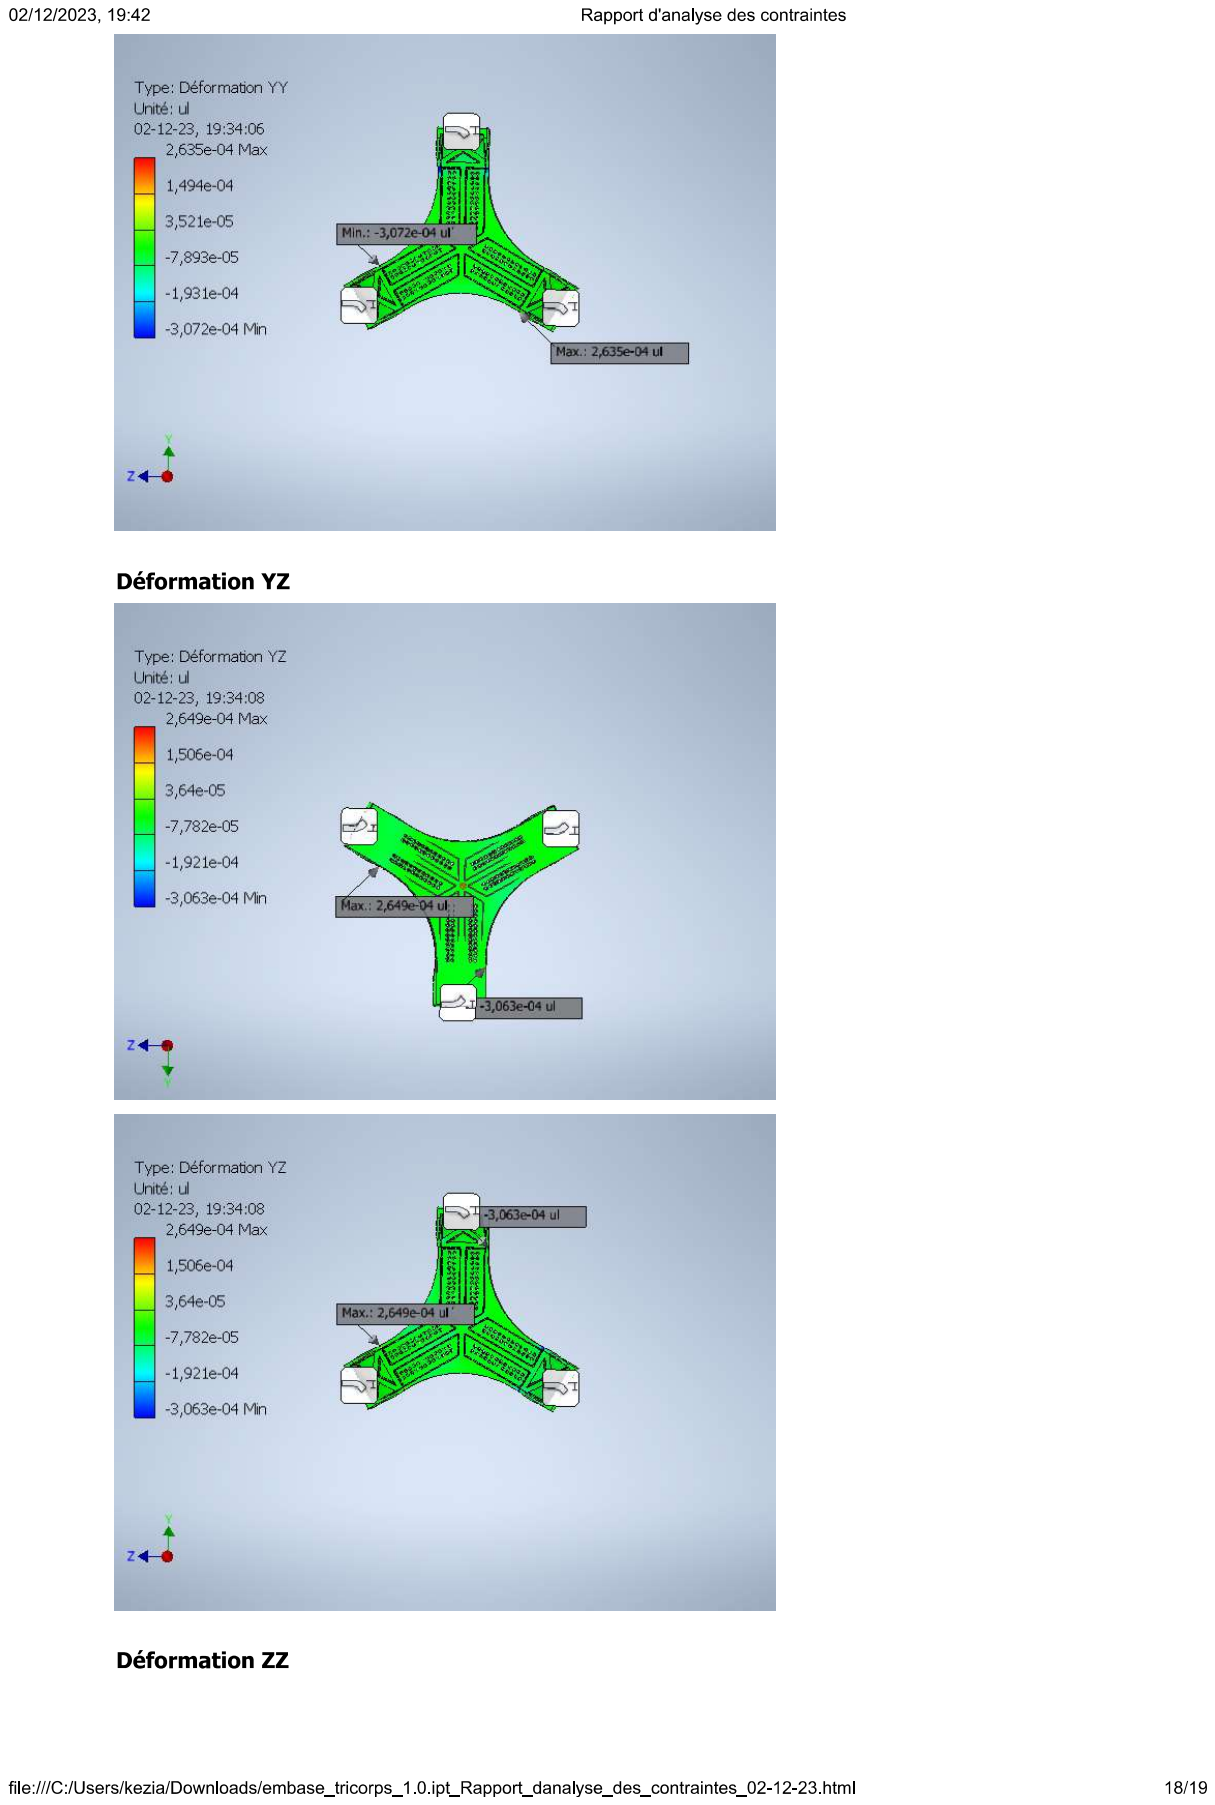
[picture p54: page 18]

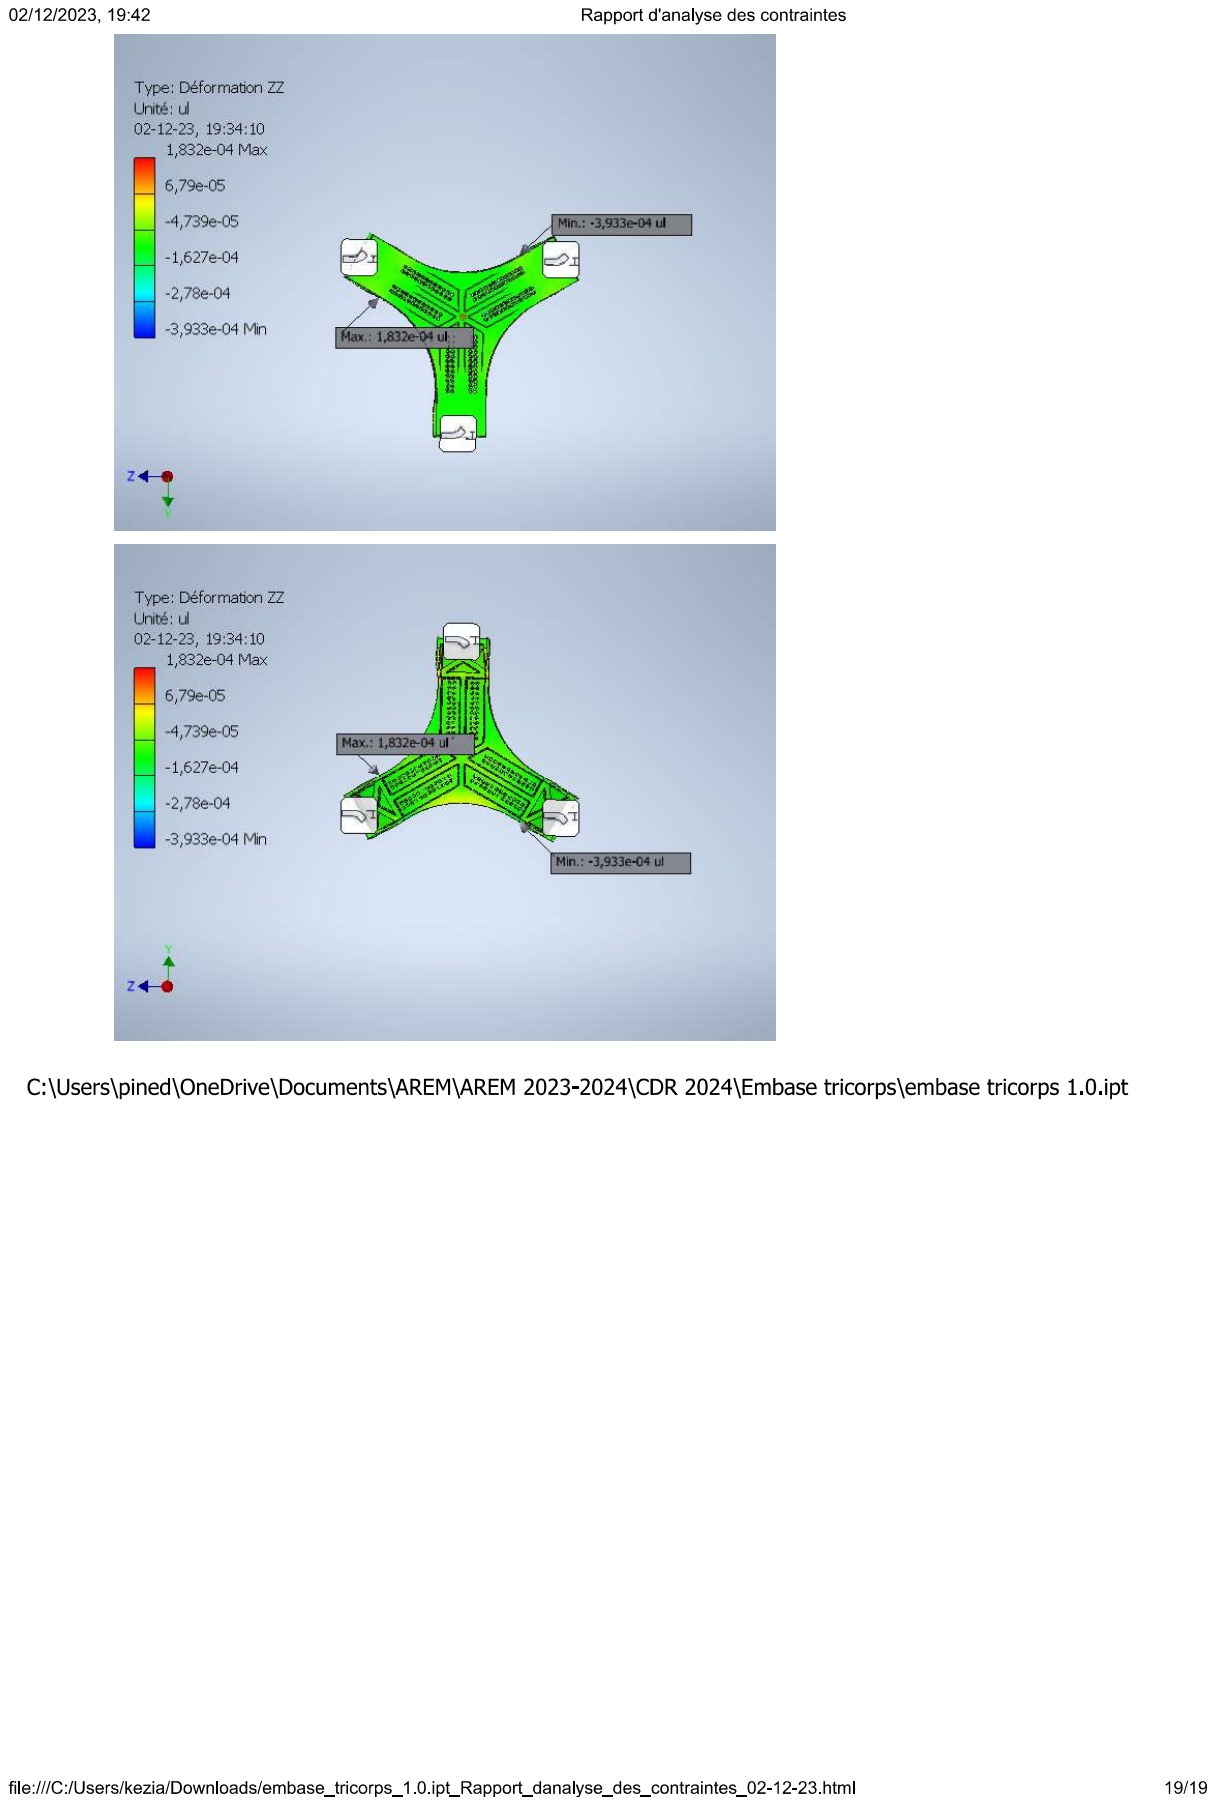
[picture p55: page 19]
