AREM-Projets/CdR-2024/PAMIs/PCBs/carte_generale/carte_generale.kicad_pcb

## KiCad design PAMIs/PCBs/carte_generale/carte_generale.kicad_pcb (2024-03-29)

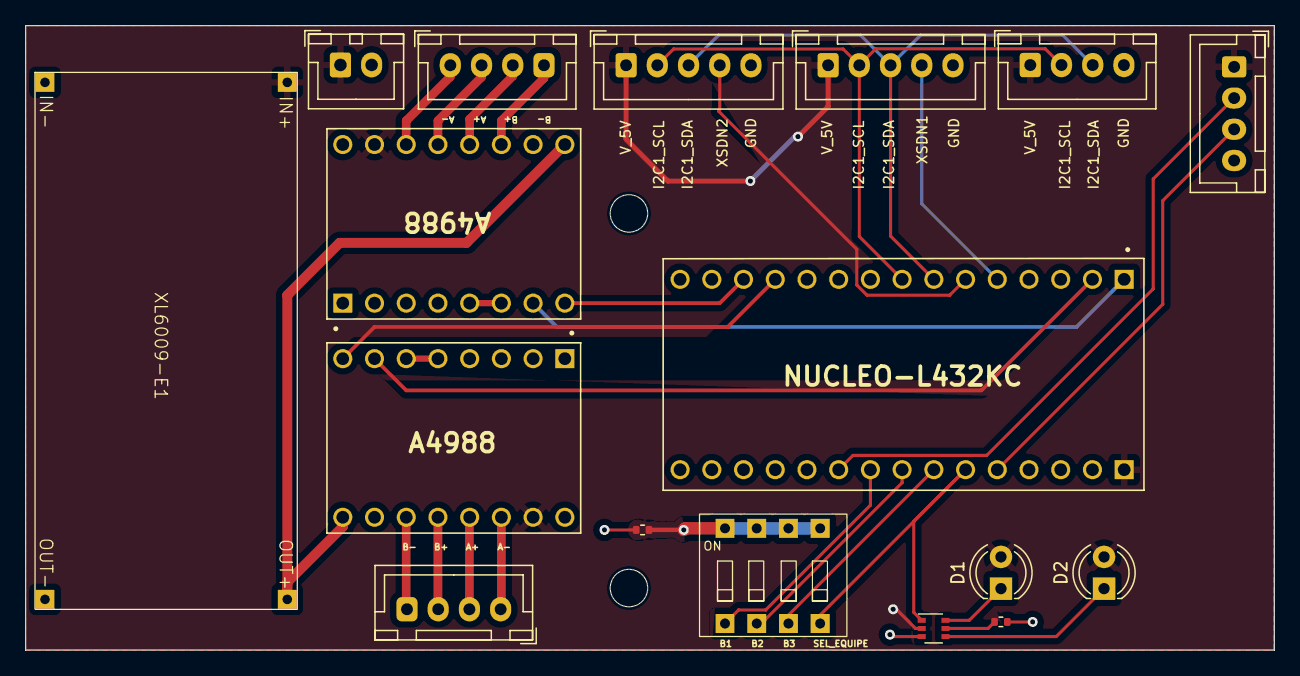
[picture p56: board carte_generale.kicad_pcb from above]

Board: 2 copper layers, 100.0 x 50.0 mm, 19 parts (0 on the bottom side), 31 nets.

Parts:
D1: LED_BLEU; LED_D4.0mm
D2: LED_JAUNE; LED_D4.0mm
H1, H2: MountingHole; MountingHole_3mm
J1: JST_XH_2_pins; JST_XH_B2B-XH-A_1x02_P2.50mm_Vertical
J2, J4: Conn_01x05_Pin; JST_XH_B5B-XH-A_1x05_P2.50mm_Vertical
J3, J5, J6, J7: JST_XH_4_pins; JST_XH_B4B-XH-A_1x04_P2.50mm_Vertical
R1, R2: R; R_0402_1005Metric
U2, U3: MODULE_A4988_STEPPER_MOTOR_DRIVER_CARRIER
U4: MODULE_NUCLEO-L432KC
U5: EDG104S
U7: SOT-363_SC-70-6
Ue: XL6009-E1

Connections:
BINARY_1: U4.22 (A3), U5.1
BINARY_2: U4.23 (A4), U5.2
BINARY_3: U4.24 (A5), U5.3
DIR1: U2.8 (DIRECTION), U4.12 (D9)
DIR2: U3.8 (DIRECTION), U4.13 (D10)
GND: J1.2, J2.5, J3.4, J4.5, J7.4, R1.2, R2.2, U2.10 (GND), U2.16 (GND), U3.10 (GND), U3.16 (GND), U4.4 (GND), U4.29 (GND), U7.3 (GND), Ue.2 (IN-), Ue.4 (OUT-)
I2C1_SCL: J2.2, J3.2, J4.2, U4.8 (D5)
I2C1_SDA: J2.3, J3.3, J4.3, U4.7 (D4)
M1_A+: J5.3, U2.13 (1A)
M1_A-: J5.4, U2.14 (1B)
M1_B+: J5.2, U2.12 (2A)
M1_B-: J5.1, U2.11 (2B)
M2_A+: J6.3, U3.13 (1A)
M2_A-: J6.4, U3.14 (1B)
M2_B+: J6.2, U3.12 (2A)
M2_B-: J6.1, U3.11 (2B)
MUX_INPUT_1: D1.1 (K), U7.6 (NO)
MUX_INPUT_2: D2.1 (K), U7.4 (NC)
MUX_OUTPUT: R1.1, U7.5 (COM)
unnamed: R2.1, U5.5, U5.6, U5.7, U5.8
unnamed: U2.5 (~RESET), U2.6 (~SLEEP)
unnamed: U3.5 (~RESET), U3.6 (~SLEEP)
SELECT_EQUIPE: U4.25 (A6), U5.4, U7.1 (IN)
STEP1: U2.7 (STEP), U4.2 (D0/RX)
STEP2: U3.7 (STEP), U4.1 (D1/TX)
UART2_RX: J7.2, U4.21 (A2)
UART2_TX: J7.3, U4.26 (A7)
V_5V: D1.2 (A), D2.2 (A), J1.1, J2.1, J3.1, J4.1, J7.1, U2.15 (VDD), U3.15 (VDD), U4.30 (VIN), U7.2 (V+), Ue.1 (IN+)
V_9V: U2.9 (VMOT), U3.9 (VMOT), Ue.3 (OUT+)
XSDN1: J2.4, U4.5 (D2)
XSDN2: J4.4, U4.6 (D3)
