AREM-Projets/CdR-2024/Robot/PCBs/Carte_mise_en_serie/Carte.kicad_pcb

## KiCad design Robot/PCBs/Carte_mise_en_serie/Carte.kicad_pcb (2024-03-29)

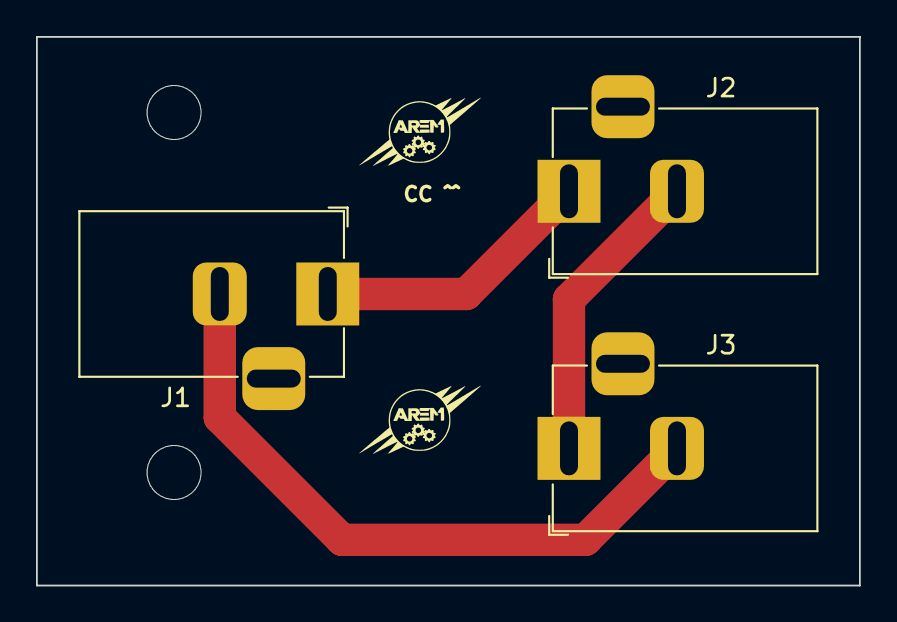
[picture p57: board Carte.kicad_pcb from above]

Board: 2 copper layers, 45.7 x 30.5 mm, 5 parts (0 on the bottom side), 2 nets.

Parts:
H1, H2: MountingHole; MountingHole_3mm
J1, J2, J3: Conn_01x02_Pin; BarrelJack_Horizontal

Connections:
unnamed: J1.1, J2.1
unnamed: J1.2, J1.3, J2.2, J3.1, J3.2, J3.3
