AREM-Projets/CdR-2024/Robot/PCBs/Alim-5V/power_supply_5V.kicad_pcb

## KiCad design Robot/PCBs/Alim-5V/power_supply_5V.kicad_pcb (2024-03-29)

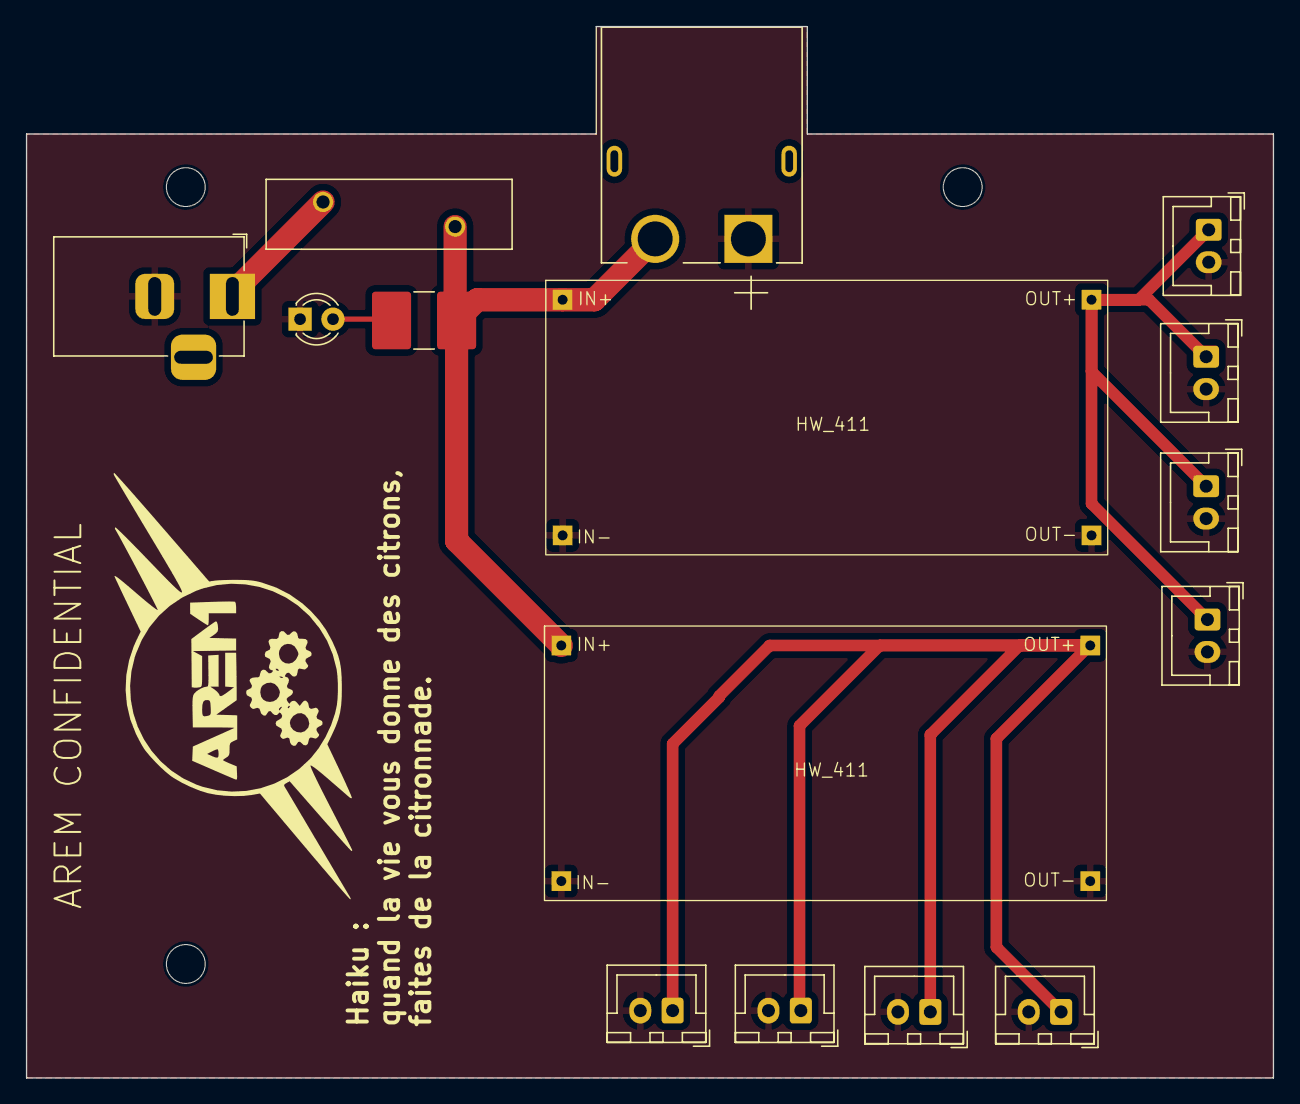
[picture p58: board power_supply_5V.kicad_pcb from above]

Board: 2 copper layers, 96.3 x 81.2 mm, 19 parts (1 on the bottom side), 6 nets.

Parts:
D1: LED; LED_D3.0mm
F1: Fuse; Fuse_BelFuse_0ZRE0100FF_L18.7mm_W5.1mm
H2, H3: MountingHole; MountingHole_3mm
He: MountingHole; MountingHole_3mm
J1: Conn_Jack; BarrelJack_Horizontal
J2, J3, J4, J5, J6, J7, J8, J9: Conn_JST_XH_2_pins; JST_XH_B2B-XH-A_1x02_P2.50mm_Vertical
J10: Conn_01x02_Pin; AMASS_XT60PW-M
Logo arem: LOGO; logo_arem
R1: R; R_2816_7142Metric
U1, U2: HW_411

Connections:
GND: D1.1 (K), J1.2, J2.2, J3.2, J4.2, J5.2, J6.2, J7.2, J8.2, J9.2, J10.1, U1.2 (IN-), U1.4 (OUT-), U2.2 (IN-), U2.4 (OUT-)
unnamed: D1.2 (A), R1.2
unnamed: F1.1, J1.1
VIN: F1.2, J10.2, R1.1, U1.1 (IN+), U2.1 (IN+)
VOUT_1: J2.1, J3.1, J4.1, J5.1, U1.3 (OUT+)
VOUT_2: J6.1, J7.1, J8.1, J9.1, U2.3 (OUT+)
