AREM-Projets/CdR-2024/Robot/PCBs/Extension_nucleo/nucleo_expansion.kicad_pcb

## KiCad design Robot/PCBs/Extension_nucleo/nucleo_expansion.kicad_pcb (2024-03-29)

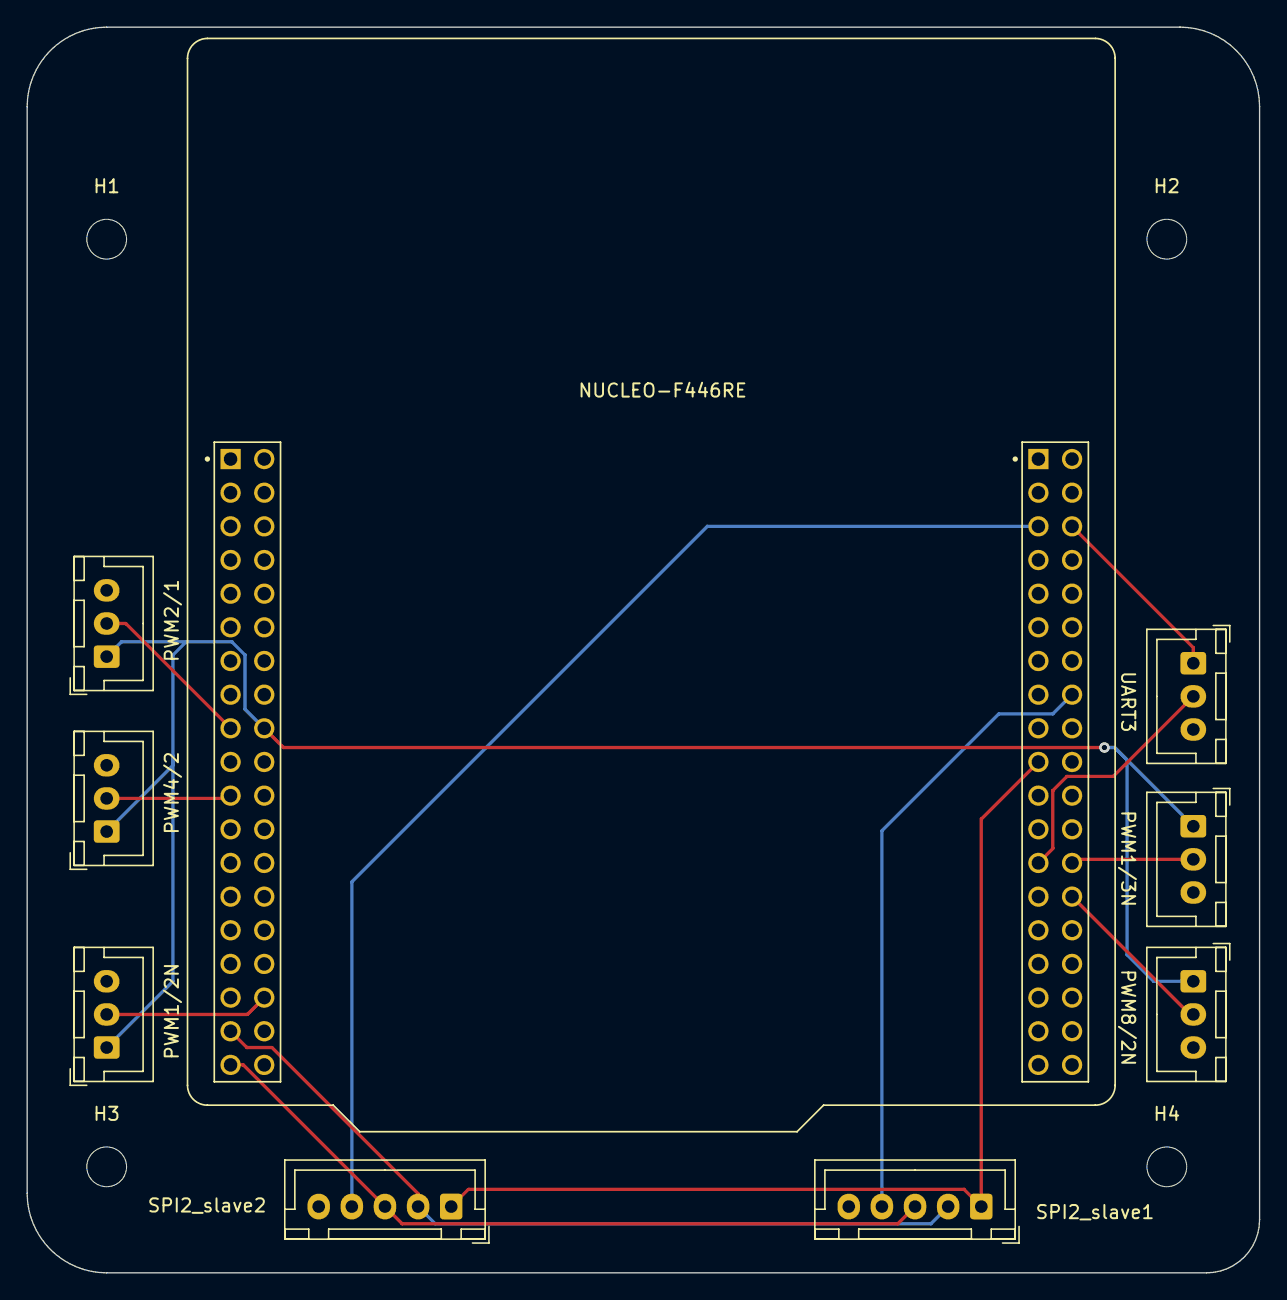
[picture p59: board nucleo_expansion.kicad_pcb from above]

Board: 2 copper layers, 93.0 x 94.0 mm, 14 parts (0 on the bottom side), 14 nets.

Parts:
H1, H2, H3, H4: MountingHole; MountingHole_3mm
J1: SPI2_slave1; JST_XH_B5B-XH-A_1x05_P2.50mm_Vertical
J2: SPI2_slave2; JST_XH_B5B-XH-A_1x05_P2.50mm_Vertical
J3: UART3; JST_XH_B3B-XH-A_1x03_P2.50mm_Vertical
J4: PWM2/1; JST_XH_B3B-XH-A_1x03_P2.50mm_Vertical
J5: PWM4/2; JST_XH_B3B-XH-A_1x03_P2.50mm_Vertical
J6: PWM1/2N; JST_XH_B3B-XH-A_1x03_P2.50mm_Vertical
J7: PWM1/3N; JST_XH_B3B-XH-A_1x03_P2.50mm_Vertical
J8: PWM8/2N; JST_XH_B3B-XH-A_1x03_P2.50mm_Vertical
Logo arem: LOGO; logo_arem
U1: NUCLEO-F446RE; MODULE_NUCLEO-F446RE

Connections:
+5V: J4.1, J5.1, J6.1, J7.1, J8.1, U1.CN7_18 (CN7_+5V)
GND: J1.5, J2.5, J3.3, J4.3, J5.3, J6.3, J7.3, J8.3, U1.CN7_8 (CN7_GND), U1.CN7_19 (CN7_GND), U1.CN7_20 (CN7_GND), U1.CN7_22 (CN7_GND), U1.CN10_9 (CN10_GND), U1.CN10_20 (CN10_GND), U1.CN10_32 (AGND)
PWM1/2N: J6.2, U1.CN7_34 (PB0)
PWM1/3N: J7.2, U1.CN10_26 (PB15)
PWM2/1: J4.2, U1.CN7_17 (PA15)
PWM4/2: J5.2, U1.CN7_21 (PB7)
PWM8/2N: J8.2, U1.CN10_28 (PB14)
SPI2_CS1: J1.4, U1.CN10_16 (PB12)
SPI2_CS2: J2.4, U1.CN10_5 (PB9)
SPI2_MISO: J1.2, J2.2, U1.CN7_35 (PC2)
SPI2_MOSI: J1.3, J2.3, U1.CN7_37 (PC3)
SPI2_SCK: J1.1, J2.1, U1.CN10_19 (PC7)
UART3_RX: J3.1, U1.CN10_6 (PC5)
UART3_TX: J3.2, U1.CN10_25 (PB10)
