AREM-Projets/CdR-2024/Robot/Code/stm32_to_ros/Core/Src/main.cpp

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
/* Includes ------------------------------------------------------------------*/
#include "main.h"

/* USER CODE BEGIN Includes */
#include <string.h>
#include <stdlib.h>
#include <stdio.h>
#include "XNucleoIHM02A1.h"
#include "BlocMoteurs.hpp"
#include "Embase3Roues.hpp"
#include <math.h>
#include <sys/wait.h>

/* USER CODE END Includes */

SPI_HandleTypeDef hspi1;
SPI_HandleTypeDef hspi2;

TIM_HandleTypeDef htim1;
TIM_HandleTypeDef htim2;
TIM_HandleTypeDef htim4;
TIM_HandleTypeDef htim8;

UART_HandleTypeDef huart2;
UART_HandleTypeDef huart3;
/* USER CODE BEGIN PV */

//Flag to control a timeout state
//Timeout occurs if no data was received from serial in a long time
bool timeout_moteurs = false;

//Class handling motors
BlocMoteurs *moteurs;
Embase3Roues *embase;

volatile bool motors_busy;
volatile bool movement_allowed;
volatile bool init_requested = false;

//Equipes
volatile uint8_t equipe = 0;


uint8_t uart_received_char;

/* USER CODE END PV */

void SystemClock_Config(void);
static void MX_GPIO_Init(void);
static void MX_USART2_UART_Init(void);
static void MX_TIM2_Init(void);
static void MX_SPI1_Init(void);
static void MX_SPI2_Init(void);
static void MX_TIM1_Init(void);
static void MX_TIM4_Init(void);
static void MX_TIM8_Init(void);
static void MX_USART3_UART_Init(void);

/* USER CODE BEGIN PFP */
void setDefaultInstructions(Embase3Roues *e);

/* USER CODE END PFP */

/**
 * @brief  The application entry point.
 * @retval int
 */
int main(void) {
	/* MCU Configuration--------------------------------------------------------*/

	/* Reset of all peripherals, Initializes the Flash interface and the Systick. */
	HAL_Init();

	/* Configure the system clock */
	SystemClock_Config();

	/* Initialize all configured peripherals */
	MX_GPIO_Init();
	MX_USART2_UART_Init();
	MX_TIM2_Init();
	MX_SPI1_Init();
	MX_SPI2_Init();
	MX_TIM1_Init();
	MX_TIM4_Init();
	MX_TIM8_Init();
	MX_USART3_UART_Init();
	/* USER CODE BEGIN 2 */

	//Start Timer2 interrupt (every 20 ms here)
	HAL_TIM_Base_Start_IT(&htim2);

	HAL_UART_Receive_IT(&huart2, &uart_received_char, sizeof(uint8_t));

	//Init motor class
	/* moteurs = new BlocMoteurs(&hspi1, reset_shield_1_GPIO_Port,
			reset_shield_1_Pin, ssel1_GPIO_Port, ssel1_Pin,
			reset_shield_2_GPIO_Port, reset_shield_2_Pin, ssel2_GPIO_Port,
			ssel2_Pin); */

	embase = new Embase3Roues(&hspi1, reset_shield_1_GPIO_Port,
			reset_shield_1_Pin, ssel1_GPIO_Port, ssel1_Pin,
			reset_shield_2_GPIO_Port, reset_shield_2_Pin, ssel2_GPIO_Port,
			ssel2_Pin);

	//Set microstepping to 128 for smooth rotations
	// moteurs->set_microstepping_mode(step_mode_t::STEP_MODE_HALF);
	// moteurs->set_max_speed_moteurs(W_MAX); //Vitesse de rotation max des moteur pour eviter erreur en position

	embase->set_microstepping_mode(step_mode_t::STEP_MODE_HALF);
	embase->set_max_speed_moteurs(W_MAX);
	//Set max acc to 1 rad/s^2
	//moteurs->set_max_acc_moteurs(1);

	setDefaultInstructions(embase);
	movement_allowed = false; // Wait for "s" to start

	HAL_UART_Transmit(&huart2, (uint8_t *) "Init OK\n", 8*sizeof(char), 1000);
	/* USER CODE END 2 */

	/* Infinite loop */
	/* USER CODE BEGIN WHILE */
	while (1) {
		// Pas touche
		if (init_requested)
		{
			init_requested = false;
			setDefaultInstructions(embase);
			movement_allowed = false;
		}

		embase->executeInstruction();

		/* USER CODE END WHILE */

		/* USER CODE BEGIN 3 */
	}
	/* USER CODE END 3 */
}

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
/* USER CODE BEGIN 4 */

// Init instructions
void setDefaultInstructions(Embase3Roues *e)
{
	e->init();

	switch(equipe){
	// Modifier les lignes suivantes pour changer les déplacements...
	case(BLEU):
		e->appendWait(1000);
		e->appendRelativeMove(0, 1.556, 0);
		e->appendWait(1000);
		e->appendRelativeMove(0, 0, -40);
		e->appendWait(1000);
		e->appendRelativeMove(0, 1.228, 0);
		e->appendWait(10000);

	case(JAUNE):
		e->appendWait(1000);
		e->appendRelativeMove(0, -1.761, 0);
		e->appendWait(1000);
		e->appendRelativeMove(0, 0, 40);
		e->appendWait(1000);
		e->appendRelativeMove(0, -1.076, 0);
		e->appendWait(10000);

	default:
		break;
	}
}

// GPIO interrupt
void HAL_GPIO_EXTI_Callback(uint16_t GPIO_Pin) {
	if (GPIO_Pin == GPIO_PIN_0) {
		// Motors are busy when pin low. Rising edge -> no longer busy
		motors_busy = false;
	}
}

//Redirect Uart callback to msg_handler if huart is huart2 peripheral
void HAL_UART_TxCpltCallback(UART_HandleTypeDef *huart) {

}

//Redirect Uart callback to msg_handler if huart is huart2 peripheral
void HAL_UART_RxCpltCallback(UART_HandleTypeDef *huart) {
	if(huart->Instance == USART2)
	{
		switch(uart_received_char)
		{
		case 's':
			movement_allowed = true;
			break;

		case 'w':
			movement_allowed = false;
			break;

		case 'i':
			init_requested = true;

		case 'b':
			equipe = BLEU;

		case 'j':
			equipe = JAUNE;

		default:
			break;
		}

		// ALWAYS READ UART
		HAL_UART_Receive_IT(&huart2, &uart_received_char, sizeof(uint8_t));
	}
}

//Timer 2 interrupt (every 20ms)
void HAL_TIM_PeriodElapsedCallback(TIM_HandleTypeDef *htim) {

}

/* USER CODE END 4 */
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
