AREM-Projets/CdR-2024/(commit log)

2023-11-17 j'ai mis des README partout
    [Exemple.ipt, Exemple.stl]
2023-11-20 update des README
2023-12-02 Ajout embase 2023
    [Attache_moteur_3.0_renforcee.ipt, Bielette.ipt, Exemple.ipt, Exemple.stl, cache-suspensions.ipt, embase_monobloc_renforcee_allegee_e10_1.2.ipt]
2023-12-02 embase 3 roues
    [embase_tricorps_1.0.ipt]
2024-01-20 taille composants
    [composants.csv]
2024-02-08 carte alim v1 partial deposit
    [power_supply_5V-B_Cu.gbr, power_supply_5V-B_Mask.gbr, power_supply_5V-B_Paste.gbr, power_supply_5V-B_Silkscreen.gbr, power_supply_5V-Edge_Cuts.gbr, power_supply_5V-F_Cu.gbr, power_supply_5V-F_Mask.gbr, power_supply_5V-F_Paste.gbr]
2024-02-10 Ajout roues PAMI
    [Roue_pami_V4.ipt, Roue_pami_V4.stl]
2024-02-10 Carte mise en serie
    [Carte-B_Cu.gbr, Carte-B_Mask.gbr, Carte-B_Paste.gbr, Carte-B_Silkscreen.gbr, Carte-Edge_Cuts.gbr, Carte-F_Cu.gbr, Carte-F_Mask.gbr, Carte-F_Paste.gbr]
2024-02-10 ajout alim 5V
    [power_supply_5V-B_Cu.gbr, power_supply_5V-B_Mask.gbr, power_supply_5V-B_Paste.gbr, power_supply_5V-B_Silkscreen.gbr, power_supply_5V-Edge_Cuts.gbr, power_supply_5V-F_Cu.gbr, power_supply_5V-F_Mask.gbr, power_supply_5V-F_Paste.gbr]
2024-02-10 mise a jour carte serie
    [Carte-B_Cu.gbr, Carte-B_Mask.gbr, Carte-B_Paste.gbr, Carte-B_Silkscreen.gbr, Carte-Edge_Cuts.gbr, Carte-F_Cu.gbr, Carte-F_Mask.gbr, Carte-F_Paste.gbr]
2024-02-12 Upload Support-batterie
    [support batterie.ipt]
2024-02-22 Rectification support batterie
    [support batterie.ipt]
2024-03-15 Code raspi4 et stm32 capteurs et actionneurs
2024-03-18 PCB PAMI + carte d'extension Nucleo-64
    [carte_generale.kicad_pcb, carte_generale.kicad_sch, nucleo_expansion.kicad_pcb, nucleo_expansion.kicad_sch]
2024-03-29 ajout gerber pour les pcb carte d'extention nucléo et pami
    [carte_generale-B_Cu.gbr, carte_generale-B_Mask.gbr, carte_generale-B_Paste.gbr, carte_generale-B_Silkscreen.gbr, carte_generale-Edge_Cuts.gbr, carte_generale-F_Cu.gbr, carte_generale-F_Mask.gbr, carte_generale-F_Paste.gbr]
2024-03-29 Commit 1 du pcb pamis commandé
    [carte_generale-B_Cu.gbr, carte_generale-B_Mask.gbr, carte_generale-B_Paste.gbr, carte_generale-B_Silkscreen.gbr, carte_generale-Edge_Cuts.gbr, carte_generale-F_Cu.gbr, carte_generale-F_Mask.gbr, carte_generale-F_Paste.gbr]
2024-03-29 correction DRC
    [carte_generale.kicad_pcb, carte_generale.kicad_sch]
2024-04-02 Ajout partie actionneurs + infos dans readme robot
    [carte_generale-B_Cu.gbr, carte_generale-B_Mask.gbr, carte_generale-B_Paste.gbr, carte_generale-B_Silkscreen.gbr, carte_generale-Edge_Cuts.gbr, carte_generale-F_Cu.gbr, carte_generale-F_Mask.gbr, carte_generale-F_Paste.gbr]
2024-04-15 Changement de nom et 3D PAMI
    [Exemple.ipt, Exemple.stl, POUPLY_P1_moteur.ipt, POUPLY_P2_base_V2.ipt, POUPLY_P3_batterie_support_V2.ipt, Roue_pami_V4.ipt, Roue_pami_V4.stl]
2024-04-22 Code actionneur avec 1 TOF Fiable
    [Ensemble1.0001.iam, Ensemble1.iam, Part11.0008.ipt, Part11.ipt, Part11.stl, Pièce2.ipt, Support2.0001.ipt, Support2.ipt]
2024-04-22 Retrait de fichiers pas concernes par cette branche et a l'origine de conflits (PCB)
    [Carte-B_Cu.gbr, Carte-B_Mask.gbr, Carte-B_Paste.gbr, Carte-B_Silkscreen.gbr, Carte-Edge_Cuts.gbr, Carte-F_Cu.gbr, Carte-F_Mask.gbr, Carte-F_Paste.gbr]
2024-04-23 Nouveaux composants du PAMI
    [POUPLY_P2_base_V2.ipt, POUPLY_P3_batterie_support_V2.ipt, POUPLY_P4_V3.ipt, POUPLY_P5_V2.ipt]
2024-04-28 Changement de nom
2024-04-29 Fin du modèle 3D du PAMI
    [POUPLY_P6.ipt, POUPLY_ROUE.ipt]
2024-04-30 mise a jour code raspi4: tirette, selecteur equipe, affichage score
2024-05-02 Mise a jour code embase avec tirette et selecteur equipe
    [BAU.ipt, Ensemble1.0012.iam, Ensemble1.iam, actionneur_Support2.ipt, actionneur_doigt.ipt, arbre_d_attache (1).ipt, batt.ipt, couvercle_3roues2.ipt]
2024-05-03 corrections pour la tirette et ajout commentaires
    [main.py]
2024-05-06 rotation cassée, UART ok
2024-05-06 modif pin selecteur equipe + piece tirette + pinout raspi4 pio
    [Pièce1.0002.ipt, Pièce1.ipt, Pièce1.stl]
2024-05-07 UART + movement OK
2024-05-08 Réparation de git
2024-05-08 mise au point communication embase raspi pour les matchs. version avec que equipe bleue !
2024-05-09 correction ordre initialisation embase
    [main.py]
2024-05-09 fix sens fov jaune bleu
    [main.py]
2024-05-09 fix arret 90s 1
    [main.py]
2024-05-09 fix : retrait wait avant init
    [main.py]
2024-05-09 correctif pts match 2
    [main.py]
2024-05-09 ajout redemarrage apres arret par detecction lidar (v1)
2024-05-10 code fiable sans redemarrage apres arret par detection lidar
2024-05-10 modif detection lidar
2024-05-10 nouvelle version evitement lidar (FOV 100, Dist 35cm)
2024-05-10 modif detection lidar et redemarrage v1
2024-05-10 switch to strat 6 panneaux
2024-05-10 fix temps entre mesures
    [main.py]
2024-05-10 fix utilisation angles mesures plutot que dates
    [main.py]
2024-05-10 version match 4 fiable avec lidar et reprise de mouvement
