AREM-Projets/CdR-2024/(notices)

Notices in the files:
Robot/Code/stm32_to_ros/Core/Src/main.cpp:
Copyright (c) 2023 STMicroelectronics.
All rights reserved.
This software is licensed under terms that can be found in the LICENSE file
PAMIs/Code/Code_PAMI_CDR_official/Core/Inc/main.h:
Copyright (c) 2024 STMicroelectronics.
